ltejedorcruz/TierraViva/memoria/anexos/esquemas_electricos.tex

\chapter{Esquemas eléctricos del prototipo}
\label{anexo:esquemas_electricos}

Este anexo recoge los esquemas eléctricos de referencia utilizados durante el diseño y montaje del prototipo TierraViva.

Los esquemas incluidos tienen carácter técnico y documental. Sirven como apoyo visual para comprender la arquitectura física del montaje y se complementan con las tablas de conexión detalladas recogidas en el manual de instalación.

\section{Esquema general de una estación}

La Figura~\ref{fig:esquema_estacion_tierraviva} muestra el esquema general de una estación TierraViva elaborado en Cirkit Designer. En él se representa la conexión entre la batería de 12 V, el regulador LM2596, el Arduino UNO, los sensores, el módulo LTE A7670E-LASA, el relé y la bomba de 12 V.

\begin{figure}[H]
    \centering
    
    \caption{Esquema eléctrico general de una estación TierraViva elaborado en Cirkit Designer. Elaboración propia.}
    \label{fig:esquema_estacion_tierraviva}
\end{figure}

\section{Bloques representados en el esquema}

El esquema de la estación puede dividirse en varios bloques funcionales:

\begin{itemize}
    \item \textbf{Alimentación}: formada por una batería de 12 V y un regulador LM2596 ajustado a 5 V para alimentar la electrónica de control.
    \item \textbf{Control}: formado por el Arduino UNO, encargado de leer sensores, gestionar comunicaciones y controlar el relé.
    \item \textbf{Sensorización}: formada por el sensor capacitivo de humedad del suelo, el BME280 y el BH1750.
    \item \textbf{Comunicación}: formada por el módulo LTE A7670E-LASA y su antena.
    \item \textbf{Actuación}: formada por el módulo relé y la bomba de agua de 12 V.
    \item \textbf{Protección y estabilización}: formada por resistencias, condensadores, diodo y elementos auxiliares de acondicionamiento eléctrico. Incluye el divisor resistivo de adaptación hacia el módulo LTE, los condensadores de desacoplo de alimentación, el condensador electrolítico de \(2200~\mu\mathrm{F}\) y el diodo asociado a la rama de bomba para mejorar la estabilidad y protección eléctrica durante la conmutación del motor.
\end{itemize}

\section{Correspondencia con el cableado del prototipo}

La Tabla~\ref{tab:correspondencia_esquema_cableado} resume la correspondencia entre los principales bloques del esquema y las conexiones descritas en el manual de instalación.

\begingroup
\renewcommand{\arraystretch}{1.35}
\scriptsize
\rowcolors{2}{TableRowSoft}{white}

\begin{longtable}{|p{0.28\textwidth}|p{0.28\textwidth}|p{0.34\textwidth}|}

\hline
\rowcolor{URJCRed}
\TVHead{Bloque} & \TVHead{Elemento principal} & \TVHead{Función dentro de la estación} \\
\hline
\endfirsthead

\hline
\rowcolor{URJCRed}
\TVHead{Bloque} & \TVHead{Elemento principal} & \TVHead{Función dentro de la estación} \\
\hline
\endhead

\hline
\multicolumn{3}{r}{\small Continúa en la página siguiente} \\
\endfoot

\hline
\endlastfoot

Alimentación & Batería 12 V y LM2596 & Proporcionar alimentación de potencia y tensión regulada de 5 V para la electrónica. \\
\hline
Control & Arduino UNO & Coordinar lectura de sensores, publicación de datos y actuación sobre el relé. \\
\hline
Comunicación & A7670E-LASA & Enviar telemetría a ThingSpeak mediante red móvil LTE. \\
\hline
Sensorización ambiental & BME280 y BH1750 & Medir temperatura, humedad relativa, presión y luminosidad. \\
\hline
Sensorización de suelo & Sensor capacitivo de humedad & Medir el estado hídrico del sustrato mediante entrada analógica. \\
\hline
Actuación & Relé y bomba 12 V & Activar físicamente el riego cuando se cumplen las condiciones definidas. \\
\hline
Protección y estabilización & Divisor resistivo, condensadores y diodo & Acondicionar señales, estabilizar la alimentación y reforzar la protección eléctrica de la rama de actuación. \\
\hline
\caption{Correspondencia entre el esquema eléctrico y los bloques funcionales de la estación.}
\label{tab:correspondencia_esquema_cableado}\\
\end{longtable}

\normalsize
\endgroup

\section{Notas de interpretación}

El esquema debe interpretarse como una representación del prototipo de estación desarrollado en TierraViva. Durante el montaje real deben comprobarse siempre los siguientes puntos:

\begin{itemize}
    \item la salida del LM2596 debe estar ajustada a 5.0 V antes de alimentar el Arduino;
    \item todas las masas deben estar conectadas en común;
    \item el módulo A7670E-LASA debe alimentarse con una tensión compatible con su placa;
    \item la señal desde Arduino hacia el RX del módulo LTE debe adaptarse mediante divisor de tensión;
    \item la bomba de 12 V debe alimentarse desde la línea de potencia correspondiente y conmutarse mediante el relé;
    \item el relé debe utilizar el contacto normalmente abierto para que el sistema arranque con el riego desactivado;
    \item la electrónica debe protegerse frente a humedad, polvo y salpicaduras en pruebas exteriores.
\end{itemize}

\section{Referencias de diseño}

El esquema se ha elaborado como apoyo al montaje físico y a la documentación del prototipo. Durante el desarrollo se ha utilizado una versión de trabajo en Cirkit Designer y documentación auxiliar de conexionado:

\begin{itemize}
    \item Proyecto en Cirkit Designer: \url{https://app.cirkitdesigner.com/project/56e39eeb-b4bb-4151-9afe-028a0ed83c81}
    \item Documento auxiliar de trabajo: \url{https://github.com/ltejedorcruz/TierraViva/raw/main/docs/Circuit_Documentation_TierraViva.pdf}
\end{itemize}
