ltejedorcruz/TierraViva/memoria/capitulos/capitulo5.tex

\chapter{Implementación \textit{hardware} y \textit{firmware} de estaciones}
\label{cap:implementacion_hardware_firmware}

\begin{wrapfigure}{r}{0.22\textwidth}
    \vspace{-12pt}
    \centering
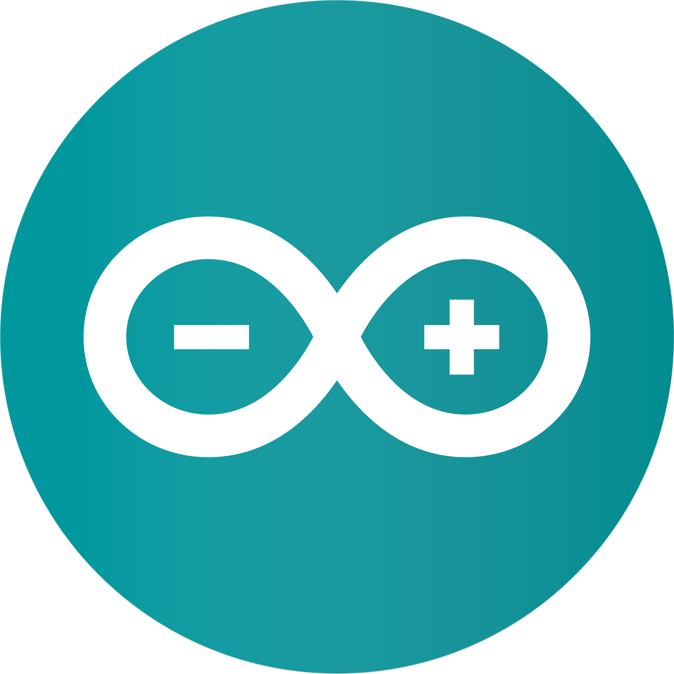
[picture p2: memoria/figs/arduino_logo.png]
    
    \caption{Logotipo de Arduino. Fuente: documentación oficial de marca de Arduino \cite{arduino_logo_guidelines}.}
    \label{fig:logo_arduino}
    \vspace{-8pt}
\end{wrapfigure}

Una vez definida la arquitectura final del sistema, este capítulo documenta la implementación \textit{hardware} y \textit{firmware} de las estaciones de campo de TierraViva. Se describe cómo se preparó, conectó y validó cada bloque de la estación: controlador, sensores, comunicación LTE, publicación de telemetría, actuación sobre el riego y alimentación.

En la arquitectura final, cada estación funciona como un nodo sensor-actuador autónomo: mide variables del entorno, evalúa reglas locales, acciona el riego cuando corresponde y publica su estado operativo. Por ello, la implementación \textit{hardware} y el \textit{firmware} tienen un papel central dentro del prototipo.

La Figura~\ref{fig:flujo_implementacion_estacion} resume la secuencia seguida durante la implementación de cada estación. El desarrollo se abordó por bloques para reducir riesgos: primero se verificó la placa de control, después la sensórica, posteriormente la comunicación LTE/HTTP y, finalmente, la actuación y alimentación del sistema de riego.

\begin{figure}[H]
    \centering
    \makebox[\textwidth][c]{%
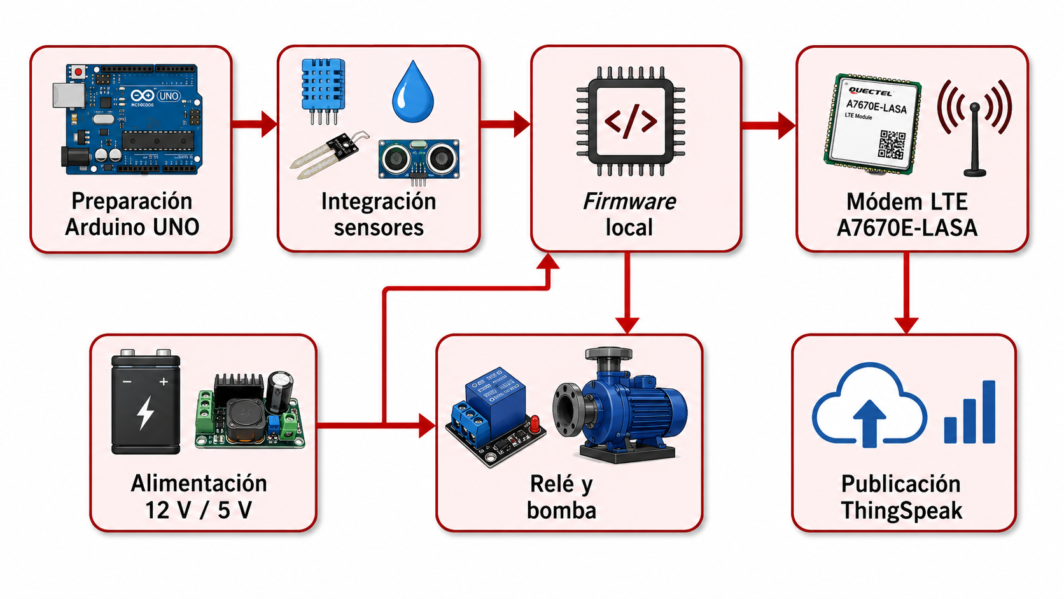
[picture p3: memoria/figs_png/flujo_implementacion_estacion.png]
        %
    }
    \caption{Secuencia de implementación de una estación TierraViva. Elaboración propia, véase Anexo~\ref{sec:uso_ia_generativa_tfg}.}
    \label{fig:flujo_implementacion_estacion}
\end{figure}

\section{Preparación de Arduino UNO}
\label{sec:preparacion_arduino_uno}

La primera fase consistió en verificar que la placa Arduino UNO compatible podía programarse correctamente desde Arduino IDE 2.3.8 en Windows 11. Aunque la placa recibía alimentación por USB, inicialmente no aparecía ningún puerto disponible en el entorno de desarrollo. La inspección del Administrador de dispositivos mostró el dispositivo como \texttt{USB2.0-Serial}, lo que permitió identificar la ausencia del controlador del conversor USB-serie \texttt{CH340G}. Tras instalar el controlador CH340/CH341, la placa quedó asociada al puerto \texttt{COM3} y fue posible cargar correctamente el ejemplo \textit{Blink} \cite{wch_ch340_driver}.

\begin{table}[H]
\begin{center}
\small
\renewcommand{\arraystretch}{1.15}
\rowcolors{2}{TableRowSoft}{white}

\begin{tabular}{|p{0.30\textwidth}|p{0.30\textwidth}|p{0.30\textwidth}|}
\hline
\rowcolor{URJCRed}
\TVHead{Elemento comprobado} & \TVHead{Resultado observado} & \TVHead{Acción realizada} \\
\hline
Sistema operativo & Windows 11 & Preparación del entorno en ordenador. \\
\hline
Entorno de desarrollo & Arduino IDE 2.3.8 & Instalación y configuración inicial. \\
\hline
Placa conectada & Arduino UNO compatible & Selección de placa Arduino Uno. \\
\hline
Detección inicial & \texttt{USB2.0-Serial} sin puerto COM disponible & Diagnóstico de ausencia de controlador. \\
\hline
Conversor USB-serie & \texttt{CH340G} & Instalación del controlador CH340/CH341. \\
\hline
Microcontrolador principal & \texttt{ATmega328P} & Validación de compatibilidad con Arduino UNO. \\
\hline
Puerto tras instalar controlador & \texttt{COM3} & Selección del puerto en Arduino IDE. \\
\hline
Prueba básica & \textit{Blink} cargado correctamente & Verificación de programación de la placa. \\
\hline
\end{tabular}
\caption{Preparación inicial del Arduino UNO compatible}
\label{cuadro:preparacion_arduino_uno}
\end{center}
\end{table}

Una vez identificado el conversor \texttt{CH340G}, se instaló el controlador correspondiente y Windows pasó a reconocer la placa como un dispositivo serie asociado al puerto \texttt{COM3}. A partir de ese momento, el Arduino IDE permitió seleccionar la placa como \textit{Arduino Uno} y cargar programas correctamente.

La primera validación fue el ejemplo \textit{Blink}, utilizado para comprobar la cadena completa de programación: detección USB, selección de placa, selección de puerto, compilación, carga y ejecución en el microcontrolador. La prueba fue correcta, por lo que la placa quedó preparada para integrar sensores, módem LTE y relé.

La identificación del ATmega328P y la correspondencia de pines del Arduino UNO se comprobaron tomando como referencia la documentación técnica y el esquema de pines de la placa \cite{arduino_uno_r3_datasheet,arduino_uno_r3_pinout}.

Esta incidencia se conserva en la memoria porque afecta a la reproducibilidad del prototipo. El uso de placas compatibles reduce el coste, pero puede exigir instalar controladores adicionales. Las evidencias de configuración y carga se recogen dentro del plan de pruebas del Anexo~\ref{anexo:plan_pruebas}.

\section{Integración de sensores}
\label{sec:integracion_sensores}

La integración de sensores se realizó antes de incorporar la comunicación LTE o la actuación, ya que la decisión local de riego depende de que las medidas de entrada sean coherentes. La estación combina sensores digitales conectados al bus I2C con un sensor capacitivo de humedad de suelo leído mediante entrada analógica.

La Figura~\ref{fig:topologia_sensores_estacion} resume esta organización. Los sensores BME280 y BH1750/GY-302 comparten las líneas \texttt{A4/SDA} y \texttt{A5/SCL} del Arduino UNO, mientras que el sensor capacitivo de humedad del suelo se conecta a la entrada \texttt{A0}. Esta separación permitió validar de forma independiente el bus digital y la lectura analógica antes de construir una muestra completa de telemetría.

\begin{figure}[H]
    \centering
    \makebox[\textwidth][c]{%
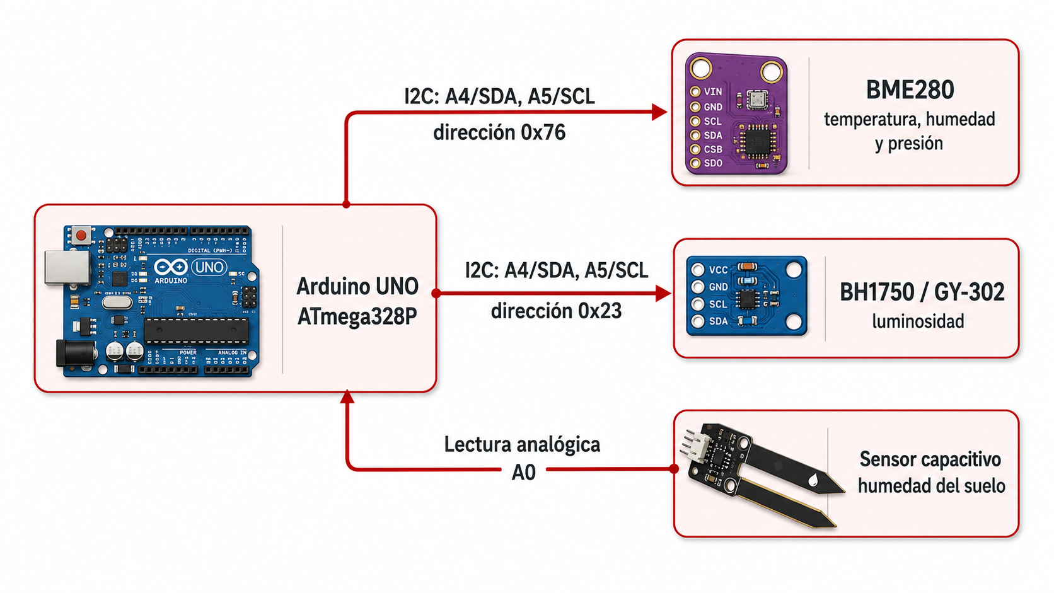
[picture p4: memoria/figs_png/topologia_sensores_estacion.png]
        %
    }
    \caption{Topología de sensórica de una estación TierraViva. Elaboración propia, véase Anexo~\ref{sec:uso_ia_generativa_tfg}.}
    \label{fig:topologia_sensores_estacion}
\end{figure}

\begin{table}[H]
\begin{center}
\small
\renewcommand{\arraystretch}{1.15}
\rowcolors{2}{TableRowSoft}{white}

\begin{tabular}{|p{0.28\textwidth}|p{0.28\textwidth}|p{0.34\textwidth}|}
\hline
\rowcolor{URJCRed}
\TVHead{Prueba} & \TVHead{Resultado} & \TVHead{Interpretación} \\
\hline
Escaneo I2C con BME280 & Dispositivo detectado en \texttt{0x76} & El sensor ambiental responde correctamente en el bus I2C. \\
\hline
Escaneo I2C con BH1750 y BME280 & Dispositivos detectados en \texttt{0x23} y \texttt{0x76} & Ambos sensores pueden compartir el bus I2C sin conflicto de direcciones. \\
\hline
Lectura analógica del sensor de suelo & Valores variables en \texttt{A0} & El sensor capacitivo responde ante cambios de capacitancia/humedad. \\
\hline
Prueba conjunta & Lectura de suelo, luz, temperatura, humedad y presión & Los tres sensores pueden integrarse en un único \textit{firmware} de adquisición. \\
\hline
\end{tabular}
\caption{Pruebas iniciales de validación de sensores}
\label{cuadro:pruebas_iniciales_sensores}
\end{center}
\end{table}

El sensor capacitivo de humedad del suelo se validó mediante lecturas brutas en \texttt{A0}. En reposo mostró valores estables alrededor de \texttt{569--570}, mientras que al modificar las condiciones de contacto descendió aproximadamente al rango \texttt{248--356}. Esta prueba no constituye una calibración agronómica definitiva, pero sí confirmó que el sensor respondía ante cambios físicos y que el sentido de variación era utilizable para la lógica de riego.

La integración conjunta confirmó que el sensor analógico no interfería con el bus I2C y que los sensores digitales podían trabajar simultáneamente. La humedad del suelo se mantuvo inicialmente como lectura dependiente de calibración, mientras que temperatura, humedad relativa, presión y luminosidad se conservaron como variables de contexto para interpretar el estado de la estación. Con ello quedó validado el bloque de sensórica antes de estructurar el \textit{firmware} de adquisición.

\section{\textit{Firmware} de adquisición}
\label{sec:firmware_adquisicion}

Una vez comprobado el funcionamiento de los sensores, el siguiente paso consistió en organizar el \textit{firmware} de adquisición de la estación. Este \textit{firmware} combina la lectura de variables, la preparación de telemetría y la lógica local necesaria para decidir si debe activarse el riego.

El \textit{firmware} se organiza en varios bloques funcionales. En primer lugar, se inicializan los sensores y el módem LTE. Después, en cada ciclo de ejecución, se leen las variables ambientales y de suelo. A partir de esas lecturas, se actualiza el estado interno de seguridad de la estación y se decide si procede activar el riego. Por último, la estación publica una actualización en ThingSpeak con las medidas y el estado operativo.

La Figura~\ref{fig:ciclo_firmware_estacion} sintetiza el ciclo lógico ejecutado por el \textit{firmware} de estación. La estación no depende de una orden externa para cerrar el ciclo de control: mide, valida, decide, actúa si procede y publica el estado resultante.

\begin{figure}[H]
    \centering
    \makebox[\textwidth][c]{%
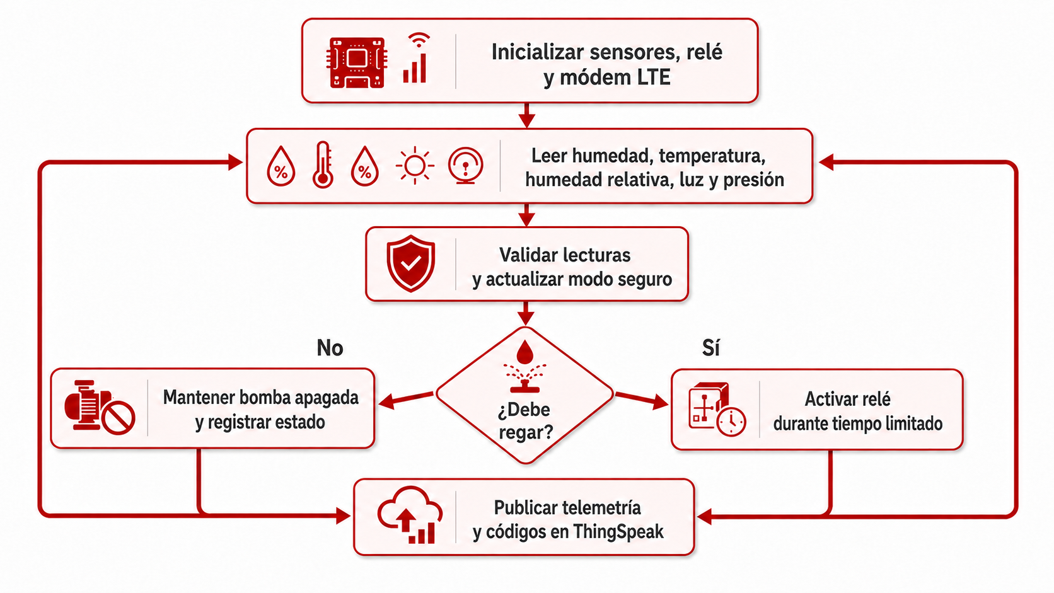
[picture p5: memoria/figs_png/ciclo_firmware_estacion.png]
        %
    }
    \caption{Ciclo lógico del \textit{firmware} de estación. Elaboración propia, véase Anexo~\ref{sec:uso_ia_generativa_tfg}.}
    \label{fig:ciclo_firmware_estacion}
\end{figure}

En la función \texttt{setup()} se configuran el puerto serie de depuración, el bus I2C, los sensores, el pin de relé y el módem LTE. El relé se inicializa en estado desactivado para que un reinicio del Arduino no pueda provocar una activación accidental de la bomba. Durante el ciclo principal, el \textit{firmware} lee las variables de suelo y ambiente, convierte la humedad del suelo a escala porcentual, valida las medidas y actualiza el estado interno de seguridad.

La lógica de decisión se apoya en variables como \texttt{safeMode}, \texttt{sensorOk}, \texttt{validCycleCount} y \texttt{dryCycleCount}. Además, diferencia entre el evento principal del sistema, almacenado en \texttt{systemEventCode}, y el código auxiliar de diagnóstico, almacenado en \texttt{debugCode}. Esta separación permite publicar en ThingSpeak no solo el estado de riego, sino también el motivo de la decisión.

Para evitar que el cuerpo principal de la memoria se convierta en un listado completo de \textit{firmware}, la Tabla~\ref{tab:responsabilidades_firmware_estacion} resume las responsabilidades principales implementadas en el código de estación. El código completo se mantiene en el repositorio del proyecto.

\begin{table}[H]
\centering
\small
\renewcommand{\arraystretch}{1.15}
\rowcolors{2}{TableRowSoft}{white}

\begin{tabular}{|p{0.28\textwidth}|p{0.58\textwidth}|}
\hline
\rowcolor{URJCRed}
\TVHead{Función del \textit{firmware}} & \TVHead{Responsabilidad dentro de la estación} \\
\hline
Lectura de sensores & Obtiene humedad de suelo, temperatura, humedad relativa, luminosidad y presión. \\
\hline
Conversión de humedad & Transforma la lectura analógica del sensor de suelo a una escala porcentual a partir de los valores de referencia configurados. \\
\hline
Validación de medidas & Detecta lecturas ausentes, incoherentes o no utilizables para tomar decisiones de riego. \\
\hline
Modo seguro & Mantiene un comportamiento conservador tras el arranque o ante error de sensores. \\
\hline
Confirmación de sequedad & Evita activar el riego por una lectura aislada o ruidosa. \\
\hline
\textit{cooldown} & Bloquea riegos consecutivos durante un periodo mínimo tras una actuación. \\
\hline
Publicación de estado & Actualiza el estado del relé, el evento de sistema y el código auxiliar de diagnóstico. \\
\hline
\end{tabular}
\caption{Responsabilidades principales del \textit{firmware} de estación.}
\label{tab:responsabilidades_firmware_estacion}
\end{table}

La decisión local se apoya en tres mecanismos: umbral de humedad, confirmación por ciclos consecutivos y tiempo mínimo entre riegos. No se activa el riego por una única lectura aislada, ya que una medida puntual puede verse afectada por ruido, contacto irregular del sensor o pequeñas variaciones del montaje. Además, el periodo de \textit{cooldown} evita activaciones repetidas en poco tiempo.

La función de decisión local se muestra en el Código~\ref{cod:decision_local_riego}. Si existe un error de sensores o un periodo de \textit{cooldown} activo, la estación no permite el riego y actualiza los códigos de estado correspondientes. Si no existe bloqueo, compara la humedad del suelo con el umbral normal o seguro según el estado interno de la estación.

\begin{code}[H]
\begin{lstlisting}[language=C++]
bool shouldIrrigate() {
  if (!sensorOk) {
    systemEventCode = 400;
    debugCode = 400;
    return false;
  }

  if (cooldownActive()) {
    systemEventCode = 429;
    debugCode = 429;
    return false;
  }

  if (safeMode) {
    return (soilPercent <= SAFE_SOIL_THRESHOLD) &&
           (dryCycleCount >= SAFE_CONFIRM_DRY_CYCLES);
  }

  return (soilPercent <= NORMAL_SOIL_THRESHOLD) &&
         (dryCycleCount >= NORMAL_CONFIRM_DRY_CYCLES);
}
\end{lstlisting}
\caption[Decisión local de riego en la estación]{Decisión local de riego en la estación}
\label{cod:decision_local_riego}
\end{code}

Cuando la estación decide regar, la actuación se realiza mediante una función temporizada de \textit{firmware}. Durante el riego, el evento principal se marca como \texttt{210}; al finalizar el intervalo configurado, el relé se apaga explícitamente y el evento pasa a \texttt{211}. De este modo, la parada de la bomba no depende de una orden externa ni de la Raspberry Pi.

Tras la lectura de sensores, la actualización del modo seguro y la posible actuación sobre el relé, el \textit{firmware} prepara el estado de la estación para su publicación. Esta publicación no se desarrolla en detalle en esta sección para evitar duplicidades, ya que la correspondencia completa entre variables y campos de ThingSpeak se documenta en la Sección~\ref{sec:envio_datos_thingspeak}.

De este modo, la estación conserva un ciclo completo de funcionamiento autónomo: mide, interpreta, decide, actúa cuando procede y deja preparado el estado operativo para su envío. La Raspberry Pi puede consultar posteriormente esos datos y representarlos en el \textit{dashboard}, pero no interviene en el cierre del bucle de control.

Las dependencias principales del \textit{firmware}, incluyendo las librerías utilizadas para comunicación serie, bus I2C, lectura de sensores y manejo de cadenas, se resumen en el Anexo~\ref{anexo:manual_instalacion_sistema}.

\section{Integración del A7670E-LASA}
\label{sec:integracion_a7670e}

La integración del A7670E-LASA fue una de las fases más sensibles de la estación, porque concentra comunicación serie, alimentación estable, registro en red móvil y publicación HTTP. Antes de conectarlo al Arduino, el módulo se validó de forma independiente mediante USB y comandos AT, comprobando respuesta básica, tarjeta SIM, cobertura, registro LTE, conectividad IP y capacidad de realizar peticiones HTTP.

\begin{table}[H]
\begin{center}
\small
\renewcommand{\arraystretch}{1.15}
\rowcolors{2}{TableRowSoft}{white}

\begin{tabular}{|p{0.30\textwidth}|p{0.26\textwidth}|p{0.34\textwidth}|}
\hline
\rowcolor{URJCRed}
\TVHead{Elemento comprobado} & \TVHead{Resultado} & \TVHead{Interpretación} \\
\hline
Puerto AT por USB & Correcto & El ordenador podía comunicarse con el módem mediante comandos AT. \\
\hline
Respuesta básica del módulo & Correcta & El comando \texttt{AT} devolvía respuesta válida. \\
\hline
Tarjeta SIM & Correcta & La SIM estaba preparada para operar en red. \\
\hline
Cobertura & Buena & La calidad de señal era suficiente para continuar las pruebas. \\
\hline
Registro LTE & Correcto & El módulo conseguía registrarse en la red móvil. \\
\hline
Datos móviles & Correctos & El módem obtenía conectividad IP. \\
\hline
Ping & Correcto & Se comprobó conectividad hacia Internet. \\
\hline
HTTP GET & Correcto & Se validó la capacidad de realizar peticiones HTTP y leer la respuesta. \\
\hline
\end{tabular}
\caption{Validación previa del módulo A7670E-LASA}
\label{cuadro:validacion_previa_a7670e}
\end{center}
\end{table}

Una vez validado el módulo por separado, se abordó la conexión con Arduino UNO. La comunicación se realiza mediante interfaz UART y comandos AT. Como el puerto serie \textit{hardware} del Arduino se utiliza también para programación y depuración por USB, se empleó \texttt{SoftwareSerial} para crear un puerto serie adicional destinado al módem. En el montaje de la estación se mantuvieron los pines \texttt{D10} y \texttt{D11}, ya cableados y probados durante las fases anteriores.

El pin \texttt{D10} del Arduino se utiliza como recepción del puerto serie software y se conecta al pin \texttt{TXD} del A7670E-LASA. El pin \texttt{D11} se utiliza como transmisión hacia el módem y se conecta al pin \texttt{RXD} del A7670E-LASA mediante un divisor resistivo. Esta adaptación es necesaria porque Arduino UNO trabaja con niveles lógicos de 5 V, mientras que la entrada serie del módulo no debe recibir directamente ese nivel si no existe adaptación integrada.

El divisor resistivo se dimensiona mediante la Ecuación~\ref{ec:divisor_resistivo_rxd}.

\begin{myequation}[h]
\begin{equation}
V_{\mathrm{RXD}} =
V_{\mathrm{TX,Arduino}}
\cdot
\frac{R_2}{R_1 + R_2}
\label{ec:divisor_resistivo_rxd}
\end{equation}
\caption[Cálculo de la tensión de salida del divisor resistivo]{Cálculo de la tensión aplicada a la entrada RXD del A7670E-LASA mediante un divisor resistivo}
\end{myequation}

En esta expresión, \(V_{\mathrm{TX,Arduino}}\) representa la tensión de salida del pin de transmisión del Arduino, \(R_1\) la resistencia situada entre el pin \texttt{D11} y el nodo conectado a \texttt{RXD}, y \(R_2\) la resistencia situada entre dicho nodo y masa. El objetivo de este divisor no es modificar la información transmitida por la UART, sino adaptar el nivel eléctrico de la señal para que la entrada \texttt{RXD} del módem no reciba directamente el nivel lógico de 5 V procedente del Arduino UNO.

La señal en sentido contrario, desde \texttt{TXD} del A7670E-LASA hacia \texttt{D10} del Arduino, no requiere el mismo divisor porque no procede de una salida lógica de 5 V del Arduino. Por tanto, la adaptación se aplica únicamente en el sentido Arduino~\(\rightarrow\)~módem.

La alimentación del módulo se trató como un aspecto crítico. Los módulos de comunicación celular pueden presentar consumos variables, especialmente durante el registro en red y la transmisión de datos, por lo que la alimentación y el cableado deben respetar las recomendaciones de diseño del fabricante y de la placa de evaluación utilizada \cite{simcom_a7670_hardware_design,waveshare_a7670e_hat}. En la estación, la alimentación parte de una fuente principal de 12 V y se regula mediante el LM2596 ajustado a 5 V para los elementos compatibles.

La integración funcional del módem se organizó en las fases resumidas en la Tabla~\ref{tab:fases_integracion_a7670e}. El detalle completo de comandos AT no se incluye en el cuerpo principal para evitar convertir el capítulo en una referencia de \textit{firmware}; se conserva en el código fuente del repositorio.

\begin{table}[H]
\centering
\small
\renewcommand{\arraystretch}{1.15}
\rowcolors{2}{TableRowSoft}{white}

\begin{tabular}{|p{0.26\textwidth}|p{0.58\textwidth}|}
\hline
\rowcolor{URJCRed}
\TVHead{Fase} & \TVHead{Comprobación realizada} \\
\hline
Comunicación básica & El módem responde a comandos AT desde Arduino. \\
\hline
SIM y red & La tarjeta SIM está operativa y el módulo consigue registrarse en red LTE. \\
\hline
Datos móviles & Se configura el APN y se activa el contexto de datos. \\
\hline
Conectividad IP & El módulo obtiene conectividad y puede ejecutar peticiones HTTP. \\
\hline
Publicación & La estación envía una actualización HTTP al canal ThingSpeak correspondiente. \\
\hline
Robustez & Si falla la red, el \textit{firmware} no bloquea indefinidamente el ciclo principal. \\
\hline
\end{tabular}
\caption{Fases funcionales de integración del A7670E-LASA.}
\label{tab:fases_integracion_a7670e}
\end{table}

En el \textit{firmware}, la comunicación con el módem se estabilizó a \texttt{9600} baudios, ya que \texttt{SoftwareSerial} en Arduino UNO puede volverse inestable a velocidades superiores. La configuración final combinó pines \texttt{D10}/\texttt{D11}, divisor resistivo hacia \texttt{RXD}, secuencia AT, activación de datos móviles y envío HTTP.

La gestión de errores se resolvió de forma conservadora: si el módem no responde, si el registro LTE no se completa, si falla el contexto de datos o si la respuesta HTTP no es válida, la estación marca la conectividad como no preparada y reintenta posteriormente sin bloquear el ciclo principal. Además, se tuvo en cuenta la memoria SRAM limitada del Arduino UNO, evitando URLs impresas completas, cadenas excesivas y búferes sobredimensionados.

El resultado de esta fase fue la integración estable del A7670E-LASA dentro de la estación de campo. El módulo quedó conectado al Arduino mediante UART software, con adaptación de nivel en la línea hacia \texttt{RXD}, alimentación estabilizada y una secuencia de comandos capaz de registrar el módem en red, activar datos móviles y realizar peticiones HTTP. El conexionado eléctrico, la adaptación de nivel y la alimentación estabilizada del módem se documentan en el Anexo~\ref{anexo:esquemas_electricos}.

\section{Envío de datos a ThingSpeak}
\label{sec:envio_datos_thingspeak}

Una vez integrados los sensores y validado el módulo LTE, la estación publica su telemetría en ThingSpeak mediante una petición HTTP GET de actualización de canal \cite{thingspeak_write_data}. El \textit{firmware} construye la URL de escritura con la clave de actualización del canal y los campos correspondientes a las variables medidas y al estado operativo de la estación. En la secuencia AT utilizada, esta operación se ejecuta mediante \texttt{AT+HTTPACTION=0}, donde el valor \texttt{0} corresponde a una operación HTTP GET.

La correspondencia completa entre \texttt{field1}--\texttt{field8}, variables internas y códigos de estado se documenta en el Anexo~\ref{anexo:estructura_thingspeak_estados}. En este capítulo interesa destacar el criterio de implementación: la publicación se considera correcta únicamente cuando el módem informa de una respuesta HTTP con código 200.

La Figura~\ref{fig:confirmacion_http_thingspeak} resume el criterio seguido por el \textit{firmware} para interpretar una publicación como correcta.

\begin{figure}[H]
\centering
\resizebox{\textwidth}{!}{%
\begin{tikzpicture}[
    node distance=1.8cm,
    actor/.style={
        draw=URJCRed,
        very thick,
        rounded corners,
        align=center,
        minimum width=3.0cm,
        minimum height=0.9cm,
        fill=URJCRed!8
    },
    msg/.style={-Latex, thick, draw=URJCRed!85!black},
    note/.style={align=center, font=\scriptsize}
]

\node[actor] (fw) {\textit{Firmware}\\Arduino UNO};
\node[actor, right=of fw] (modem) {A7670E-LASA\\módem LTE};
\node[actor, right=of modem] (net) {Red LTE\\Internet};
\node[actor, right=of net] (ts) {ThingSpeak\\canal};

\foreach \x in {fw,modem,net,ts}
    \draw[dashed, URJCRed!45] (\x.south) -- ++(0,-5.8);

\draw[msg] ([yshift=-1.0cm]fw.south) -- node[above, note] {Comando AT\\\texttt{AT+HTTPACTION=0}} ([yshift=-1.0cm]modem.south);

\draw[msg] ([yshift=-2.0cm]modem.south) -- node[above, note] {Petición HTTP\\actualización de canal} ([yshift=-2.0cm]net.south);

\draw[msg] ([yshift=-2.8cm]net.south) -- node[above, note] {Solicitud de escritura\\con campos \texttt{field1--field8}} ([yshift=-2.8cm]ts.south);

\draw[msg] ([yshift=-3.6cm]ts.south) -- node[above, note] {Respuesta HTTP\\\texttt{200 OK}} ([yshift=-3.6cm]net.south);

\draw[msg] ([yshift=-4.4cm]net.south) -- node[above, note] {Resultado de la operación} ([yshift=-4.4cm]modem.south);

\draw[msg] ([yshift=-5.2cm]modem.south) -- node[above, note] {\texttt{+HTTPACTION: 0,200,len}} ([yshift=-5.2cm]fw.south);

\node[note, below=5.9cm of modem] {
El \textit{firmware} interpreta el código HTTP 200 como confirmación funcional de publicación correcta.
};

\end{tikzpicture}
}
\caption{Confirmación funcional de publicación HTTP GET desde la estación hacia ThingSpeak. Elaboración propia, véase Anexo~\ref{sec:uso_ia_generativa_tfg}.}
\label{fig:confirmacion_http_thingspeak}
\end{figure}

La publicación de datos desde la estación se confirma a nivel de aplicación mediante el código de respuesta HTTP devuelto por ThingSpeak. Una vez habilitada la conectividad IP sobre LTE y ejecutada la petición HTTP GET, el \textit{firmware} interpreta la respuesta \texttt{+HTTPACTION: 0,200,len} como una publicación correcta, al indicar que la operación GET ha recibido un código HTTP 200.

Los reintentos se plantean de forma controlada: si una publicación falla, la estación vuelve a intentarlo en el siguiente ciclo de telemetría, evitando bucles indefinidos que puedan bloquear el \textit{firmware} o aumentar el consumo. Además, un fallo de publicación no afecta directamente a la seguridad del riego, ya que la decisión de actuación permanece en la estación. La consecuencia principal de una pérdida temporal de conectividad es la ausencia de una muestra en la nube, no la pérdida del control local de la bomba.

\section{Actuación y alimentación de la estación}
\label{sec:control_rele_led_bomba}
\label{sec:alimentacion_estacion}

La actuación física sobre el riego se realiza mediante un módulo relé controlado desde el Arduino UNO. El Arduino no alimenta la bomba directamente: únicamente gobierna la señal de control del relé, mientras que la bomba de agua recibe alimentación desde la línea de 12 V. Esta separación evita que la corriente de potencia circule por el microcontrolador y permite mantener un estado seguro por defecto.

La Figura~\ref{fig:alimentacion_actuacion_estacion} resume la distribución eléctrica utilizada en la estación. La línea principal de 12 V alimenta la carga de actuación y sirve como entrada al regulador LM2596, ajustado a 5 V para alimentar la electrónica de control. Todos los bloques comparten masa común para que las señales digitales, la comunicación serie y las lecturas de sensores tengan una referencia eléctrica válida.

\begin{figure}[H]
    \centering
    \makebox[\textwidth][c]{%
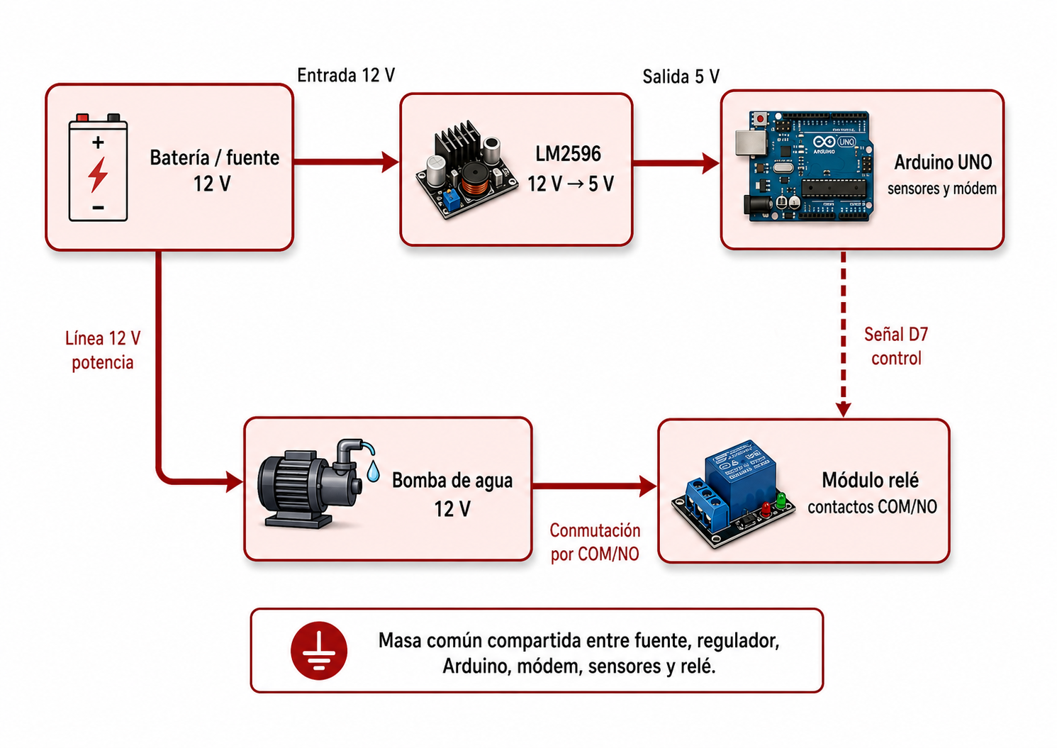
[picture p6: memoria/figs_png/alimentacion_actuacion_estacion.png]
        %
    }
\caption{Distribución de alimentación y actuación en una estación TierraViva. Elaboración propia, véase Anexo~\ref{sec:uso_ia_generativa_tfg}.}
\label{fig:alimentacion_actuacion_estacion}
\end{figure}

El pin digital \texttt{D7} se utiliza para controlar el relé. Este se inicializa apagado desde el arranque, de forma que un reinicio de la placa no pueda activar accidentalmente la bomba. La conexión de potencia utiliza los contactos \texttt{COM} y \texttt{NO}; al emplear el contacto normalmente abierto, la bomba permanece apagada mientras no exista una activación expresa desde el \textit{firmware}.

\begin{table}[H]
\centering
\small
\renewcommand{\arraystretch}{1.15}
\rowcolors{2}{TableRowSoft}{white}

\begin{tabular}{|p{0.30\textwidth}|p{0.54\textwidth}|}
\hline
\rowcolor{URJCRed}
\TVHead{Criterio aplicado} & \TVHead{Justificación técnica} \\
\hline
Relé apagado al arrancar & Evita activaciones accidentales durante reinicios. \\
\hline
Contacto normalmente abierto & La bomba permanece apagada si no existe activación expresa. \\
\hline
Actuación temporizada & La parada de la bomba no depende de una orden externa. \\
\hline
\textit{cooldown} entre riegos & Evita activaciones repetidas por ruido o lecturas inestables. \\
\hline
Separación 12 V / 5 V & La corriente de potencia no circula por el Arduino. \\
\hline
Condensador y diodo en la rama de bomba & Refuerzan la estabilidad y protección eléctrica del bloque de actuación durante la conmutación del motor. \\
\hline
Masa común & Garantiza una referencia eléctrica válida para señales y comunicación. \\
\hline
\end{tabular}
\caption{Criterios de seguridad aplicados a actuación y alimentación.}
\label{tab:criterios_seguridad_actuacion}
\end{table}

Antes de conectar los módulos electrónicos, el LM2596 debe ajustarse y verificarse con multímetro, siguiendo las recomendaciones básicas de uso del módulo reductor \cite{azdelivery_lm2596s_manual}. Esta comprobación evita aplicar una tensión incorrecta al Arduino, sensores o módem. El módulo A7670E-LASA requiere especial atención porque los módulos de comunicación celular pueden presentar picos de consumo durante el registro en red y la transmisión de datos; por ello se incorporan condensadores de estabilización próximos a su entrada de alimentación.

Desde el punto de vista funcional, la bomba se activa únicamente durante el intervalo configurado por \textit{firmware}. Ante una lectura inválida, una condición interna incoherente o un periodo de \textit{cooldown} activo, la estación mantiene la bomba apagada y publica los códigos de estado correspondientes cuando la comunicación está disponible.

La bomba de agua se comporta como una carga de motor y puede introducir perturbaciones eléctricas durante el arranque, la parada o la conmutación mediante el relé. Para mejorar la estabilidad del bloque de actuación se incorporó un condensador electrolítico de \(2200~\mu\mathrm{F}\) en la rama de alimentación de la bomba, conectado entre el nodo positivo conmutado por el relé y la masa común. Además, incorpora un diodo asociado a esta rama de actuación, situado junto al condensador y al bloque de bomba. Su función es actuar como elemento local de apoyo energético y filtrado, reduciendo variaciones bruscas de tensión asociadas al funcionamiento del motor.

Aunque el sistema se valida inicialmente con una batería de 12 V, la arquitectura deja preparada una evolución hacia alimentación autónoma mediante panel solar. Esta ampliación no se considera validada en el prototipo actual, ya que requeriría dimensionar batería, panel y regulador de carga a partir del consumo real de Arduino, sensores, módem LTE, relé, bomba, frecuencia de telemetría y tiempos de actuación.

El detalle de conexiones, alimentación y protección eléctrica se recoge en el Anexo~\ref{anexo:esquemas_electricos}. El flujo de actuación y respuesta ante fallos se resume en el Anexo~\ref{anexo:diagramas_flujo_funcionamiento}.
