ltejedorcruz/TierraViva/memoria/portada/portada.tex

\thispagestyle{empty}
\vspace{2cm}

\begin{figure}[htb]
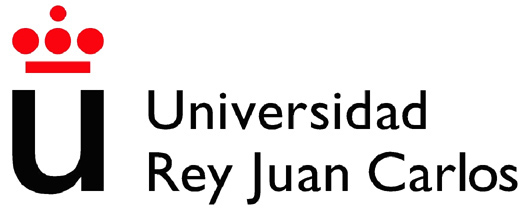
[picture p12: memoria/figs/logo_urjc.jpg]
  \hspace{-0.5cm}\centerline{\resizebox{.55\textwidth}{!}{}}
\end{figure}

\begin{center}
  \vspace{0.7cm}

  \hspace{-1.5cm}{\Large{ESCUELA DE INGENIERÍA DE FUENLABRADA}}

  \vspace{1.5cm}

  \hspace{-1.5cm}{\Large {GRADO EN INGENIERÍA EN\\ 
  \hspace{-1.5cm}\vspace{3mm} TECNOLOGÍAS DE LA TELECOMUNICACIÓN}}

  \vspace{1.5cm}

  \hspace{-1.5cm}{\Large \bf {TRABAJO FIN DE GRADO}}

  \vspace{1.5cm}

  \hspace{-1.5cm} {\large {TierraViva\\
  \hspace{-1.5cm}        Monitorización sostenible y riego inteligente en cultivos desatendidos}}

  \vspace{3.5cm}

  \hspace{-1.5cm}{\bf Autora}: Lucía Tejedor de la Cruz\\ \vspace{3mm}
  \hspace{-1.5cm}{\bf Tutor}: Francisco Javier Simó Reigadas \\ \vspace{3mm}
  \hspace{-1.5cm}{\bf (Co-Tutora)}: Ana Zazo Moratalla

  \vspace{3.5cm}

  \hspace{-1.5cm}{\large {Curso académico 2025-2026}}
\end{center}

\clearpage
\thispagestyle{empty}
