ltejedorcruz/TierraViva/memoria/portada/licencia.tex

\cleardoublepage

\begin{flushright}
\begin{figure}
 \ \ \ \ 
 \label{fig:cc} 
 \end{figure}
\end{flushright}

\noindent
Este trabajo se distribuye bajo los términos de la licencia internacional \href{http://creativecommons.org/licenses/by-sa/4.0/}{CC BY-SA International License} (Creative Commons Attribution-ShareAlike 4.0). Usted es libre de \textit{(a) compartir}: copiar y redistribuir el material en cualquier medio o formato para cualquier propósito, incluso comercialmente; y \textit{(b) adaptar}: remezclar, transformar y construir a partir del material para cualquier propósito, incluso comercialmente. La licenciante no puede revocar estas libertades en tanto usted siga los términos de la licencia:

\begin{itemize}
\item \textit{Atribución}. Usted debe dar \href{https://creativecommons.org/licenses/by-sa/4.0/deed.es#ref-appropriate-credit}{crédito de manera adecuada}, brindar un enlace a la licencia, e indicar \href{https://creativecommons.org/licenses/by-sa/4.0/deed.es#ref-indicate-changes}{si se han realizado cambios}. Puede hacerlo en cualquier forma razonable, pero no de forma tal que sugiera que usted o su uso tienen el apoyo de la licenciante.
\item \textit{Compartir igual}. Si remezcla, transforma o crea a partir del material, debe distribuir su contribución bajo la \href{https://creativecommons.org/licenses/by-sa/4.0/deed.es#ref-same-license}{misma licencia} del original.\\
No hay restricciones adicionales — No puede aplicar términos legales ni \href{https://creativecommons.org/licenses/by-sa/4.0/deed.es#ref-technological-measures}{medidas tecnológicas} que restrinjan legalmente a otras a hacer cualquier uso permitido por la licencia.
\end{itemize}

Salvo indicación expresa en contrario, el texto, las figuras de elaboración propia, las fotografías propias, las capturas propias y la documentación generada por la autora se distribuyen bajo licencia Creative Commons Atribución-CompartirIgual 4.0 Internacional. Los logotipos, marcas, capturas de plataformas externas y demás elementos de terceros incluidos en la memoria se citan con su fuente correspondiente y permanecen sujetos a sus respectivas condiciones de uso.

El software desarrollado en el marco del proyecto TierraViva se distribuye bajo licencia MIT, identificada mediante el marcador SPDX \texttt{MIT} en los ficheros fuente correspondientes.

\begin{flushright}
		\emph{Documento de} \textbf{Lucía Tejedor de la Cruz}.
\end{flushright}
