ltejedorcruz/TierraViva/memoria/portada/acronimos.tex

\cleardoublepage

\chapter*{Acrónimos\markboth{Acrónimos}{Acrónimos}}

\begin{acronym}
	\acro{IoT}{\emph{Internet of Things}}
	\acro{IA/AI}{\emph{Inteligencia Artificial/Artificial Intelligence}}
	\acro{API}{\emph{Application Programming Interface}}
	\acro{LPWAN}{\emph{Low Power Wide Area Networks}}
	\acro{LTE}{\emph{Long Term Evolution}}
	\acro{HTTP}{\emph{Hypertext Transfer Protocol}}
	\acro{IP}{\emph{Internet Protocol}}
	\acro{MQTT}{\emph{Message Queuing Telemetry Transport}}
	\acro{CoAP}{\emph{Constrained Application Protocol}}
	\acro{GPIO}{\emph{General Purpose Input/Output}}
	\acro{SIM}{\emph{Subscriber Identity Module}}
\end{acronym}
