ltejedorcruz/TierraViva/memoria/memoria.pdf

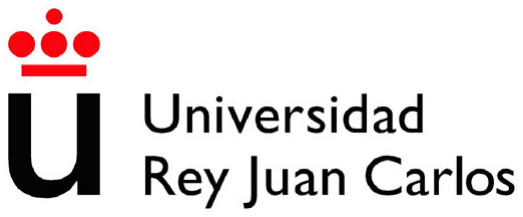
[picture p33: figure]

## ESCUELA DE INGENIERÍA DE FUENLABRADA

## GRADO EN INGENIERÍA EN TECNOLOGÍAS DE LA TELECOMUNICACION´

## TRABAJO FIN DE GRADO

### TierraViva Monitorización sostenible y riego inteligente en cultivos desatendidos

Autora: Lucía Tejedor de la Cruz

Tutor: Francisco Javier Simó Reigadas

(Co-Tutora): Ana Zazo Moratalla

### Curso académico 2025-2026

Este trabajo se distribuye bajo los términos de la licencia internacional CC BY-SA

International License (http://creativecommons.org/licenses/by-sa/4.0/) (Creative Commons Attribution-ShareAlike 4.0). Usted es libre

de (a) compartir : copiar y redistribuir el material en cualquier medio o formato para

cualquier propósito, incluso comercialmente; y (b) adaptar : remezclar, transformar y

construir a partir del material para cualquier propósito, incluso comercialmente. La

licenciante no puede revocar estas libertades en tanto usted siga los términos de la

licencia:

Atribución. Usted debe dar crédito de manera adecuada, (https://creativecommons.org/licenses/by-sa/4.0/deed.es#ref-appropriate-credit) brindar un enlace a la

licencia, e indicar si se han realizado cambios. (https://creativecommons.org/licenses/by-sa/4.0/deed.es#ref-indicate-changes) Puede hacerlo en cualquier forma

razonable, pero no de forma tal que sugiera que usted o su uso tienen el apoyo

de la licenciante.

Compartir igual. Si remezcla, transforma o crea a partir del material, debe

distribuir su contribución bajo la misma licencia (https://creativecommons.org/licenses/by-sa/4.0/deed.es#ref-same-license) del original.

No hay restricciones adicionales — No puede aplicar términos legales ni medidas

tecnológicas (https://creativecommons.org/licenses/by-sa/4.0/deed.es#ref-technological-measures) que restrinjan legalmente a otras a hacer cualquier uso permitido

por la licencia.

Documento de Lucía Tejedor de la Cruz.

# Agradecimientos

Unas bonitas palabras...

Quizás un segundo párrafo esté bien. No te olvides de nadie.

Un tercero tampoco viene mal para contar alguna anécdota...

¿Alguien más? Aunque sean actores secundarios.

Un quinto párrafo como colofón.

A mi abuela, mi mejor amiga;

nuestra Toyi

Madrid, 26 de mayo de 2026

Lucía Tejedor

# Resumen

Escribe aquí el resumen del trabajo. Un primer párrafo para dar contexto sobre la

temática que rodea al trabajo.

Un segundo párrafo concretando el contexto del problema abordado.

En el tercer párrafo, comenta cómo has resuelto la problemática descrita en el

anterior párrafo.

Por último, en este cuarto párrafo, describe cómo han ido los experimentos.

iv

´

# Indice general

Prólogo | XIII
1. Introducción | 1
2. Estado del arte y fundamentos tecnológicos | 10
3. Métodos, materiales y decisiones de diseño | 31
3.8. Selección de solución de comunicaciones para estaciones remotas . . . . | 53

v

ÍNDICE GENERAL | vi
3.10. Elección de arquitectura software de supervisión en Raspberry Pi . . . | 61
4. Arquitectura final de TierraViva | 72
5. Implementación hardware y firmware de estaciones | 88
A. Materiales y componentes empleados | 121
B. Esquemas eléctricos y conexiones | 124
C. Pruebas iniciales de sensores | 125
D. Validación del módulo LTE A7670E-LASA | 126
E. Fragmentos de código relevantes | 127
F. Estructura de canales ThingSpeak y codificación de comandos | 128
Bibliografía | 129

´

# Indice de figuras

1.1. Evolución conceptual desde un riego basado en rutinas fijas hacia un
riego apoyado en medidas reales del entorno. Elaboración propia | 2
1.2. Delimitación del alcance del prototipo TierraViva y de los aspectos que
quedan fuera de esta fase del trabajo. Elaboración propia | 7
2.1. Cadena funcional básica de un sistema IoT. El sistema capta información

del entorno mediante sensorización, la transmite a través de una red, la

almacena, la procesa y, cuando procede, actúa sobre el mundo físico

cerrando el bucle de control | 11
2.2. Arquitectura IoT organizada por capas funcionales. La capa física

agrupa sensores y actuadores; el nodo o borde proporciona

procesamiento local; la conectividad permite el intercambio de

información; la plataforma gestiona datos y servicios; y la aplicación

facilita la visualización e interacción con el usuario | 14
2.3. Componentes básicos de un nodo IoT. Un nodo integra sensores para

observar el entorno, actuadores para ejecutar acciones, una unidad de

procesamiento, un subsistema de comunicaciones y una fuente de energía

que condiciona su autonomía | 19
2.4. Criterios principales para seleccionar una tecnología de comunicación

en un sistema IoT. La elección depende del equilibrio entre alcance,

consumo energético, volumen de datos, frecuencia de envío, número de

nodos y movilidad del escenario de aplicación | 22
2.5. Distribución del procesamiento en arquitecturas IoT. El procesamiento

puede situarse cerca del dispositivo, en el borde de la red, en capas

intermedias tipo fog o en plataformas cloud, según los requisitos de

latencia, ancho de banda, autonomía, disponibilidad de conectividad y

capacidad de análisis | | 25
3.1. Arquitectura general planteada para TierraViva | | 46

vii

ÍNDICE DE FIGURAS | viii
4.1. Arquitectura final de TierraViva con decisión local en las estaciones. . . | 73
4.2. Canales ThingSpeak creados para las estaciones de TierraViva | | 79

B.1. Esquema de conexión de una estación de campo de TierraViva. En la

fase de prueba se representa un LED como carga de verificación; en el

montaje final se sustituye por la bomba de agua de 12 V controlada

mediante relé | 124

# Listado de códigos

5.1. Lectura agrupada de sensores en la estación | | 96
5.2. Comprobación del periodo de espera entre riegos | | 96
5.3. Decisión local de riego en la estación | | 97
5.4. Activación temporizada del relé de riego | | 97
5.5. Estructura de la petición HTTP de telemetría | | 98
5.6. Configuración serie del A7670E en Arduino UNO | 102
5.7. Detección de velocidad serie del módulo LTE | 102
5.8. Comprobación de registro LTE del A7670E | 104
5.9. Petición HTTP GET mediante el A7670E | 106
5.10. Construcción de la URL de actualización de ThingSpeak | 109
5.11. Envío de telemetría a ThingSpeak | 110
5.12. Definición del pin y estados del relé | 113
5.13. Inicialización segura del relé | 113
5.14. Activación temporizada del relé | 114
5.15. Desactivación segura del relé | 114
5.16. Supervisión del estado del relé | 115

ix

# Listado de ecuaciones

x

´

# Indice de tablas

2.1. Comparación general entre sensores analógicos y digitales | 18
2.2. Comparación general entre microcontroladores y computadores de placa
reducida | | 21
2.3. Comparación general de tecnologías de conectividad para IoT en campo | 24
2.4. Comparación general entre HTTP, MQTT y CoAP en sistemas IoT . . | 28
3.1. Requisitos funcionales del sistema TierraViva | | 33
3.2. Requisitos no funcionales del sistema TierraViva | | 36
3.3. Especificaciones temporales y operativas iniciales del sistema | | 39
3.4. Fases principales de la metodología de trabajo | | 42
3.5. Variables seleccionadas para la monitorización de TierraViva | | 47
3.6. Sensores seleccionados para las estaciones de campo | | 49
3.7. Comparación funcional entre Arduino UNO y Raspberry Pi 5 en
TierraViva | | 52
3.8. Comparación entre LoRa/LoRaWAN y LTE para TierraViva | | 56
3.9. Uso previsto de ThingSpeak dentro de TierraViva | | 59
3.10. Bloques principales de la arquitectura software de supervisión en
Raspberry Pi | | 64
3.11. Resumen de materiales principales empleados en TierraViva | | 66
3.12. Riesgos técnicos principales y medidas de mitigación | | 69
4.1. Configuración lógica de las estaciones de campo | | 74
4.2. Bloques internos de una estación de campo | | 75
4.3. Fases de comunicación LTE/HTTP en una estación de campo | | 77
4.4. Asignación de campos en los canales ThingSpeak de estación | | 80
4.5. Funciones principales de la Raspberry Pi dentro de TierraViva | | 82
4.6. Códigos de estado o evento publicados por las estaciones | | 85
4.7. Situaciones contempladas por el modo seguro de la estación | | 86
5.1. Preparación inicial del Arduino UNO compatible | | 89

xi

ÍNDICE DE TABLAS | xii
5.2. Conexiones de los sensores integrados en la estación de campo | | 91
5.3. Pruebas iniciales de validación de sensores | | 92
5.4. Variables obtenidas en la prueba conjunta de sensores | | 93
5.5. Bloques principales del firmware de adquisición y decisión local | | 95
5.6. Campos de telemetría enviados por el firmware de estación | | 98
5.7. Validación previa del módulo A7670E-LASA | 100
5.8. Conexiones principales entre Arduino UNO y el A7670E-LASA | 101
5.9. Comandos AT utilizados en la inicialización de red del A7670E | 103
5.10. Secuencia HTTP utilizada con el módulo A7670E | 105
5.11. Mapeo de variables del firmware a campos de ThingSpeak | 108
5.12. Errores considerados durante el envío de telemetría a ThingSpeak . . . 111
5.13. Conexiones principales del bloque de actuación mediante relé | 112
5.14. Comportamiento del bloque de actuación ante distintas condiciones . . 115
5.15. Distribución de alimentación en la estación de campo | 117
5.16. Condensadores de estabilización en la alimentación del A7670E | 118
A.1. Resumen de componentes empleados en TierraViva | 122
A.2. Referencias comerciales de sensores empleados | 123

# Prólogo

La idea de TierraViva nace de una situación cercana. En mi familia hay un pequeño

huerto en el pueblo y, especialmente en épocas de calor, aparece siempre el mismo

problema: no es posible revisarlo todas las semanas. A veces las plantas reciben menos

agua de la necesaria y otras veces ocurre lo contrario, porque el riego depende de visitas

puntuales, de la intuición y de la disponibilidad de cada momento.

La frase que terminó de dar forma a la idea surgió casi en broma. Un día, hablando

sobre estos problemas, mi tío me dijo: “¿No vas a ser ingeniera? Pues arréglame el

huerto”. Aunque fue un comentario informal, planteaba un problema muy real: cómo

conocer el estado de un cultivo cuando no se está físicamente allí y cómo actuar sobre

el riego sin depender siempre de una revisión manual.

A partir de esa necesidad surgió la posibilidad de desarrollar un sistema capaz

de medir el entorno, enviar información, visualizar el estado del cultivo y actuar

sobre el riego de forma controlada. Lo que inicialmente parecía una solución sencilla

fue tomando forma como un problema de ingeniería más completo, en el que

intervienen sensorización, comunicaciones, sistemas embebidos, almacenamiento de

datos, visualización y control.

xiii

## Capítulo 1

# Introducción

Este capítulo sitúa TierraViva dentro del contexto de la digitalización agrícola y del

riego inteligente. A partir de una necesidad práctica (supervisar y actuar sobre el riego

sin depender siempre de una revisión presencial) se introduce el problema técnico, la

motivación del trabajo, su alcance y la organización de la memoria.

1.1. | Contexto | general: | agricultura, | agua | y

## digitalización

La agricultura es una de las actividades en las que el uso eficiente de los

recursos tiene un impacto más directo, tanto desde el punto de vista económico

como medioambiental. Entre todos los recursos implicados, el agua ocupa un papel

especialmente importante, ya que condiciona de forma directa el desarrollo de los

cultivos y, al mismo tiempo, es un recurso limitado que debe gestionarse con cuidado.

Según AQUASTAT, el uso agrícola supone alrededor del 69 % de las extracciones

mundiales de agua [Food and Agriculture Organization of the United Nations, 2021].

En este contexto, el riego no puede entenderse únicamente como una tarea rutinaria,

sino como una decisión técnica que depende de múltiples factores: el estado del suelo,

las condiciones ambientales, el tipo de cultivo, la época del año y la disponibilidad de

agua.

Tradicionalmente, muchos sistemas de riego se han basado en criterios fijos, como

horarios predefinidos o estimaciones manuales del estado del terreno. Aunque este

enfoque puede ser suficiente en determinadas situaciones, existen limitaciones claras.

Un riego programado de forma rígida puede aportar agua cuando no es necesario o,

por el contrario, no hacerlo en momentos en los que el cultivo sí lo necesita. Esta falta

de adaptación al estado real del entorno puede traducirse en un consumo innecesario

de agua, un peor aprovechamiento de los recursos y una menor capacidad de respuesta

ante cambios de temperatura, humedad o exposición solar.

1

CAPÍTULO 1. INTRODUCCION´ | 2

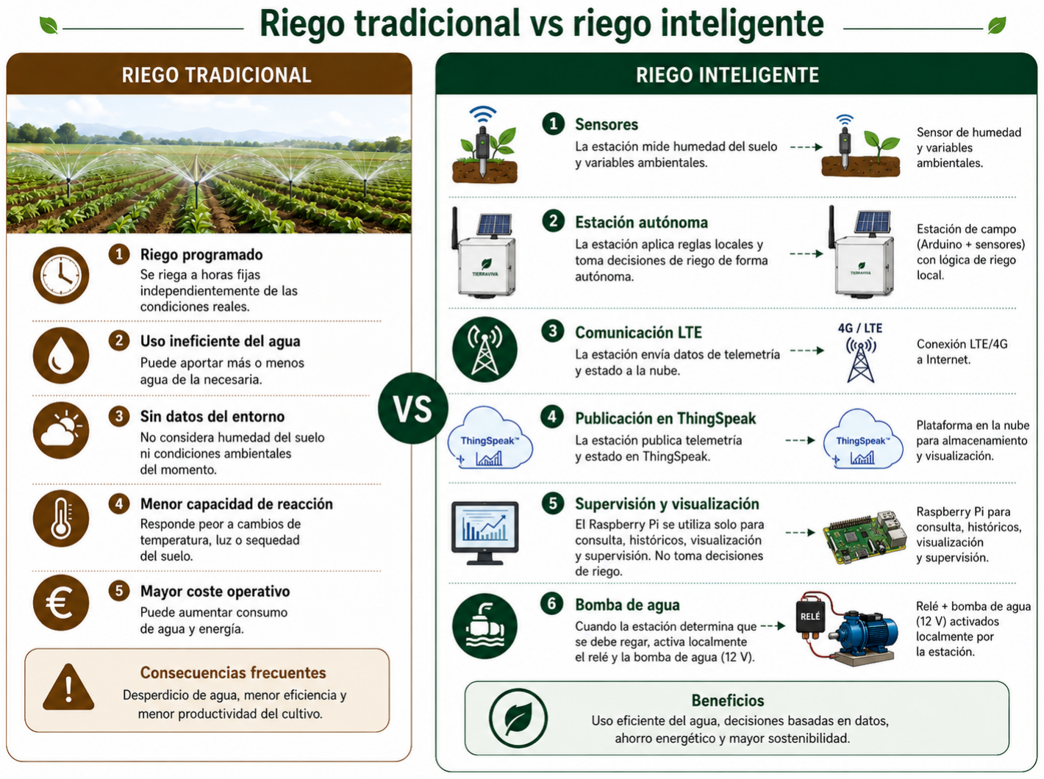
[picture p34: figure]

Figura 1.1: Evolución conceptual desde un riego basado en rutinas fijas hacia un riego apoyado en medidas reales del entorno. Elaboración propia.

Para dar solución a estas limitaciones, la digitalización del entorno agrícola

proporciona las herramientas necesarias para desarrollar sistemas informados y

adaptativos. Mediante el despliegue de redes de sensores y equipos de comunicación,

es posible adquirir datos en tiempo real y observar el estado del entorno de forma

continua. Este planteamiento se relaciona directamente con la agricultura de precisión,

cuyo objetivo no es únicamente automatizar tareas, sino utilizar información del propio

entorno para mejorar la eficiencia, reducir desperdicios y facilitar la gestión de los

recursos.

En este tipo de sistemas, la monitorización ambiental desempeña un papel

fundamental. Medir variables como la humedad del suelo, la temperatura, la humedad

relativa, la presión atmosférica o la luminosidad permite disponer de una visión más

completa del estado de una zona de cultivo, y no todas estas variables tienen el mismo

peso en la decisión de riego. Por ejemplo, la humedad del suelo puede indicar de forma

CAPÍTULO 1. INTRODUCCION´ | 3

directa la necesidad de aportar agua, mientras que la temperatura o la luz ambiental

ayudan a interpretar las condiciones en las que se está produciendo la evaporación o el

déficit de agua.

La automatización del riego aparece, por tanto, como una evolución natural de

la monitorización. Un sistema que únicamente muestra datos puede ser útil para el

agricultor, pero sigue dependiendo de una intervención manual para actuar. En cambio,

un sistema capaz de medir, analizar y accionar un elemento de riego permite cerrar el

ciclo completo: observar el entorno, interpretar su estado y ejecutar una acción cuando

se cumplen determinadas condiciones. Esta capacidad resulta especialmente interesante

en zonas donde la supervisión constante no siempre es posible o donde se quiere reducir

la dependencia de decisiones manuales repetitivas.

Además, en muchos escenarios agrícolas o rurales existen limitaciones de

infraestructura que condicionan el diseño de cualquier solución tecnológica. No siempre

se dispone de conexión WiFi estable, alimentación eléctrica cercana o cobertura de red

garantizada. Por ello, un sistema de riego inteligente no debe plantearse únicamente

desde el punto de vista del software o de la sensorización, sino como una integración

completa de hardware, comunicaciones, energía, almacenamiento de datos y actuación

física sobre el riego. La dificultad real no está solo en medir una variable, sino en

conseguir que todos estos elementos funcionen de forma coordinada y fiable.

Dentro de este contexto surge TierraViva, un proyecto orientado al diseño de

un prototipo IoT para monitorización y control de riego. El objetivo principal no

es construir un producto agrícola industrial cerrado, sino desarrollar una solución

funcional que permita comprobar cómo diferentes tecnologías pueden integrarse para

resolver un problema real. El proyecto parte de una idea sencilla, medir el estado

del entorno y actuar sobre el riego cuando sea necesario, pero implica varias capas

técnicas: adquisición de datos mediante sensores, comunicación remota, publicación de

telemetría, almacenamiento, visualización, lógica local de decisión en las estaciones y

actuación física sobre el sistema de riego.

Por tanto, este trabajo se sitúa en la intersección de varias disciplinas: agricultura

de precisión, Internet de las Cosas, comunicaciones y sistemas embebidos. Esta

combinación permite abordar un problema práctico desde una perspectiva propia de la

ingeniería: analizar necesidades, estudiar alternativas, justificar decisiones, implementar

un prototipo y validar su funcionamiento mediante pruebas. La finalidad última es

demostrar que una arquitectura bien diseñada puede ayudar a mejorar la gestión

del riego, aportando información objetiva y capacidad de actuación automática o

supervisada.

CAPÍTULO 1. INTRODUCCION´ | 4

## 1.2. Motivación del proyecto

La motivación de este proyecto surge de la dificultad de gestionar correctamente el

riego en pequeños cultivos o huertos que no pueden supervisarse de forma continua.

En estos escenarios, especialmente en épocas de más calor, pueden aparecer problemas

tanto por falta de agua como por exceso de riego. Aunque pueda parecer una situación

sencilla, refleja una necesidad habitual: cuidar correctamente un terreno cuando no se

está físicamente allí de forma continua.

Detrás de esa necesidad existe un problema técnico real. No se trata solo de regar

más o menos, sino de saber cuándo hace falta regar, en qué condiciones se encuentra

el terreno y si sería posible actuar sin depender siempre de una revisión manual. Por

tanto, el interés del proyecto no está únicamente en automatizar una tarea, sino en

diseñar un sistema capaz de observar el entorno, interpretar su estado y actuar de

forma controlada.

La idea inicial puede entenderse como una solución de aviso remoto, pero al

analizar el caso con más detalle aparecen cuestiones que hacen el problema más

interesante: la cobertura en entornos rurales, la alimentación del sistema, la necesidad

de funcionamiento desatendido, la fiabilidad de las comunicaciones y la posibilidad de

controlar físicamente el riego.

La evolución natural de esta idea conduce hacia un sistema más completo de

monitorización y control. El proyecto no consiste únicamente en conectar sensores, sino

en diseñar una arquitectura capaz de integrar distintas áreas de la ingeniería de forma

coherente. Esta integración es una de las partes más relevantes del trabajo, porque

permite transformar una necesidad cotidiana en un problema técnico con suficiente

profundidad para un Trabajo Fin de Grado.

Otro aspecto importante en la motivación es que TierraViva permite aplicar

conocimientos que normalmente se estudian por separado. En el proyecto intervienen

electrónica, programación embebida, comunicaciones, bases de datos, desarrollo web,

visualización de información y control de actuadores. Esta combinación hace que el

trabajo sea más exigente, pero también más representativo de un sistema real, donde

el valor no está solo en que cada parte funcione de manera aislada, sino en conseguir

que todas trabajen coordinadamente.

Además, el proyecto tiene una componente práctica y sostenible que lo hace

especialmente atractivo. El objetivo no es desarrollar tecnología por sí misma, sino

utilizarla para responder a una necesidad concreta: gestionar mejor el riego y reducir

decisiones basadas únicamente en intuición, costumbre u horarios fijos. En este sentido,

CAPÍTULO 1. INTRODUCCION´ | 5

TierraViva conecta la ingeniería con una aplicación tangible, cercana y fácil de entender,

pero con suficiente profundidad técnica como para justificar un desarrollo completo.

Por todo ello, este TFG no se plantea simplemente como un ejercicio académico

más, sino como una oportunidad para construir una solución con valor real. La idea

nace de una necesidad cercana, pero se plantea con una visión modular y escalable, de

forma que pueda servir como base para futuras ampliaciones, como nuevas estaciones de

campo, autonomía energética mediante panel solar o mecanismos predictivos basados

en datos históricos.

## 1.3. Planteamiento del problema

El reto principal de este TFG es transformar una situación tradicionalmente manual

en un sistema monitorizado, trazable y parcialmente automatizado.

El primer aspecto del problema es la adquisición de datos. Para que el sistema

pueda tomar decisiones con cierto criterio, necesita disponer de medidas representativas

del entorno. La humedad del suelo es la variable más directamente relacionada con la

necesidad de riego, pero no es la única información útil, ya que otras variables como

la temperatura, la humedad relativa o la luminosidad permiten contextualizar mejor

el estado de la zona monitorizada. El sistema debe ser capaz de leer estas magnitudes

de forma periódica y convertirlas en datos utilizables, evitando que las lecturas queden

como valores aislados sin relación con el funcionamiento global del sistema.

El segundo aspecto es la transmisión de la información. En un sistema de riego

desatendido, las estaciones de campo no pueden depender de una supervisión constante

ni de una conexión física permanente a un ordenador. Los datos deben poder enviarse

desde la zona donde se encuentran los sensores hasta un punto donde puedan ser

procesados, almacenados y visualizados. Esta comunicación debe ser suficientemente

fiable para que el agricultor o el usuario pueda conocer el estado del sistema, pero

también debe tener en cuenta las limitaciones propias de un entorno rural, donde no

siempre existe una infraestructura de red estable.

Una vez recibidos los datos, el siguiente problema es su almacenamiento y

tratamiento. Mostrar una lectura puntual puede servir para una comprobación rápida,

pero no permite analizar la evolución del sistema. Para que el prototipo tenga utilidad

real, es necesario registrar las medidas recibidas, asociarlas a una estación concreta y

conservar un histórico. De esta forma, se puede comprobar cómo varían las condiciones

del entorno a lo largo del tiempo, detectar comportamientos anómalos y justificar las

decisiones de riego tomadas por el sistema.

CAPÍTULO 1. INTRODUCCION´ | 6

La visualización también forma parte del problema. Un sistema técnico puede

estar funcionando correctamente de manera interna, pero si el agricultor o el usuario

no puede interpretar su estado de forma clara, su utilidad queda limitada. Por ello, es

necesario disponer de una interfaz que permita consultar las últimas lecturas, observar

la evolución de las variables principales y conocer el estado del riego. Esta interfaz

debe presentar la información de forma comprensible, sin exigir que el usuario tenga

que interpretar directamente datos brutos, mensajes de consola o registros internos

difíciles de entender para alguien no experto.

Otro punto fundamental es la toma de decisiones. El sistema debe ser capaz de

determinar cuándo conviene actuar sobre el riego a partir de las medidas disponibles.

En el alcance de este TFG, esta decisión se plantea mediante reglas verificables, como

umbrales, condiciones de seguridad y tiempos máximos de actuación. Este enfoque

resulta adecuado para un prototipo, ya que permite justificar de forma clara por

qué se activa o se detiene el riego, sin depender de modelos predictivos complejos

que requerirían una cantidad elevada de datos históricos para entrenarse y validarse

correctamente.

El último elemento del problema es la actuación física. Un sistema que solo mide

y muestra información se queda en una solución de monitorización. Para avanzar hacia

un sistema de riego inteligente, es necesario cerrar el ciclo mediante el control de

un actuador. Esto introduce requisitos adicionales de seguridad, ya que una lectura

incorrecta, una regla mal configurada, una pérdida de comunicación o un fallo eléctrico

no deben provocar que la bomba permanezca activa indefinidamente. Por tanto, el

diseño debe contemplar un comportamiento seguro por defecto dentro de la propia

estación de campo, priorizando la desactivación de la bomba ante situaciones de error.

En conjunto, el problema planteado puede entenderse como un problema de

integración de subsistemas. TierraViva debe coordinar sensores, estación de campo,

comunicación remota, plataforma de publicación de datos, sistema de supervisión,

interfaz de usuario y actuador. Cada una de estas partes tiene una función concreta,

pero el valor del proyecto aparece cuando todas trabajan de forma conjunta. Por esta

razón, el desarrollo no se limita a seleccionar componentes, sino que exige definir una

arquitectura modular, validar cada bloque por separado y comprobar posteriormente

el funcionamiento del sistema completo.

Además, el sistema se diseña pensando en su posible ampliación. Aunque el

prototipo pueda validarse inicialmente con una estación, la arquitectura permite

incorporar nuevas estaciones de campo, nuevas variables medidas o nuevos mecanismos

de decisión. Esta modularidad es importante para que el trabajo no quede como una

CAPÍTULO 1. INTRODUCCION´ | 7

solución cerrada y difícil de extender, sino como una base sobre la que puedan plantearse

mejoras futuras, como autonomía energética, despliegue multizona o mecanismos

predictivos basados en datos históricos.

## 1.4. Alcance y limitaciones

El objetivo no es desarrollar un producto comercial cerrado ni una solución

industrial certificada, sino construir una arquitectura completa que permita comprobar,

de forma experimental, cómo diferentes tecnologías pueden integrarse para resolver un

problema real. Por tanto, el trabajo se evalúa principalmente desde el punto de vista

de la integración tecnológica, el funcionamiento del sistema y la validación mediante

pruebas.

El prototipo debe ser capaz de medir variables relevantes del entorno, transmitir la

información obtenida, registrar o consultar los datos recibidos, permitir su visualización

y actuar sobre el riego bajo determinadas condiciones evaluadas localmente en cada

estación. De esta forma, el proyecto no se limita a una prueba aislada de sensores

ni a una aplicación de visualización, sino que busca cerrar el ciclo completo de

monitorización, decisión y actuación. Esta integración constituye el núcleo del trabajo

y permite valorar el sistema como una solución IoT aplicada a un caso práctico.


Figura 1.2: Delimitación del alcance del prototipo TierraViva y de los aspectos que quedan fuera de esta fase del trabajo. Elaboración propia.

No obstante, es importante delimitar claramente el alcance para evitar interpretar

el proyecto como un sistema agrícola final preparado para su instalación directa en

cualquier explotación. El prototipo desarrollado no pretende sustituir a soluciones

profesionales de riego industrial, ni contempla certificaciones eléctricas, hidráulicas o de

CAPÍTULO 1. INTRODUCCION´ | 8

comunicaciones. Tampoco se aborda el diseño mecánico definitivo de una caja estanca,

la fabricación de una placa electrónica propia ni la optimización completa del consumo

energético para funcionamiento durante largos periodos sin mantenimiento.

Otra limitación relevante es la validación agronómica. Aunque el sistema está

orientado al riego y se basa en variables relacionadas con el estado del entorno, no

se realizará un ensayo prolongado durante varios meses sobre un cultivo real. Una

validación de ese tipo requeriría controlar factores externos como el tipo de suelo, la

especie cultivada, la climatología, la frecuencia de riego, la evolución del crecimiento

de las plantas y la comparación con métodos tradicionales. En este TFG, la validación

se centrará en comprobar que el prototipo mide, comunica, registra, visualiza y actúa

correctamente, dejando los ensayos agronómicos de larga duración como una posible

línea futura.

También se establece como limitación el uso de inteligencia artificial. Aunque

el proyecto se plantea dentro de un contexto en el que la analítica de datos y

los mecanismos predictivos pueden aportar mucho valor, no tendría rigor presentar

como inteligencia artificial una lógica basada únicamente en reglas o umbrales. Para

implementar modelos predictivos fiables sería necesario disponer de un histórico amplio

de datos, recogido durante suficiente tiempo y bajo condiciones representativas. Por

ello, en este trabajo la toma de decisiones se planteará de forma verificable mediante

reglas, dejando la inteligencia artificial como una ampliación futura si se dispone de

datos suficientes para entrenar, validar y justificar un modelo.

El sistema se diseñará con una visión modular, de modo que pueda ampliarse

posteriormente con nuevas estaciones, nuevas variables medidas, mejoras en la

autonomía energética o mecanismos más avanzados de análisis. Sin embargo, dentro

del alcance de esta memoria, la prioridad será demostrar que la arquitectura propuesta

funciona de extremo a extremo: desde la adquisición de datos en campo hasta la

visualización y actuación sobre el riego. Esta delimitación permite mantener un

equilibrio entre ambición y viabilidad, evitando prometer funcionalidades que no

puedan ser implementadas y validadas con suficiente solidez durante el desarrollo del

TFG.

En resumen, el alcance del proyecto es el de un prototipo funcional, documentado

y validado, orientado a demostrar la viabilidad técnica de un sistema IoT para riego

inteligente. Sus limitaciones no se consideran una debilidad del trabajo, sino una forma

de definir con precisión qué se ha implementado, qué se ha probado y qué queda abierto

para futuras fases de desarrollo.

CAPÍTULO 1. INTRODUCCION´ | 9

## 1.5. Organización de la memoria

La memoria se organiza de forma progresiva, comenzando por la introducción del

problema y avanzando después hacia los fundamentos técnicos, las decisiones de diseño,

la implementación y la validación del sistema.

En el Capítulo 1 se presenta el contexto del proyecto, la motivación, el planteamiento

del problema y el alcance del trabajo. El Capítulo 2 recoge el estado del arte

y los fundamentos tecnológicos necesarios para comprender la solución propuesta,

incluyendo arquitecturas IoT, agricultura de precisión, comunicaciones, plataformas

cloud y automatización del riego.

El Capítulo 3 describe los métodos, materiales y decisiones de diseño, definiendo

los requisitos del sistema, la metodología seguida, la arquitectura general planteada y

la justificación de las principales elecciones tecnológicas. A continuación, el Capítulo 4

presenta la arquitectura final de TierraViva y explica cómo se integran las estaciones

de campo, la plataforma cloud, la Raspberry Pi como sistema de supervisión y los

mecanismos de control.

Los Capítulos 5 y 6 se centran en la implementación del prototipo. El primero

aborda la parte hardware y firmware de las estaciones, incluyendo la lectura de sensores,

la publicación de telemetría y la decisión local de riego, mientras que el segundo describe

la implementación software de supervisión en Raspberry Pi y nube. Posteriormente,

el Capítulo 7 recoge la validación y las pruebas realizadas, y el Capítulo 8 analiza los

resultados obtenidos y las limitaciones detectadas.

Finalmente, el Capítulo 9 presenta las conclusiones del trabajo, el grado de

cumplimiento del alcance planteado, las competencias aplicadas y adquiridas, y las

posibles líneas de trabajo futuro.

## Capítulo 2

# Estado del arte y fundamentos tecnológicos

Este capítulo recoge los fundamentos tecnológicos que sirven de base para el diseño

de TierraViva. La revisión se centra en las áreas que han condicionado decisiones reales

del proyecto: arquitecturas IoT, agricultura de precisión, redes de sensores, plataformas

embebidas, conectividad en campo, plataformas cloud y automatización aplicada al

riego.

El capítulo no busca valorar cada tecnología de forma aislada, sino explicar qué

aporta cada una dentro de una arquitectura de riego inteligente. Por eso se presta

atención tanto a sus ventajas como a sus restricciones prácticas: consumo, cobertura,

facilidad de integración, dependencia de infraestructura y capacidad de validación

dentro del alcance del TFG.

La revisión se orienta, por tanto, a justificar una arquitectura distribuida.

TierraViva no se plantea como un sistema en el que un equipo central decide cada

actuación, sino como un conjunto de estaciones de campo autónomas que miden, aplican

reglas locales y publican su estado. El equipo de supervisión queda reservado para tareas

de consulta, histórico y visualización.

## 2.1. Arquitecturas IoT

El concepto de Internet de las Cosas, o Internet of Things (IoT), hace referencia a

la interconexión de objetos físicos o virtuales capaces de identificarse, comunicarse

y participar en servicios digitales. La recomendación ITU-T Y.2060 define IoT

como una infraestructura global para la sociedad de la información que permite

ofrecer servicios avanzados mediante la interconexión de cosas, tanto físicas como

virtuales, a través de tecnologías de información y comunicación interoperables

[International Telecommunication Union, 2012]. Esta definición es amplia, pero resulta

adecuada para este trabajo porque sitúa IoT como una arquitectura completa:

adquisición de datos, comunicación, procesamiento, almacenamiento y actuación.

10

CAPÍTULO 2. ESTADO DEL ARTE Y FUNDAMENTOS TECNOLOGICOS ´ | 11

Desde un punto de vista práctico, un sistema IoT conecta el mundo físico con

el mundo digital. En el extremo de campo se encuentran dispositivos capaces de

medir variables, detectar eventos o modificar el estado de un sistema. Esa información

se transmite después hacia otros elementos, donde puede almacenarse, procesarse,

visualizarse o utilizarse para apoyar decisiones. Cuando el sistema incorpora control, la

actuación física puede resolverse de distintas formas: mediante decisiones centralizadas,

mediante control remoto o mediante lógica local en el propio nodo de campo.

Esta última alternativa resulta especialmente relevante cuando se busca que el

sistema mantenga un comportamiento seguro aunque la conectividad externa no esté

disponible.

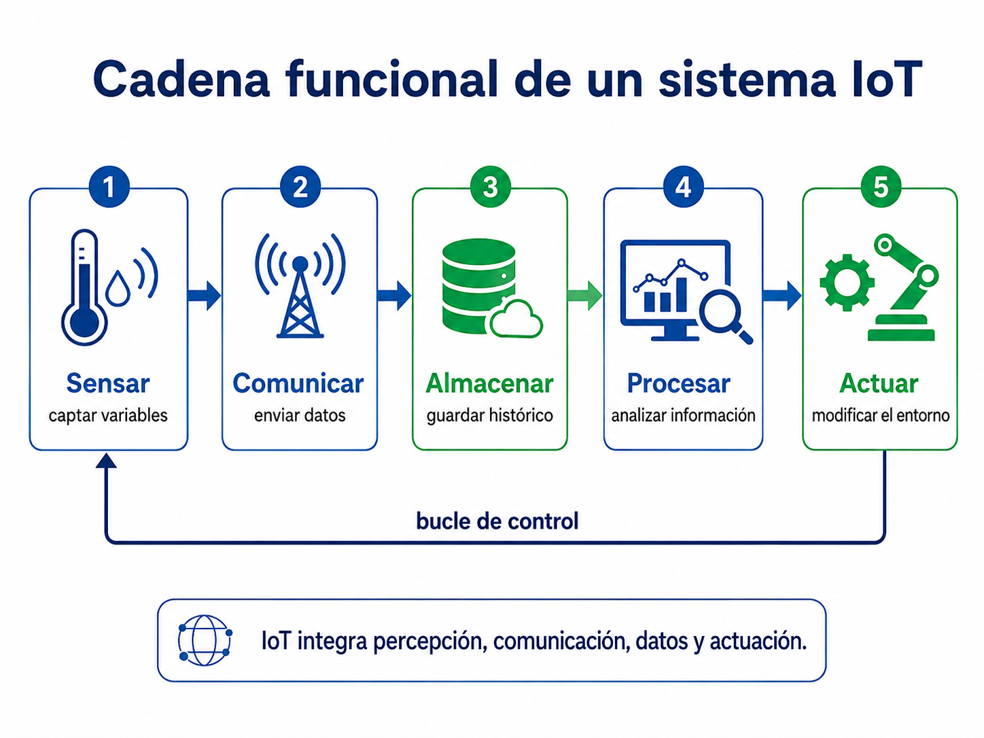
[picture p35: figure]

Figura 2.1: Cadena funcional básica de un sistema IoT. El sistema capta información del entorno mediante sensorización, la transmite a través de una red, la almacena, la procesa y, cuando procede, actúa sobre el mundo físico cerrando el bucle de control.

En la práctica, IoT debe entenderse como una integración de componentes,

no como una tecnología aislada. Sensores, actuadores, microcontroladores, redes de

comunicación, plataformas cloud, bases de datos, servicios backend, APIs y dashboards

deben encajar entre sí. En un proyecto de ingeniería, el funcionamiento individual

de cada bloque no garantiza el funcionamiento del sistema completo. Un diseño

puede tener sensores correctos o una interfaz clara, pero fallar si la comunicación,

CAPÍTULO 2. ESTADO DEL ARTE Y FUNDAMENTOS TECNOLOGICOS ´ | 12

el almacenamiento o la lógica de actuación no se han planteado de forma coherente.

Uno de los elementos básicos de una arquitectura IoT es el nodo o end-device. Este

nodo se sitúa cerca del fenómeno que se quiere observar o controlar y normalmente

integra sensores, una unidad de procesamiento, un sistema de comunicación y una

fuente de alimentación. En algunos casos solo mide y envía información; en otros

también ejecuta decisiones sencillas o controla actuadores. Estos dispositivos suelen

estar limitados en memoria, capacidad de cálculo, consumo energético o ancho de

banda disponible, por lo que sus restricciones deben considerarse desde el diseño inicial

[Al-Fuqaha et al., 2015].

Los sensores convierten una magnitud física en una señal eléctrica o digital

interpretable por el sistema. Los actuadores realizan la operación inversa: reciben

una señal de control y modifican el estado del mundo físico. Esta relación permite

diferenciar entre monitorización y control. La monitorización observa el entorno y

presenta información; el control utiliza esa información para ejecutar acciones. La

segunda opción introduce más responsabilidad técnica, ya que una señal de control

incorrecta, un dato erróneo o una pérdida de comunicación pueden tener consecuencias

físicas.

En muchas arquitecturas IoT aparece también una pasarela o gateway. Su función

es actuar como intermediario entre los dispositivos de campo y el resto del sistema.

Puede traducir protocolos, agregar datos, filtrar información, ejecutar procesamiento

local o proporcionar salida hacia una red de mayor alcance. En arquitecturas más

completas, esta pasarela puede realizar funciones de edge computing, reduciendo

latencia y manteniendo ciertas funciones aunque la conexión externa no esté disponible

[IEEE, 2020].

Relacionado con este planteamiento aparece el concepto de control local o

computación en el borde. En lugar de desplazar todas las decisiones hacia un servidor,

una nube o un equipo supervisor, parte de la lógica puede ejecutarse cerca del fenómeno

físico que se quiere controlar. En sistemas con actuadores, esta decisión tiene una

implicación importante: el nodo de campo puede aplicar reglas de seguridad, limitar

tiempos de activación y reaccionar ante fallos sin depender de una comunicación

continua con el exterior.

En aplicaciones de riego, esta aproximación resulta especialmente adecuada. La

humedad del suelo no varía a escala de milisegundos y las reglas iniciales de actuación

pueden implementarse de forma verificable en el microcontrolador de la estación. De

este modo, la plataforma remota y el sistema de supervisión pueden centrarse en

registrar, visualizar y analizar el comportamiento del sistema, mientras que la estación

CAPÍTULO 2. ESTADO DEL ARTE Y FUNDAMENTOS TECNOLOGICOS ´ | 13

conserva la responsabilidad inmediata sobre la bomba o el actuador de riego.

La nube o plataforma cloud constituye otra capa habitual. Su función es

proporcionar almacenamiento, disponibilidad remota, APIs de acceso y, en muchos

casos, herramientas de visualización o análisis. Esta capa facilita consultar los datos

desde distintos lugares, pero introduce dependencias que deben valorarse: conectividad,

latencia, límites de uso, disponibilidad del servicio y seguridad de la información.

El backend es la parte software encargada de recibir, transformar, validar y servir

los datos. Puede ejecutarse en una plataforma cloud, en un servidor o en un equipo

local con capacidad suficiente. Normalmente se comunica con una base de datos, donde

se guardan medidas y eventos. Este almacenamiento permite analizar la evolución

temporal del sistema, generar históricos y revisar decisiones tomadas a partir de datos

previos.

La visualización suele realizarse mediante dashboards, aplicaciones web o

aplicaciones móviles. Su objetivo es convertir datos técnicos en información

comprensible. En un sistema de monitorización y control, la interfaz debe permitir

consultar el estado actual, identificar fallos, observar tendencias y detectar situaciones

que requieren atención, sin obligar al usuario a interpretar registros internos o tramas

de comunicación.

Las arquitecturas IoT suelen representarse por capas. Una división sencilla distingue

entre capa física, formada por sensores y actuadores; capa de conectividad; capa de

procesamiento y almacenamiento; y capa de aplicación. Modelos más completos, como

el propuesto por el IoT World Forum, añaden niveles como computación en el borde,

acumulación de datos, abstracción y procesos de negocio [Hanes et al., 2017].

CAPÍTULO 2. ESTADO DEL ARTE Y FUNDAMENTOS TECNOLOGICOS ´ | 14

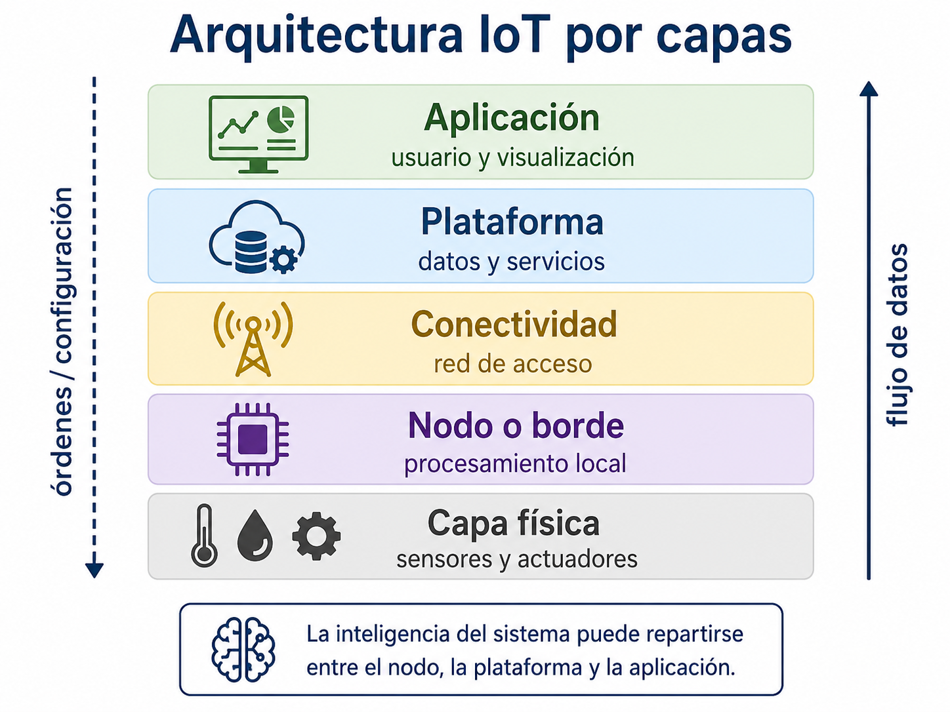
[picture p36: figure]

Figura 2.2: Arquitectura IoT organizada por capas funcionales. La capa física agrupa sensores y actuadores; el nodo o borde proporciona procesamiento local; la conectividad permite el intercambio de información; la plataforma gestiona datos y servicios; y la aplicación facilita la visualización e interacción con el usuario.

La Figura 2.2 resume esta estructura. En el caso de un sistema de riego, la

arquitectura debe cubrir el ciclo completo: medir en campo, comunicar, almacenar,

visualizar y actuar de forma segura. No obstante, la actuación no tiene por qué depender

siempre de un control remoto; en diseños distribuidos puede ejecutarse localmente en la

estación, utilizando la comunicación externa para supervisión, histórico y diagnóstico.

## 2.2. Agricultura de precisión y riego inteligente

La agricultura de precisión es una estrategia de gestión agrícola que utiliza

datos para tomar decisiones más ajustadas a las condiciones reales de cada

explotación, parcela o zona de cultivo. Según la International Society of

Precision Agriculture, este enfoque se basa en recopilar, procesar y analizar datos

temporales, espaciales e individuales, combinándolos con otra información para apoyar

decisiones de manejo orientadas a mejorar la eficiencia en el uso de recursos, la

productividad, la calidad, la rentabilidad y la sostenibilidad de la producción agrícola

[International Society of Precision Agriculture, 2024].

El interés de este enfoque está en la variabilidad del entorno agrícola. Una misma

parcela puede presentar diferencias de humedad, exposición solar, tipo de suelo,

CAPÍTULO 2. ESTADO DEL ARTE Y FUNDAMENTOS TECNOLOGICOS ´ | 15

pendiente o desarrollo de las plantas. Si todas las zonas se tratan de la misma manera,

parte de esa variabilidad queda oculta. La agricultura de precisión intenta reducir esa

simplificación utilizando datos para adaptar mejor las decisiones.

El agua es una variable crítica dentro de este contexto. La agricultura representa

una parte muy relevante de las extracciones de agua dulce a escala global; AQUASTAT

indica que aproximadamente el 69 % de las extracciones corresponden al uso agrícola

[Food and Agriculture Organization of the United Nations, 2021]. Una mejora en la

gestión del riego puede afectar tanto al rendimiento del cultivo como a la sostenibilidad

del recurso. Regar de forma inadecuada puede provocar déficit hídrico, exceso de agua,

pérdida de eficiencia y deterioro del cultivo.

El riego manual depende de la presencia y experiencia del usuario. Puede funcionar

en cultivos pequeños o con supervisión frecuente, pero presenta limitaciones cuando

el terreno no puede revisarse de forma continua. El riego temporizado reduce la

intervención manual programando horarios o duraciones concretas, aunque sigue siendo

rígido: puede mantener el mismo patrón aunque cambien la temperatura, la humedad,

la lluvia o la exposición solar.

El riego basado en datos introduce una lógica diferente. La decisión de regar se apoya

en medidas del entorno, como humedad del suelo, temperatura ambiente, humedad

relativa, radiación o luminosidad, previsión meteorológica, tipo de cultivo o histórico

de riego. No todas las variables tienen el mismo peso, pero su combinación permite

interpretar mejor el estado del sistema agrícola.

La monitorización ambiental permite pasar de una decisión basada en intuición a

una decisión basada en información observable. Además, el registro de datos a lo largo

del tiempo permite estudiar tendencias, detectar cambios bruscos y comprobar si una

acción de riego ha tenido el efecto esperado.

Cuando la monitorización se conecta con un mecanismo de actuación, el sistema

pasa a formar parte del control del proceso. En ese punto aparecen requisitos

adicionales: reglas claras, límites de seguridad y comportamiento seguro ante fallo. En

riego, una actuación incorrecta puede traducirse en pérdida de agua, daño al cultivo

o funcionamiento indebido del actuador encargado de impulsar o permitir el paso del

agua.

Los sistemas de riego inteligente basados en IoT suelen combinar nodos de medida,

comunicaciones, almacenamiento de datos, procesamiento y actuación. Boursianis et

al. presentan en IEEE Sensors Journal una plataforma de riego inteligente para

agricultura de precisión basada en IoT, planteada como un sistema formado por varios

subsistemas coordinados [Boursianis et al., 2021]. Esta línea de trabajo es relevante

CAPÍTULO 2. ESTADO DEL ARTE Y FUNDAMENTOS TECNOLOGICOS ´ | 16

porque desplaza el foco desde el sensor aislado hacia la arquitectura completa.

En TierraViva este enfoque se concreta en una decisión sencilla pero importante: no

basta con medir humedad o temperatura, la estación debe poder convertir esas lecturas

en una actuación local limitada y segura. Por eso la eficiencia del sistema no depende

solo de la calidad de las medidas, sino también de cómo se transforma una lectura en

una acción de riego.

## 2.3. IoT aplicado a la agricultura

La aplicación de IoT en agricultura responde a la necesidad de observar el entorno

agrícola de forma continua, distribuida y objetiva. La agricultura de precisión define

el enfoque de gestión basado en datos; IoT aporta la infraestructura que permite

capturarlos, transmitirlos, almacenarlos y utilizarlos.

En estos sistemas, las estaciones de monitorización se sitúan en campo y recogen

información del entorno mediante sensores. Su función no es obtener una medida

aislada, sino generar observaciones periódicas de una zona de cultivo. Según la

arquitectura, una estación puede limitarse a monitorizar o incorporar también

capacidad de actuación.

Las variables medidas dependen del objetivo agrícola. En riego suelen combinarse

variables del suelo y variables ambientales. Los sensores de suelo aportan información

más directa sobre la disponibilidad de agua en la zona de raíces; los sensores ambientales

ayudan a contextualizar esa lectura mediante temperatura, humedad relativa, presión,

radiación solar o luminosidad [García et al., 2020].

El dato agrícola necesita contexto. Una lectura de humedad del suelo no se

interpreta igual según la hora del día, la temperatura, la exposición solar o el histórico

de riego anterior. Por este motivo, estos sistemas suelen organizar las medidas como

series temporales asociadas a una estación y a un instante concreto.

El despliegue en campo introduce restricciones que no aparecen con la misma

intensidad en un laboratorio. Las estaciones pueden estar expuestas a lluvia, polvo,

humedad, cambios de temperatura, radiación solar o manipulaciones accidentales.

También deben funcionar durante periodos prolongados sin intervención directa.

Protección física, mantenimiento, alimentación, conectividad y recuperación ante fallos

pasan a ser parte del problema técnico.

La alimentación condiciona el diseño desde el principio. Las estaciones agrícolas no

siempre tienen una toma eléctrica cercana, por lo que pueden requerir baterías, paneles

solares o modos de bajo consumo. Esta decisión afecta a la frecuencia de muestreo, al

CAPÍTULO 2. ESTADO DEL ARTE Y FUNDAMENTOS TECNOLOGICOS ´ | 17

tipo de comunicación, a la potencia de transmisión y a la disponibilidad de sensores o

actuadores.

La conectividad plantea una restricción similar. En muchos entornos rurales no se

puede asumir una red WiFi estable ni una cobertura móvil uniforme. Las estaciones

pueden estar separadas por decenas, cientos o miles de metros, dependiendo de la

parcela. Esto obliga a estudiar tecnologías adecuadas para dispositivos distribuidos,

bajo consumo y cobertura amplia [Soussi et al., 2024].

La robustez es un requisito técnico de primer nivel. Un sistema agrícola puede

tomar decisiones que afectan al consumo de agua o al estado de un cultivo. Debe

contemplar pérdidas de comunicación, lecturas erróneas, reinicios inesperados, fallos

de alimentación o indisponibilidad temporal de la plataforma de datos. Si incorpora

actuación, también debe definir estados seguros ante situaciones anómalas.

La literatura sobre agricultura inteligente coincide en que el valor de IoT está

en la integración entre medida, comunicación, procesamiento y toma de decisiones

[Shafi et al., 2019, Soussi et al., 2024]. En la misma línea, los trabajos sobre riego

inteligente resaltan que la eficiencia depende tanto de la calidad de las medidas

como de la estrategia de control y de la fiabilidad de la arquitectura completa

[Abioye et al., 2020].

Desde esta perspectiva, el reto no está simplemente en añadir sensores a un cultivo.

El reto está en construir una arquitectura capaz de identificar estaciones, registrar

históricos diferenciados, crecer de forma ordenada y mantener un comportamiento

seguro cuando alguna parte del sistema falle.

## 2.4. Redes de sensores y nodos de campo

Una red de sensores es un conjunto de dispositivos distribuidos que capturan

información del entorno y la transmiten hacia un sistema capaz de procesarla,

almacenarla o utilizarla para tomar decisiones. En IoT, estas redes permiten observar

fenómenos físicos de forma continua y en distintos puntos del espacio.

El elemento básico es el nodo de campo o end-node. Se sitúa cerca del entorno que

se quiere medir o controlar y normalmente incorpora una unidad de procesamiento,

uno o varios sensores, un sistema de comunicación y una fuente de alimentación

[Hanes et al., 2017]. En agricultura, estos nodos pueden instalarse en distintas zonas

de cultivo para recoger datos periódicos y enviarlos a un sistema de supervisión.

Dentro de una red conviene distinguir entre nodos sensores y nodos actuadores.

Un nodo actuador modifica físicamente el estado de un sistema, por ejemplo activando

CAPÍTULO 2. ESTADO DEL ARTE Y FUNDAMENTOS TECNOLOGICOS ´ | 18

una bomba, cerrando un circuito mediante un relé o accionando otro elemento físico

de riego. En muchos sistemas reales ambas funciones conviven en un mismo nodo.

Los sensores transforman una magnitud física en una señal interpretable por el

sistema. En agricultura son habituales variables como humedad del suelo, temperatura

ambiente, humedad relativa, luminosidad, presión atmosférica, radiación solar, caudal

o parámetros químicos del suelo. En riego, las variables relacionadas con el agua

disponible y las condiciones ambientales tienen prioridad [García et al., 2020].

Una diferencia importante es el tipo de salida del sensor. Los sensores analógicos

generan una señal continua, normalmente una tensión o corriente proporcional a

la magnitud medida, y requieren conversión analógico-digital. Los sensores digitales

entregan directamente la medida mediante un protocolo de comunicación. Los primeros

suelen ser sencillos y económicos, pero más sensibles al ruido y a la alimentación; los

segundos facilitan la lectura, aunque dependen de protocolos, direcciones y librerías

concretas.

Aspecto | Sensores analógicos | Sensores digitales
Salida | Señal continua proporcional a la magnitud medida. | Dato digital entregado por un bus o protocolo.
Lectura | Requieren conversión analógico-digital. | Se leen mediante comunicación digital.
Ventajas | Simples, económicos y fáciles de conectar. | Lectura más directa y mayor integración interna.
Limitaciones | Sensibles a ruido, alimentación y cableado. | Dependencia de protocolos, direcciones y librerías.
Uso habitual | Medidas sencillas con salida proporcional. | Sensores con varias magnitudes o calibración interna.

Tabla 2.1: Comparación general entre sensores analógicos y digitales

La Tabla 2.1 recoge esta comparación. En ambos casos, una lectura de sensor no

debe asumirse como una medida absoluta. Muchos sensores necesitan calibración para

que sus valores sean útiles en un contexto concreto. En agricultura esto es evidente en

variables como la humedad del suelo, cuya respuesta puede depender del sustrato, la

compactación, la salinidad, la temperatura o la forma de instalación.

También deben contemplarse errores de medida. Un sensor puede devolver

valores erróneos por ruido eléctrico, mala conexión, humedad, degradación, fallos de

alimentación o condiciones fuera de rango. Si esas medidas se utilizan para tomar

decisiones automáticas, el sistema debe diferenciar entre datos válidos, datos dudosos

y ausencia de datos. Esta distinción evita que una actuación dependa de una única

CAPÍTULO 2. ESTADO DEL ARTE Y FUNDAMENTOS TECNOLOGICOS ´ | 19

lectura incoherente.

Los nodos de campo suelen tener recursos limitados. Pueden funcionar con batería,

comunicarse mediante enlaces de bajo ancho de banda y operar en zonas de cobertura

irregular. El diseño debe decidir qué datos se envían, con qué frecuencia, a qué distancia

y cuántos nodos formarán parte de la red [Al-Fuqaha et al., 2015].

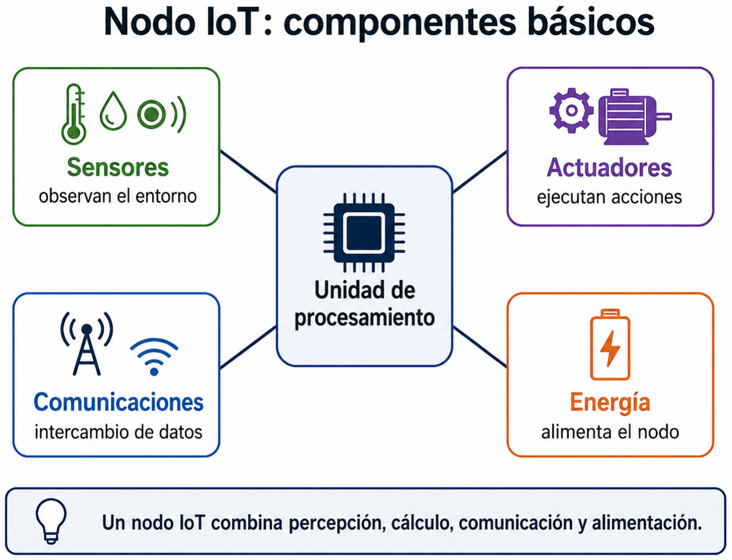
[picture p37: figure]

Figura 2.3: Componentes básicos de un nodo IoT. Un nodo integra sensores para observar el entorno, actuadores para ejecutar acciones, una unidad de procesamiento, un subsistema de comunicaciones y una fuente de energía que condiciona su autonomía.

La Figura 2.3 muestra los bloques habituales de un nodo de campo. En

una aplicación agrícola real, la fiabilidad depende del conjunto formado por

sensor, nodo, alimentación, comunicación, protección física y tratamiento de datos

[Soussi et al., 2024]. Cuando el nodo incorpora un actuador, también debe asumir

reglas mínimas de actuación segura, ya que es el elemento que se encuentra físicamente

conectado al sistema de riego.

## 2.5. Controladores y plataformas embebidas para IoT

En una arquitectura IoT, los sensores y actuadores necesitan una plataforma capaz

de leer señales, ejecutar lógica de control y comunicarse con el resto del sistema.

CAPÍTULO 2. ESTADO DEL ARTE Y FUNDAMENTOS TECNOLOGICOS ´ | 20

Esta función puede recaer en microcontroladores, computadores de placa reducida o

dispositivos embebidos específicos. La elección afecta al consumo energético, potencia

de cálculo, interfaces disponibles, coste, facilidad de programación y capacidad de

integración.

Los microcontroladores son una opción habitual para nodos de campo. Son

dispositivos de bajo coste y consumo reducido, pensados para ejecutar tareas concretas

de forma repetitiva: leer sensores, activar salidas digitales, comunicarse mediante buses

sencillos o enviar datos a través de un módulo externo. Plataformas como Arduino,

ESP32, STM32 u otras equivalentes son frecuentes en prototipos IoT porque permiten

trabajar directamente con entradas y salidas físicas, temporización, comunicaciones

serie y buses como I2C o SPI [Al-Fuqaha et al., 2015].

Arduino es una familia muy extendida en educación y prototipado. Su principal

ventaja es el entorno accesible, la abundante documentación y la compatibilidad con

muchos sensores y módulos. ESP32 incorpora WiFi y Bluetooth, además de mayor

potencia de cálculo. Las familias STM32 ofrecen más control técnico y una gama amplia

de prestaciones, aunque suelen exigir mayor conocimiento del entorno de desarrollo y

de la configuración de periféricos.

Los computadores de placa reducida, como Raspberry Pi u otras plataformas

similares, cubren otro tipo de necesidades. Permiten ejecutar un sistema operativo

completo, levantar servicios, gestionar bases de datos, servir aplicaciones web o

coordinar varios procesos software. Su mayor potencia y flexibilidad los hace adecuados

para almacenamiento, visualización, supervisión, análisis histórico o funciones de

gateway. A cambio, consumen más, arrancan más lentamente y no son la opción natural

para depender de ellos como único punto de decisión en una actuación física crítica.

Esta separación ayuda a distinguir dos roles dentro de una arquitectura IoT. Un

nodo de campo suele priorizar bajo consumo, robustez, lectura directa de sensores,

control de salidas y funcionamiento desatendido. Un sistema de supervisión puede

necesitar procesamiento, almacenamiento local, conectividad con servicios externos,

backend e interfaz de usuario.

CAPÍTULO 2. ESTADO DEL ARTE Y FUNDAMENTOS TECNOLOGICOS ´ | 21
Aspecto | Microcontroladores | Computadores de placa reducida
Función | Sensado, decisión local sencilla, control de salidas y tareas embebidas. | Supervisión, almacenamiento, servicios y visualización.
Consumo | Bajo o moderado, según diseño. | Superior, por sistema operativo y servicios.
Cálculo | Suficiente para adquisición y lógica sencilla. | Adecuado para procesos software más complejos.
Interfaces | GPIO, ADC, PWM, UART, I2C o SPI. | GPIO, USB, red, almacenamiento y sistema operativo.
Uso típico | Nodo de campo autónomo o dispositivo final. | Gateway, servidor local o sistema de supervisión.

Tabla 2.2: Comparación general entre microcontroladores y computadores de placa reducida

La Tabla 2.2 resume esta diferencia. En un sistema IoT agrícola, una arquitectura

híbrida puede aprovechar la eficiencia del microcontrolador en campo para la

medida y actuación local, y la capacidad de procesamiento de un computador de

placa reducida para supervisión, almacenamiento y visualización [Hanes et al., 2017,

Soussi et al., 2024].

## 2.6. Comunicaciones LPWAN y conectividad en entornos rurales

La conectividad condiciona la viabilidad de cualquier sistema IoT desplegado en

campo. En aplicaciones agrícolas, los nodos pueden estar separados de la vivienda, del

laboratorio o del sistema de supervisión, y no siempre existe una infraestructura de red

disponible. No se puede asumir WiFi estable, alimentación cercana ni cobertura móvil

suficiente en todos los puntos.

El tráfico típico de estos sistemas suele ser reducido. Normalmente se envían

medidas pequeñas cada cierto intervalo: humedad, temperatura, estado de un actuador,

tensión de batería o avisos de error. La prioridad no es el caudal, sino la cobertura, el

consumo, la disponibilidad y la fiabilidad del enlace.

CAPÍTULO 2. ESTADO DEL ARTE Y FUNDAMENTOS TECNOLOGICOS ´ | 22

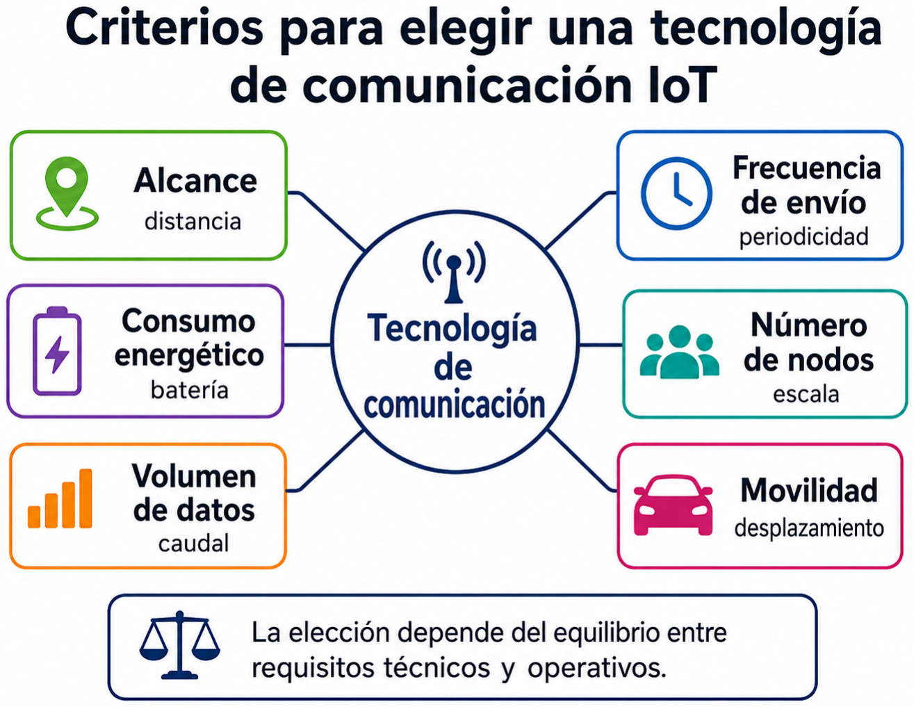
[picture p38: figure]

Figura 2.4: Criterios principales para seleccionar una tecnología de comunicación en un sistema IoT. La elección depende del equilibrio entre alcance, consumo energético, volumen de datos, frecuencia de envío, número de nodos y movilidad del escenario de aplicación.

Las redes LPWAN, del inglés Low Power Wide Area Networks, se diseñan para

ese tipo de escenario. Proporcionan comunicaciones de largo alcance y bajo consumo

para dispositivos distribuidos que envían pequeñas cantidades de datos. A cambio,

aceptan bajo caudal, mayor latencia o mensajes poco frecuentes [Raza et al., 2017].

Este compromiso encaja con muchas aplicaciones agrícolas, donde las variables del

entorno no requieren actualización continua a escala de milisegundos.

WiFi y Bluetooth son tecnologías conocidas, pero su utilidad en campo abierto es

limitada. WiFi ofrece alta capacidad, aunque depende de una red local y su alcance es

reducido. Bluetooth y BLE tienen bajo consumo y pueden ser útiles para configuración

cercana, pero no conectan por sí solos estaciones separadas por cientos de metros o

varios kilómetros.

Entre las tecnologías de largo alcance destaca LoRa, una modulación de capa física

desarrollada por Semtech y basada en espectro ensanchado mediante chirps. Permite

alcanzar largas distancias con potencias reducidas, a costa de tasas de transmisión

bajas. Al aumentar el factor de ensanchamiento mejora la sensibilidad, pero crece el

CAPÍTULO 2. ESTADO DEL ARTE Y FUNDAMENTOS TECNOLOGICOS ´ | 23

tiempo de transmisión y disminuye el caudal disponible [Semtech Corporation, 2015,

Augustin et al., 2016].

LoRa y LoRaWAN no son equivalentes. LoRa hace referencia a la modulación

radio. LoRaWAN define una arquitectura de red sobre LoRa, con dispositivos

finales, pasarelas, servidor de red y servidor de aplicación [LoRa Alliance, 2020]. Usar

LoRaWAN implica trabajar con una infraestructura completa, no solo con módulos de

radio.

LoRaWAN resulta atractivo en entornos rurales por su alcance, bajo consumo y

uso de bandas no licenciadas. Sus restricciones también son claras: bajo caudal, límites

regulatorios de uso del canal, dependencia de gateways, configuración más compleja

y limitaciones en tráfico descendente. Adelantado et al. analizan precisamente estos

límites de capacidad, latencia y escalabilidad [Adelantado et al., 2017].

Las redes móviles LTE/4G ofrecen otro enfoque. Frente a LoRaWAN, LTE utiliza

infraestructura ya desplegada por operadores, proporciona mayor caudal y permite una

integración directa con servicios de Internet. Si hay cobertura, evita instalar un gateway

propio. Como contrapartida, exige tarjeta SIM, depende del operador, consume más

energía y puede implicar coste asociado al plan de datos.

Desde un punto de vista práctico, la conectividad celular en sistemas embebidos

suele apoyarse en módulos de comunicación externos controlados mediante comandos

AT. Estos módulos permiten al microcontrolador gestionar operaciones como el registro

en red, la comprobación de señal, la configuración del APN, la apertura de una sesión

de datos o el envío de peticiones HTTP. Esta aproximación separa la lógica de sensado

y control, ejecutada por el microcontrolador, de la complejidad de acceso a la red móvil,

delegada en el módem celular.

Los módulos LTE Cat 1 controlados mediante comandos AT resultan especialmente

relevantes en prototipos IoT que necesitan conexión directa a Internet sin desplegar

infraestructura radio propia. Su uso permite aprovechar redes móviles existentes

y enviar datos a plataformas cloud mediante protocolos ampliamente soportados,

aunque introduce dependencias asociadas a la cobertura, la tarjeta SIM, el consumo

energético y la correcta inicialización del módem [SIMCom Wireless Solutions, 2026,

SIMCom Wireless Solutions, 2024].

Dentro del ecosistema celular existen tecnologías más orientadas a IoT, como NB-

IoT y LTE-M. NB-IoT se orienta a mensajes pequeños, buena penetración y bajo

consumo. LTE-M ofrece mayor velocidad, menor latencia y mejor soporte de movilidad,

con más consumo y complejidad que NB-IoT [Raza et al., 2017]. Ambas dependen de

la disponibilidad del operador, de módulos compatibles y de condiciones comerciales

CAPÍTULO 2. ESTADO DEL ARTE Y FUNDAMENTOS TECNOLOGICOS ´ | 24

concretas.

Tecnología | Alcance | Consumo | Infraestructura | Limitación principal
WiFi | Corto/medio | Medio/alto | Red local y punto de acceso | Dependencia de red cercana
Bluetooth/BLE | Corto | Bajo | Dispositivo o pasarela cercana | Alcance insuficiente en campo
LoRa | Largo | Bajo | Enlace radio propio | Bajo caudal y diseño propio
LoRaWAN | Largo | Bajo | Gateways y servidores LoRaWAN | Más complejidad de despliegue
LTE/4G / LTE Cat 1 | Según cobertura | Medio/alto | Red de operador, SIM y módem celular | Consumo, SIM y dependencia de cobertura
NB-IoT | Amplio | Bajo | Red celular compatible | Disponibilidad variable
LTE-M | Amplio | Medio/bajo | Red celular compatible | Disponibilidad y coste

Tabla 2.3: Comparación general de tecnologías de conectividad para IoT en campo

La Tabla 2.3 debe interpretarse de forma cualitativa. El rendimiento real depende

de antena, orografía, distancia, carga de red, frecuencia utilizada, tamaño de mensajes

y frecuencia de transmisión. En campo abierto también importan la instalación, la

cobertura real, el mantenimiento y la recuperación ante fallos.

La decisión de conectividad exige elegir compromisos. LoRaWAN puede encajar

cuando se priorizan bajo consumo, mensajes esporádicos y despliegue propio. LTE/4G

y LTE Cat 1 pueden ser más adecuados cuando se busca aprovechar infraestructura

existente y disponer de comunicación directa con servicios de Internet. NB-IoT y

LTE-M son opciones relevantes para IoT celular, aunque dependen de disponibilidad

comercial y compatibilidad hardware.

En el contexto de TierraViva, esta revisión permite distinguir entre tecnologías

atractivas desde el punto de vista teórico y tecnologías asumibles dentro de un prototipo

validable. La conectividad no se valora únicamente por su alcance, sino también por la

disponibilidad de hardware, la facilidad de depuración, la integración con plataformas

cloud y la posibilidad de demostrar el funcionamiento extremo a extremo dentro del

alcance temporal del TFG.

Esta distinción fue relevante durante el desarrollo, porque una tecnología

técnicamente interesante puede no ser la más adecuada si obliga a dedicar la mayor

CAPÍTULO 2. ESTADO DEL ARTE Y FUNDAMENTOS TECNOLOGICOS ´ | 25

parte del TFG a desplegar infraestructura de comunicaciones en lugar de validar el

sistema completo.

## 2.7. Plataformas cloud para IoT

En una arquitectura IoT, la plataforma cloud actúa como punto intermedio entre

los dispositivos de campo y las aplicaciones que consumen la información. Recibe datos

de los nodos, los almacena, los organiza y permite consultarlos desde otros sistemas

o interfaces de usuario. Esta capa aporta acceso remoto y reduce la infraestructura

inicial necesaria. En arquitecturas con control local, su papel principal no es decidir la

actuación, sino facilitar la publicación de telemetría, la consulta remota y la supervisión

del sistema.

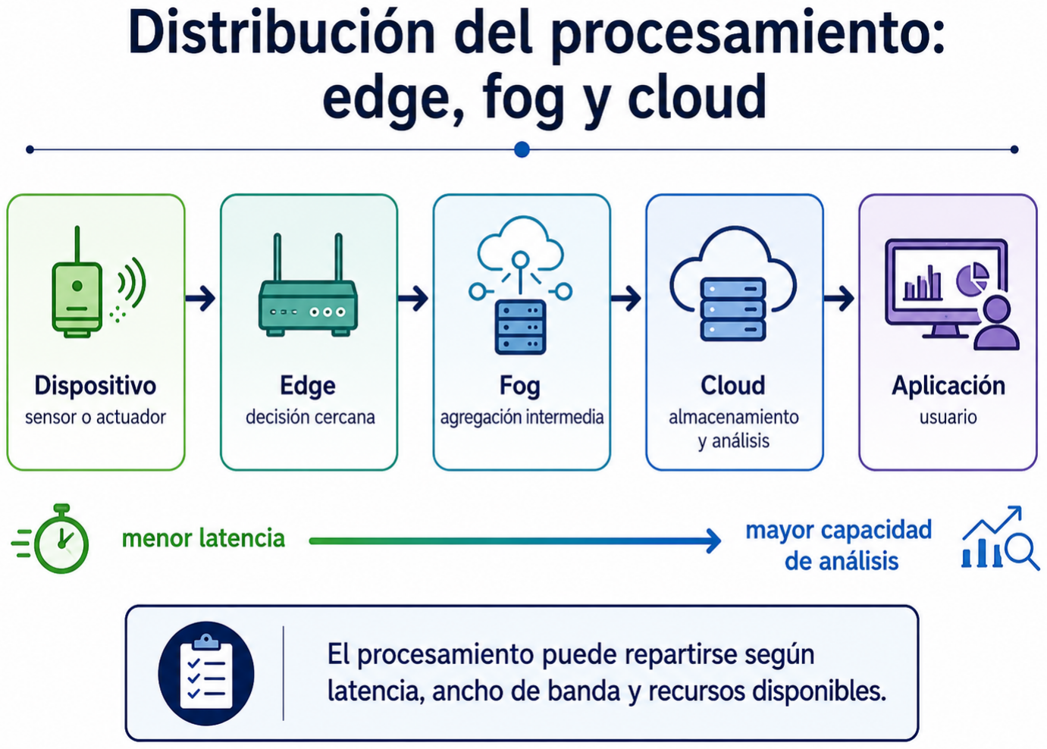
[picture p39: figure]

Figura 2.5: Distribución del procesamiento en arquitecturas IoT. El procesamiento puede situarse cerca del dispositivo, en el borde de la red, en capas intermedias tipo fog o en plataformas cloud, según los requisitos de latencia, ancho de banda, autonomía, disponibilidad de conectividad y capacidad de análisis.

Una función habitual es el almacenamiento de telemetría. La telemetría incluye

medidas de sensores, estados de funcionamiento, eventos o errores. Las plataformas IoT

suelen organizar esta información como series temporales asociadas a un dispositivo,

CAPÍTULO 2. ESTADO DEL ARTE Y FUNDAMENTOS TECNOLOGICOS ´ | 26

canal, variable o identificador. Así puede consultarse tanto el último valor recibido

como la evolución de una magnitud.

Muchas plataformas cloud incorporan herramientas de visualización. Gráficas,

paneles de control e indicadores de estado permiten comprobar rápidamente si los datos

llegan correctamente y si las variables evolucionan de forma coherente. En prototipos,

esta capacidad acelera la validación inicial.

Las APIs permiten que otros programas lean o escriban datos en la plataforma de

forma controlada. En IoT son necesarias para enviar telemetría desde los dispositivos

y para que otros sistemas puedan recuperar esa información, almacenarla, analizarla o

mostrarla. Dependiendo de la plataforma, estas APIs pueden utilizar HTTP, MQTT u

otros mecanismos de integración.

La organización de datos cambia según la herramienta: canales, dispositivos,

variables, feeds o datastreams. La idea común es agrupar datos relacionados y asociarlos

a una fuente concreta. Esta estructura evita mezclar flujos de distintas estaciones y

facilita la visualización posterior.

ThingSpeak es una plataforma de análisis IoT que permite agregar, visualizar

y analizar flujos de datos en la nube [MathWorks, 2026b]. Su estructura se basa

en canales y campos, de forma que un dispositivo puede escribir datos mediante

HTTP o MQTT y otros sistemas pueden leerlos mediante su API [MathWorks, 2026c,

MathWorks, 2026a]. Por su sencillez, se utiliza con frecuencia en prototipos académicos

y sistemas de monitorización sencilla.

En TierraViva, esta sencillez resulta especialmente útil: permite comprobar pronto

si las estaciones publican datos correctamente, antes de invertir esfuerzo en un

backend público propio o en una infraestructura cloud más compleja. Esto no elimina

la necesidad de diseñar correctamente el sistema de supervisión, pero sí reduce la

complejidad inicial y permite validar antes el flujo estación–plataforma–visualización.

Existen otras alternativas relevantes. Ubidots organiza la información mediante

dispositivos, variables, dashboards y eventos [Ubidots, 2025]. Adafruit IO proporciona

una API HTTP orientada a proyectos de electrónica conectada [Adafruit, 2026].

Blynk utiliza datastreams para estructurar los datos entre dispositivo y plataforma

[Blynk, 2025]. ThingsBoard permite recoger telemetría mediante distintos protocolos,

almacenarla como series temporales y utilizarla en dashboards, reglas y APIs

[ThingsBoard, 2026]. También puede construirse una plataforma propia con broker

MQTT, base de datos y herramienta de visualización, asumiendo a cambio su

instalación, mantenimiento y seguridad.

El uso de una plataforma cloud introduce dependencias. Si el dispositivo no puede

CAPÍTULO 2. ESTADO DEL ARTE Y FUNDAMENTOS TECNOLOGICOS ´ | 27

conectarse a Internet o si la plataforma no está disponible, el envío o la lectura de

datos puede fallar. La latencia también debe valorarse, sobre todo si la plataforma

participa en decisiones de control. Por este motivo, una arquitectura que mantiene la

decisión crítica en el nodo de campo reduce la dependencia operativa de la nube: la

pérdida temporal de conectividad puede afectar a la supervisión, pero no debe impedir

que la estación mantenga un estado seguro. Además, cada servicio puede imponer

límites de uso, frecuencia de actualización, volumen de datos, histórico disponible o

funcionalidades incluidas en planes gratuitos.

En este proyecto, esta idea se traduce en utilizar la plataforma cloud como apoyo

para la telemetría y la supervisión, no como sustituto de la lógica local de seguridad.

2.8. Protocolos de aplicación en IoT: HTTP,

## MQTT y CoAP

En un sistema IoT, la tecnología de comunicación transporta los datos, pero el

protocolo de aplicación define cómo se intercambia la información entre dispositivos,

plataformas, servidores y aplicaciones. HTTP, MQTT y CoAP representan tres

enfoques habituales con modelos distintos.

HTTP, del inglés Hypertext Transfer Protocol, es uno de los protocolos de aplicación

más extendidos en Internet. Funciona mediante un modelo de petición-respuesta:

un cliente realiza una solicitud a un servidor y este devuelve una respuesta. La

especificación RFC 9110 lo define como un protocolo de aplicación sin estado para

sistemas de información distribuidos [Fielding et al., 2022]. En IoT se utiliza con

frecuencia para enviar datos a APIs mediante peticiones GET o POST, especialmente

cuando la plataforma cloud ya ofrece este tipo de interfaz.

Su principal ventaja es la compatibilidad. Existen muchas herramientas, librerías,

servidores y plataformas capaces de trabajar con HTTP, lo que facilita la depuración

y la integración. Su limitación es conocida: no fue diseñado específicamente para

dispositivos IoT restringidos, puede introducir más sobrecarga que otras opciones y su

modelo petición-respuesta no siempre es el más eficiente para comunicación asíncrona

o mensajes muy frecuentes.

En prototipos que utilizan módulos celulares controlados mediante comandos AT,

HTTP puede resultar especialmente conveniente. Muchos módems LTE permiten

construir peticiones HTTP directamente desde el propio módulo, lo que simplifica

la publicación de datos hacia plataformas cloud compatibles. Esta opción no siempre

es la más eficiente desde el punto de vista energético, pero facilita la depuración y

CAPÍTULO 2. ESTADO DEL ARTE Y FUNDAMENTOS TECNOLOGICOS ´ | 28

reduce el número de servicios intermedios necesarios para validar el sistema. Además,

durante la depuración de un prototipo, una petición HTTP resulta relativamente

fácil de inspeccionar y reproducir, lo que simplifica la localización de errores frente

a arquitecturas que requieren broker, suscripciones persistentes o una infraestructura

adicional.

MQTT, del inglés Message Queuing Telemetry Transport, utiliza un modelo

de publicación/suscripción. Los dispositivos publican mensajes en un intermediario

llamado broker, y los clientes interesados se suscriben a determinados topics.

MQTT está estandarizado por OASIS como un protocolo ligero de mensajería

publicación/suscripción para contextos IoT y M2M [OASIS, 2019].

Este modelo desacopla productores y consumidores. Un nodo no necesita conocer

qué aplicación utilizará sus mensajes, solo el broker al que debe publicarlos. Esto encaja

bien con arquitecturas donde hay varios dispositivos, un backend, una base de datos,

dashboards o servicios de automatización. A cambio, el broker debe estar configurado,

disponible y protegido.

CoAP, del inglés Constrained Application Protocol, fue diseñado para dispositivos y

redes con recursos limitados. La especificación RFC 7252 lo define como un protocolo

web especializado para nodos restringidos y redes restringidas [Shelby et al., 2014].

Mantiene una filosofía similar a HTTP, basada en recursos y operaciones tipo petición-

respuesta, pero con una representación más ligera y habitualmente sobre UDP.

CoAP es interesante para redes de sensores y dispositivos embebidos de bajo

consumo. Su adopción práctica depende de que la plataforma, las librerías y la

infraestructura lo soporten de forma sencilla. En muchos prototipos, HTTP y MQTT

están más directamente disponibles en plataformas cloud y herramientas de desarrollo.

Protocolo | Modelo | Ventaja principal | Limitación principal
HTTP | Petición-respuesta | Muy compatible con APIs web | Más sobrecarga; no específico de IoT
MQTT | Publicación/suscrip-ción | Ligero y desacoplado mediante broker | Requiere broker disponible
CoAP | Petición-respuesta ligera | Diseñado para nodos restringidos | Menor disponibilidad práctica

Tabla 2.4: Comparación general entre HTTP, MQTT y CoAP en sistemas IoT

La Tabla 2.4 resume las diferencias principales. MQTT encaja bien con mensajería

ligera y comunicación asíncrona. CoAP es adecuado para nodos restringidos y redes de

CAPÍTULO 2. ESTADO DEL ARTE Y FUNDAMENTOS TECNOLOGICOS ´ | 29

bajo consumo. HTTP puede ser razonable cuando la prioridad es integrarse con APIs

existentes, plataformas cloud sencillas o servicios que ya exponen endpoints HTTP.

La elección del protocolo debe considerar la arquitectura completa: plataforma

cloud, librerías disponibles, frecuencia de envío, sentido de la comunicación, facilidad

de depuración y tiempo disponible para validar el prototipo. En TierraViva, esta

comparación permite justificar el uso de mecanismos compatibles con plataformas cloud

sencillas y con módulos celulares controlados mediante comandos AT para publicar

telemetría y estado, sin perder de vista que MQTT o CoAP podrían resultar adecuados

en evoluciones futuras con una infraestructura diferente.

## 2.9. Automatización, reglas e inteligencia artificial en riego

En riego inteligente conviene diferenciar entre automatización basada en reglas e

inteligencia artificial. Ambos enfoques pueden utilizar datos procedentes de sensores,

pero no toman decisiones del mismo modo. Un sistema automatizado trabaja con

condiciones explícitas definidas por el diseñador. Un sistema basado en inteligencia

artificial requiere modelos entrenados o ajustados a partir de datos históricos

suficientes.

La automatización basada en reglas es habitual en prototipos y sistemas de control

sencillos. Consiste en definir condiciones del tipo: si una variable supera o cae por debajo

de un valor, se ejecuta una acción. En riego, un ejemplo típico sería activar el sistema

cuando la humedad del suelo desciende por debajo de un umbral y detenerlo cuando se

alcanza una condición de cierre. Este control es fácil de interpretar, validar y explicar.

Además, cuando las reglas se ejecutan en el propio nodo de campo, la actuación no

depende de que exista comunicación permanente con un servidor o equipo externo.

El uso de umbrales permite establecer límites claros, pero un único umbral puede

provocar conmutaciones repetidas si la medida oscila alrededor del valor definido. Para

evitarlo se introduce histéresis: dos valores distintos, uno para activar el riego y otro

para desactivarlo. Es una técnica sencilla, pero mejora la estabilidad ante ruido o

pequeñas variaciones.

Además de las reglas de decisión, en riego son necesarias reglas de seguridad. Estas

no buscan optimizar el riego, sino evitar situaciones no deseadas: limitar el tiempo

máximo de activación del actuador, detener el riego ante lecturas inválidas, ignorar

valores imposibles, aplicar un tiempo mínimo entre actuaciones y actuar de forma

conservadora ante errores de sensor, alimentación o comunicación.

CAPÍTULO 2. ESTADO DEL ARTE Y FUNDAMENTOS TECNOLOGICOS ´ | 30

La inteligencia artificial introduce un enfoque distinto. Los modelos pueden

aprender patrones a partir de datos históricos y utilizarlos para predecir

comportamientos futuros o detectar situaciones anómalas. En riego, esto podría

aplicarse a predicción de humedad del suelo, estimación de necesidades hídricas,

detección de fallos en sensores o identificación de patrones de consumo. Las revisiones

sobre riego inteligente y agricultura de precisión destacan el interés de estas técnicas

cuando existe información suficiente [Abioye et al., 2020, Bwambale et al., 2022].

No basta con utilizar la palabra “inteligente” ni con aplicar condiciones

programadas manualmente para hablar de IA. Un conjunto de reglas del tipo si-

entonces puede ser útil y técnicamente adecuado, pero no constituye por sí mismo un

modelo de inteligencia artificial. Para hablar con rigor de IA sería necesario disponer

de datos históricos representativos, seleccionar un modelo, entrenarlo, validarlo y

comprobar que aporta valor frente a una estrategia basada en reglas simples.

En agricultura, esta exigencia es especialmente importante. Los datos dependen del

tipo de suelo, clima, estación del año, cultivo, ubicación de los sensores, frecuencia de

riego y condiciones de mantenimiento. Un modelo entrenado con pocos datos o con

datos poco representativos podría tomar decisiones poco fiables. Aunque las técnicas

de IA aplicadas a sensores agrícolas y monitorización de cultivos tienen un potencial

claro [Taha et al., 2025, Naqvi et al., 2025], su uso debe plantearse con cuidado.

La detección de anomalías puede ser una línea especialmente interesante. Un sistema

podría identificar valores fuera de rango, sensores que dejan de variar, caídas bruscas

de una variable o diferencias anormales entre estaciones. Estas funciones pueden

implementarse inicialmente mediante reglas simples y evolucionar hacia modelos más

avanzados si se dispone de suficiente histórico.

Para TierraViva, el enfoque basado en reglas verificables es una primera fase

razonable. Permite justificar cada actuación, facilita las pruebas y evita atribuir al

prototipo capacidades que todavía no han sido validadas. En esta versión, cada estación

evalúa condiciones simples y seguras, mientras que la Raspberry Pi conserva un papel

de supervisión e histórico. La inteligencia artificial queda como una línea futura cuando

exista un histórico amplio, fiable y suficientemente representativo.

## Capítulo 3

# Métodos, materiales y decisiones de diseño

Este capítulo concreta el diseño de TierraViva a partir del marco técnico descrito

en el capítulo anterior. Aquí se fijan los requisitos del sistema, se explican los criterios

de elección y se documentan las decisiones que han guiado el prototipo: qué debe medir

cada estación, cómo se comunica, qué papel conserva la Raspberry Pi y qué condiciones

deben cumplirse antes de actuar sobre el riego.

A diferencia del estado del arte, el análisis se centra ya en el proyecto desarrollado.

Algunas decisiones se tomaron de forma incremental, a medida que se validaban

sensores, comunicaciones y software de supervisión. Por ello, el capítulo no se limita

a enumerar materiales, sino que justifica por qué TierraViva adopta una arquitectura

distribuida con decisión local en las estaciones.

## 3.1. Requisitos funcionales del sistema

Los requisitos funcionales definen las capacidades que debe proporcionar el sistema

para cumplir con el alcance planteado para el proyecto. En el caso de TierraViva, estos

requisitos no se limitan a la lectura de sensores, sino que cubren el ciclo completo de

funcionamiento: adquisición de datos en campo, transmisión remota, almacenamiento,

visualización, toma de decisiones y actuación sobre el riego.

La definición de estos requisitos permite separar con claridad qué debe hacer el

sistema de cómo se implementa cada parte. Esta distinción es importante porque las

decisiones tecnológicas concretas se justifican en apartados posteriores. En este punto

se describe el comportamiento esperado del prototipo y la forma prevista de comprobar

que cada función queda cubierta durante la validación.

El sistema se plantea a partir de estaciones de campo capaces de obtener medidas

del entorno, evaluar localmente reglas sencillas de riego y enviar la información a

una plataforma intermedia. A partir de esos datos, el sistema de supervisión debe

poder registrar el histórico, visualizar el estado del prototipo y mostrar las actuaciones

31

CAPÍTULO 3. METODOS, MATERIALES Y DECISIONES DE DISE ´ | NÕ | 32

realizadas por cada estación. La estación de campo debe ejecutar la actuación de

forma autónoma y segura, evitando activaciones indefinidas, riegos repetidos o estados

peligrosos ante lecturas inválidas, errores de comunicación o fallos eléctricos.

En la Tabla 3.1 se recogen los principales requisitos funcionales considerados para

el diseño del prototipo.

CAPÍTULO 3. METODOS, MATERIALES Y DECISIONES DE DISE ´ | NÕ | 33
Códi-go | Requisito | Descripción | Validación prevista
RF-01 | Medición de humedad del suelo | El sistema debe obtener lecturas periódicas de la humedad del sustrato en la zona monitorizada. | Prueba con sensor capacitivo de humedad del suelo.
RF-02 | Medición ambiental | El sistema debe medir variables ambientales relevantes, incluyendo temperatura, humedad relativa y presión atmosférica. | Prueba con sensor ambiental.
RF-03 | Medición de luminosidad | El sistema debe registrar la luminosidad o nivel de luz ambiente para contextualizar las condiciones del entorno. | Prueba con variación de luz.
RF-04 | Envío remoto de telemetría | Las estaciones de campo deben enviar sus medidas a una plataforma remota para que puedan ser consultadas posteriormente. | Prueba de comunicación remota y recepción en plataforma cloud.
RF-05 | Identificación de estación | Cada lectura debe poder asociarse a la estación de origen, permitiendo distinguir los datos de distintas zonas o nodos. | Comprobación de registros diferenciados por estación.
RF-06 | Almacenamiento histórico | El sistema debe registrar las lecturas recibidas para conservar un histórico de funcionamiento. | Verificación de inserciones en SQLite.
RF-07 | Visualización del estado | El sistema debe ofrecer una interfaz de consulta que permita ver las últimas lecturas y el estado general del prototipo. | Prueba de dashboard web en navegador.
RF-08 | Decisión local de riego | Cada estación debe evaluar localmente si las condiciones medidas justifican una actuación sobre el riego. | Prueba de regla local de humedad, cooldown y estado seguro.
RF-09 | Actuación local sobre el riego | La estación debe accionar físicamente el sistema de riego mediante relé y bomba de agua durante un tiempo limitado por firmware. | Prueba controlada con relé y bomba/carga de prueba.
RF-10 | Publicación de estado de actuación | La estación debe publicar el estado del relé, el indicador de modo seguro y un código de estado que permita conocer si se ha producido una actuación, una situación de reposo o una incidencia. | Verificación de relay state, safe -mode y statusCode en ThingSpeak.
RF-11 | Seguridad de funcionamiento | El sistema debe desactivar o mantener apagada la bomba ante error de sensor, lectura inválida, fallo de comunicación, reinicio, cooldown activo o tiempo máximo excedido. | Pruebas de modo seguro, reinicio y límites de actuación.

Tabla 3.1: Requisitos funcionales del sistema TierraViva

Los tres primeros requisitos se relacionan con la adquisición de información en

campo. La humedad del suelo es la variable más directamente vinculada con la

decisión de riego, mientras que las variables ambientales permiten interpretar mejor

CAPÍTULO 3. METODOS, MATERIALES Y DECISIONES DE DISE ´ | NÕ | 34

las condiciones en las que se encuentra la zona monitorizada. En esta fase no se

busca realizar un análisis agronómico completo, sino obtener un conjunto de medidas

suficiente para validar el comportamiento del prototipo.

Los requisitos RF-04, RF-05 y RF-06 cubren el flujo de datos desde la estación hasta

la plataforma intermedia y el sistema de supervisión. La telemetría debe recibirse de

forma remota, quedar asociada a una estación concreta y almacenarse para su consulta

posterior. Esta trazabilidad es necesaria para que el sistema no dependa únicamente de

la última lectura recibida y para poder analizar la evolución de las variables durante

las pruebas.

El requisito RF-07 se centra en la interacción con el usuario. Aunque el sistema

pueda funcionar internamente, su utilidad queda limitada si no existe una forma clara

de consultar el estado de las estaciones. Por ello, el dashboard debe permitir revisar

las medidas recientes, detectar si los datos llegan correctamente y comprobar el estado

general del sistema sin recurrir a mensajes de consola o consultas manuales a la base

de datos.

Los requisitos RF-08, RF-09 y RF-10 introducen la parte de control. En la

arquitectura final, la decisión de riego se ejecuta localmente en cada estación mediante

reglas verificables, especialmente durante esta primera versión del prototipo. La

estación no depende de una decisión externa para actuar: evalúa sus sensores,

comprueba las condiciones de seguridad, activa la bomba si corresponde y publica

después su estado. Esta publicación incluye las medidas ambientales, el estado del relé,

el indicador de modo seguro y un código de estado. Con esa información, la Raspberry

Pi puede supervisar lo ocurrido y conservar un histórico sin convertirse en un punto

único de decisión para el riego.

El requisito RF-11 se ha definido de forma explícita porque la actuación sobre riego

implica un riesgo mayor que la simple monitorización. Un fallo de software, una lectura

inválida, un reinicio inesperado o una comunicación incompleta no deben provocar

una activación indefinida de la bomba. Por ese motivo, el sistema debe adoptar un

comportamiento conservador: ante una situación no válida o no verificable, el estado

seguro será mantener la bomba apagada.

Estos requisitos funcionales servirán como base para las decisiones de diseño

del resto del capítulo y para la estrategia de validación descrita más adelante.

Cada requisito debe poder relacionarse con una prueba concreta, de forma que el

cumplimiento del sistema no se justifique solo por diseño, sino también mediante

evidencias experimentales.

CAPÍTULO 3. METODOS, MATERIALES Y DECISIONES DE DISE ´ | NÕ | 35

## 3.2. Requisitos no funcionales

Los requisitos no funcionales describen las condiciones de calidad que debe cumplir

el sistema, más allá de las funciones concretas indicadas en el apartado anterior.

En TierraViva estos requisitos son especialmente importantes porque el proyecto no

consiste únicamente en que cada bloque funcione de forma aislada, sino en que el

conjunto pueda integrarse, probarse, ampliarse y defenderse como un prototipo de

ingeniería.

Al tratarse de un Trabajo Fin de Grado, el sistema debe mantener un equilibrio

entre ambición técnica y viabilidad. No se pretende desarrollar un producto industrial

cerrado, pero sí una solución suficientemente robusta, ordenada y reproducible como

para demostrar el funcionamiento completo de la arquitectura propuesta. La Tabla 3.2

resume los principales requisitos no funcionales considerados.

CAPÍTULO 3. METODOS, MATERIALES Y DECISIONES DE DISE ´ | NÕ | 36
Código | Requisito | Descripción
RNF-01 | Modularidad | El sistema debe organizarse en bloques diferenciados: estación de campo autónoma, comunicación, almacenamiento, supervisión, visualización y actuación local.
RNF-02 | Bajo coste | Los componentes seleccionados deben ser asumibles para un prototipo académico, evitando soluciones industriales de coste elevado cuando no sean necesarias.
RNF-03 | Reproducibilidad | El montaje, la configuración y las pruebas deben poder repetirse a partir de la documentación generada durante el proyecto.
RNF-04 | Facilidad de depuración | El sistema debe permitir probar los bloques por separado, identificar errores y consultar salidas intermedias durante el desarrollo.
RNF-05 | Consumo razonable | El diseño debe evitar consumos innecesarios y permitir una futura alimentación autónoma, aunque la optimización energética completa no sea el objetivo principal.
RNF-06 | Tolerancia a fallos | El sistema debe contemplar fallos de lectura, comunicación o actuación, adoptando estados seguros cuando no sea posible garantizar un funcionamiento correcto.
RNF-07 | Escalabilidad | La arquitectura debe permitir incorporar más de una estación de campo sin rediseñar completamente el sistema.
RNF-08 | Claridad de visualización | La interfaz debe presentar la información de forma comprensible, diferenciando lecturas, estados y posibles incidencias.
RNF-09 | Adecuación académica | El alcance debe ser realizable dentro del tiempo y medios disponibles para el TFG, priorizando funciones verificables frente a desarrollos excesivamente complejos.

Tabla 3.2: Requisitos no funcionales del sistema TierraViva

La modularidad es uno de los requisitos más importantes del proyecto. Separar

el sistema en bloques permite desarrollar y validar cada parte de forma progresiva,

evitando que la actuación sobre el riego dependa de un único componente externo. Por

ejemplo, la lectura de sensores puede comprobarse antes de integrar la comunicación

remota, y la visualización puede probarse inicialmente con datos simulados o recibidos

por otros medios. Esta forma de trabajo reduce el riesgo de que un fallo en una capa

impida avanzar en el resto del sistema.

El bajo coste no se interpreta como elegir siempre el componente más barato,

sino como seleccionar materiales razonables para el alcance del prototipo. En un TFG

resulta más adecuado emplear plataformas y módulos accesibles, bien documentados

CAPÍTULO 3. METODOS, MATERIALES Y DECISIONES DE DISE ´ | NÕ | 37

y fáciles de sustituir, siempre que proporcionen prestaciones suficientes para validar

la arquitectura. Esta decisión también favorece la reproducibilidad, ya que otros

estudiantes o desarrolladores podrían replicar el montaje sin depender de equipos

propietarios o excesivamente específicos.

La reproducibilidad está directamente relacionada con la documentación del

proceso. Las conexiones, configuraciones, pruebas, errores encontrados y decisiones de

diseño deben quedar registrados con suficiente detalle. Esto no solo facilita la redacción

de la memoria, sino que también permite justificar ante el tribunal que el sistema no

se ha construido como una prueba puntual difícil de repetir, sino como un prototipo

técnico verificable.

La facilidad de depuración también ha condicionado el planteamiento del trabajo.

En un sistema con sensores, comunicaciones, base de datos, dashboard y actuación

física, no es práctico probar todo únicamente al final. El sistema debe permitir observar

salidas intermedias, comprobar lecturas por separado, revisar registros, analizar

respuestas de comunicación y validar la actuación en condiciones controladas. Esta

capacidad resulta clave para detectar errores de cableado, problemas de alimentación,

fallos de formato en los datos o comportamientos inesperados en la lógica de control.

El consumo energético debe mantenerse en valores razonables. Aunque la

optimización completa de autonomía no forma parte del núcleo del TFG, el sistema

se orienta a estaciones de campo que podrían funcionar con batería o alimentación

solar en futuras versiones. Por ello, el diseño no debe ignorar el consumo de módulos

de comunicación, sensores y actuadores. En especial, la actuación sobre una bomba de

agua y el uso de comunicaciones remotas obligan a considerar la alimentación como

una restricción real del sistema.

La tolerancia a fallos es especialmente relevante porque TierraViva incorpora

actuación sobre el riego. Un error en una medida puede ser aceptable si queda registrado

y no se utiliza de forma crítica, pero un error que provoque la activación indefinida

de la bomba sí comprometería el funcionamiento del sistema. Por este motivo, el

comportamiento ante fallos debe ser conservador: si falta información, si una lectura

no es válida o si se supera un límite de seguridad, el sistema debe priorizar el apagado

de la bomba.

La escalabilidad se plantea de forma limitada pero necesaria. El prototipo debe

poder trabajar con más de una estación de campo, al menos desde el punto de vista

de identificación, almacenamiento y visualización. Esto implica que los datos no deben

tratarse como si procedieran de un único nodo, sino que deben conservar la referencia

de la estación de origen. Esta decisión facilita futuras ampliaciones a varias zonas de

CAPÍTULO 3. METODOS, MATERIALES Y DECISIONES DE DISE ´ | NÕ | 38

riego o parcelas diferenciadas.

Por último, la claridad de visualización y la adecuación al alcance académico

condicionan la forma de presentar el sistema. El dashboard debe servir para entender

el estado del prototipo sin obligar al usuario a interpretar directamente tramas, códigos

internos o registros de depuración. Al mismo tiempo, el proyecto debe evitar prometer

funcionalidades que no puedan validarse con rigor dentro del tiempo disponible. En este

sentido, se priorizan decisiones simples, trazables y defendibles frente a soluciones más

complejas que aumentarían el riesgo de integración sin aportar una mejora proporcional

al objetivo del TFG.

## 3.3. Especificaciones temporales y operativas

Además de los requisitos funcionales y no funcionales, el sistema necesita definir una

serie de parámetros temporales y criterios operativos que regulen su comportamiento

durante el funcionamiento. En un sistema IoT de riego, estos valores son importantes

porque afectan al consumo energético, a la carga de comunicaciones, a la capacidad de

respuesta y, sobre todo, a la seguridad de la actuación sobre la bomba de agua.

Las especificaciones temporales no se plantean como valores rígidos e inmodificables,

sino como parámetros iniciales de diseño. Durante el desarrollo y la validación del

prototipo pueden ajustarse en función de los resultados obtenidos, siempre manteniendo

dos criterios principales: evitar comunicaciones innecesarias y garantizar que cualquier

actuación sobre el riego quede limitada en el tiempo.

En la Tabla 3.3 se recogen las principales especificaciones temporales y operativas

consideradas para TierraViva.

CAPÍTULO 3. METODOS, MATERIALES Y DECISIONES DE DISE ´ | NÕ | 39
Código | Parámetro | Valor inicial | Criterio operativo
ET-01 | Periodo de lectura de sensores | 30 s | Las estaciones toman medidas periódicas del entorno sin necesidad de lectura continua.
ET-02 | Frecuencia de envío de telemetría | 30 s | Cada estación envía sus datos de forma periódica, evitando tráfico innecesario.
ET-03 | Frecuencia de actualización del dashboard | 3–5 s | La interfaz consulta el estado con mayor frecuencia que la llegada real de nuevos datos.
ET-04 | Intervalo de evaluación local | 30 s | Cada estación evalúa periódicamente sus lecturas y comprueba si se cumplen las condiciones locales de riego.
ET-05 | Tiempo máximo de bomba activa | 60 s | La activación de la bomba queda limitada para evitar riego indefinido ante errores de control.
ET-06 | Tiempo mínimo entre riegos | Configurable | Se aplica un periodo de espera para evitar actuaciones repetidas en poco tiempo.
ET-07 | Tiempo máximo sin publicación válida | 5 min | Si la estación no consigue publicar telemetría durante este periodo, registra la incidencia cuando sea posible y garantiza que una actuación en curso no permanezca activa sin control.
ET-08 | Estado seguro por defecto | Bomba apagada | Al arrancar, ante error de lectura, fallo de comunicación o condición no verificable, la estación mantiene desactivado el riego.
ET-09 | Comportamiento ante dato inválido | Ignorar y registrar | Las lecturas no válidas no deben provocar una actuación automática.
ET-10 | Comportamiento ante pérdida de comunicación | Bomba apagada o no actuación | La pérdida de comunicación no debe dejar la bomba activa.

Tabla 3.3: Especificaciones temporales y operativas iniciales del sistema

CAPÍTULO 3. METODOS, MATERIALES Y DECISIONES DE DISE ´ | NÕ | 40

El periodo de lectura y envío de telemetría se fija inicialmente en 30 segundos.

Este valor permite observar la evolución de las variables medidas sin generar un

volumen excesivo de comunicaciones. En un sistema de riego no resulta necesario

enviar datos cada segundo, ya que la humedad del suelo y las condiciones ambientales

no cambian con tanta rapidez como para justificar una frecuencia tan elevada. Para

demostraciones o pruebas concretas, este intervalo podría reducirse temporalmente,

pero no se considera necesario para el funcionamiento normal del prototipo.

La actualización del dashboard se plantea con una frecuencia mayor que la recepción

de nuevos datos. Esto permite que la interfaz sea más dinámica y pueda mostrar

información como la última actualización recibida, el estado de conexión o posibles

avisos de datos obsoletos. No obstante, debe quedar claro que refrescar la interfaz cada

pocos segundos no implica que la estación esté generando nuevas medidas con esa

misma frecuencia.

El intervalo de evaluación local se vincula al periodo de lectura y envío de telemetría.

Como la decisión de riego se ejecuta en la propia estación, no es necesario mantener un

mecanismo remoto de control para decidir la actuación. La estación lee sus sensores,

actualiza su estado interno y comprueba si se cumplen las condiciones de riego en cada

ciclo. Este enfoque reduce la dependencia de la conectividad externa y simplifica la

lógica de actuación.

La actuación sobre la bomba de agua se trata como el punto más crítico desde

el punto de vista operativo. Cualquier activación debe estar limitada por un tiempo

máximo, ya que un fallo software, una lectura errónea, un reinicio inesperado o un

problema de comunicación no deben traducirse en un riego indefinido. Aunque la

duración concreta pueda ajustarse durante las pruebas, el firmware debe impedir que

la bomba permanezca activa más tiempo del permitido.

Además, después de cada actuación debe aplicarse un tiempo mínimo entre riegos.

Este periodo de espera evita activaciones continuas provocadas por lecturas inestables,

reinicios, ruido en la medida o pequeñas oscilaciones alrededor del umbral de decisión.

En una primera versión del prototipo, este parámetro puede configurarse de forma

conservadora y ajustarse posteriormente a partir de las pruebas.

El estado seguro por defecto del sistema es la bomba apagada. Esta decisión afecta

tanto al arranque como a las situaciones de error. Si la estación se reinicia, si detecta

una lectura inválida, si entra en cooldown, si pierde comunicación o si se supera el

tiempo máximo de actuación, el sistema debe volver a un estado conservador. En este

proyecto se considera preferible no regar ante una situación no verificable antes que

mantener la bomba funcionando sin control.

CAPÍTULO 3. METODOS, MATERIALES Y DECISIONES DE DISE ´ | NÕ | 41

Finalmente, los datos inválidos no deben utilizarse para tomar decisiones

automáticas. Una lectura fuera de rango, ausente o incoherente debe registrarse como

incidencia o descartarse, pero no debe activar la bomba por sí sola. Esta especificación

refuerza el criterio general del sistema: TierraViva debe poder actuar sobre el riego,

pero solo cuando la información disponible y el estado operativo sean suficientemente

fiables.

## 3.4. Metodología de trabajo

La metodología seguida en TierraViva se ha basado en un desarrollo incremental por

bloques. En lugar de intentar construir el sistema completo desde el primer momento,

se ha dividido el proyecto en fases más pequeñas, cada una orientada a validar una

parte concreta de la arquitectura. Este enfoque resulta adecuado para un sistema IoT

con sensores, comunicaciones, almacenamiento, visualización y actuación física, ya que

permite aislar errores y reducir el riesgo de integración.

La idea principal ha sido avanzar desde pruebas controladas hacia una arquitectura

cada vez más cercana al funcionamiento final. Primero se analizaron las necesidades

del problema y las alternativas tecnológicas disponibles. Después se desarrollaron

prototipos parciales para comprobar sensores, comunicaciones, almacenamiento y

visualización. Finalmente, las distintas partes se fueron conectando hasta formar una

solución de monitorización y control más completa.

Esta forma de trabajo también ha permitido documentar decisiones y cambios de

enfoque. En un proyecto de este tipo, no todas las decisiones se pueden cerrar desde el

principio, ya que algunas dependen de la disponibilidad real de hardware, de la facilidad

de integración o de los resultados obtenidos en pruebas. Por ello, la metodología no se

ha limitado a implementar una arquitectura previamente fija, sino que ha incorporado

revisión, validación y corrección de decisiones durante el desarrollo.

En la Tabla 3.4 se resumen las fases principales seguidas durante el proyecto.

CAPÍTULO 3. METODOS, MATERIALES Y DECISIONES DE DISE ´ | NÕ | 42
Fase | Nombre | Objetivo principal
1 | Análisis inicial del problema | Identificar la necesidad de monitorizar y controlar el riego en un entorno no supervisado de forma continua.
2 | Revisión tecnológica | Estudiar alternativas de sensorización, plataformas embebidas, comunicaciones, almacenamiento, visualización y actuación.
3 | Diseño conceptual de la arquitectura | Definir los bloques principales del sistema y la relación entre estaciones autónomas de campo, plataforma intermedia, sistema de supervisión y actuador.
4 | Prototipo local con Raspberry | Validar una primera cadena de adquisición, mensajería, almacenamiento y visualización mediante Raspberry Pi, MQTT, SQLite, FastAPI y dashboard.
5 | Validación de sensores | Comprobar el funcionamiento de los sensores de humedad de suelo, luminosidad y variables ambientales antes de integrarlos en una estación.
6 | Validación de comunicaciones | Probar la comunicación remota necesaria para publicar telemetría y estado desde las estaciones.
7 | Elección de plataforma cloud | Seleccionar una plataforma intermedia que permitiera publicar telemetría, consultar datos remotos y supervisar el estado de las estaciones de forma sencilla y verificable.
8 | Diseño de actuación local | Definir el control autónomo de la bomba de agua mediante relé, incluyendo reglas locales, tiempos máximos, cooldown y estado seguro.
9 | Integración de subsistemas | Conectar adquisición, comunicación, supervisión, almacenamiento, visualización, decisión local y actuación en una arquitectura coherente.
10 | Validación experimental | Comprobar el funcionamiento del sistema mediante pruebas parciales, pruebas de estación autónoma y pruebas de supervisión extremo a extremo.
11 | Documentación de incidencias y decisiones | Registrar problemas encontrados, alternativas descartadas, cambios de enfoque y criterios técnicos adoptados.

Tabla 3.4: Fases principales de la metodología de trabajo

La primera fase consistió en analizar el problema desde el punto de vista funcional.

No se trataba únicamente de medir humedad o mostrar datos, sino de diseñar un

sistema capaz de observar el entorno, transmitir información, registrar un histórico,

visualizar el estado y actuar sobre el riego de forma controlada. Esta fase permitió

transformar una necesidad práctica en un conjunto de requisitos técnicos, descritos en

CAPÍTULO 3. METODOS, MATERIALES Y DECISIONES DE DISE ´ | NÕ | 43

los apartados anteriores.

A continuación, se realizó una revisión tecnológica centrada en las áreas que

condicionaban el diseño: sensores agrícolas, arquitecturas IoT, plataformas embebidas,

comunicaciones para entornos rurales, plataformas cloud, protocolos de aplicación y

mecanismos de automatización. Esta revisión no tuvo como objetivo elegir la tecnología

más avanzada en términos absolutos, sino identificar qué opciones eran viables para un

prototipo académico, reproducible y defendible.

La tercera fase fue el diseño conceptual de la arquitectura. En este punto

se definieron los bloques principales del sistema: estaciones de campo, adquisición

de datos, comunicación remota, plataforma intermedia, sistema de supervisión,

almacenamiento, dashboard y actuación. Esta separación en bloques permitió trabajar

de forma progresiva, validando cada parte antes de integrarla con el resto.

Una fase especialmente útil fue el desarrollo de un prototipo local previo con

Raspberry Pi. En esta etapa se utilizó una arquitectura basada en MQTT, SQLite,

FastAPI y un dashboard web para comprobar la cadena de tratamiento de datos.

Este prototipo no debe interpretarse como la arquitectura final de comunicaciones del

sistema, sino como una fase intermedia de validación. Permitió probar la recepción de

mensajes, el almacenamiento en base de datos, la exposición de datos mediante API y

la visualización en navegador antes de incorporar la comunicación remota definitiva de

las estaciones.

La validación de sensores se realizó de forma independiente. Primero se comprobó el

bus I2C y las direcciones de los sensores digitales, y después se integraron las lecturas de

luminosidad, temperatura, humedad relativa, presión y humedad de suelo. Esta fase fue

necesaria para evitar que un fallo de cableado, dirección I2C o librería se confundiera

posteriormente con un problema de comunicación o de backend. En el caso del sensor

de humedad de suelo, además, se trabajó inicialmente con valores brutos, dejando la

calibración completa con suelo seco y húmedo como parte de la validación experimental.

La validación de comunicaciones se planteó también de forma separada. Antes de

integrar el módulo de comunicaciones con el firmware de estación, se comprobó su

funcionamiento mediante comandos AT, verificando aspectos como identificación del

módulo, estado de la SIM, nivel de señal, registro en red, dirección IP y capacidad de

comunicación HTTP. Esta forma de trabajo permitió aislar los problemas propios del

módem antes de mezclarlos con la lectura de sensores o la lógica de control.

Tras estas pruebas, se valoró la plataforma cloud más adecuada para el prototipo.

La decisión debía tener en cuenta que las estaciones de campo no estarían conectadas

físicamente a la Raspberry Pi, por lo que la telemetría y el estado de funcionamiento

CAPÍTULO 3. METODOS, MATERIALES Y DECISIONES DE DISE ´ | NÕ | 44

debían publicarse en una plataforma accesible por red. Por este motivo, la plataforma

intermedia debía permitir la escritura de datos desde las estaciones y la consulta

posterior desde el sistema de supervisión, sin exigir una comunicación directa entre

los nodos de campo y la Raspberry Pi.

El diseño de actuación se abordó como un bloque crítico. A diferencia de la

monitorización, la actuación sobre riego tiene consecuencias físicas: una bomba

activa durante demasiado tiempo puede provocar consumo innecesario de agua o

funcionamiento incorrecto del sistema. Por ello, el control mediante relé se diseñó con

un criterio conservador: bomba apagada por defecto, tiempo máximo de activación,

validación de lecturas, cooldown, bloqueo ante estados no verificables y publicación del

estado de la actuación.

La integración de subsistemas se realizó después de validar las partes principales.

Esta integración incluyó la unión entre adquisición de datos, comunicación,

almacenamiento, visualización, lógica local de decisión y actuación. El objetivo no era

solo que cada bloque funcionara por separado, sino comprobar que la estación podía

medir, decidir, actuar y publicar su estado, y que la Raspberry Pi podía supervisar ese

comportamiento a partir de los datos disponibles en la plataforma intermedia.

La validación experimental se planteó en varios niveles. En primer lugar, se

realizaron pruebas unitarias de sensores y comunicación. Después, pruebas parciales

de almacenamiento, API y dashboard. Finalmente, se prevén pruebas de integración

para comprobar el flujo completo: adquisición de datos en estación, decisión local de

riego, actuación sobre el relé, publicación de telemetría y estado, registro histórico y

visualización desde la Raspberry Pi.

Por último, durante el desarrollo se ha mantenido una documentación de incidencias

y decisiones. Esta parte es relevante porque el proyecto ha requerido corregir supuestos

iniciales, separar prototipos previos de arquitectura final y ajustar decisiones conforme

se obtenían resultados reales. Registrar estos cambios no se considera una debilidad,

sino una parte natural del proceso de ingeniería, ya que permite justificar por qué se

adoptó una solución concreta y qué alternativas quedaron descartadas o reservadas

para trabajos futuros.

El cambio de enfoque más importante fue separar definitivamente supervisión y

control local. En una versión inicial se valoró que la Raspberry Pi centralizara parte de

la lógica de riego, pero finalmente se optó por desplazar esa responsabilidad al firmware

de cada estación. Esta modificación simplificó el flujo de comunicación, eliminó la

necesidad de transportar órdenes de riego por la nube y redujo la dependencia de la

Raspberry como punto único de decisión.

CAPÍTULO 3. METODOS, MATERIALES Y DECISIONES DE DISE ´ | NÕ | 45

## 3.5. Arquitectura general planteada

A partir de los requisitos definidos en los apartados anteriores, la arquitectura

general de TierraViva se plantea como un sistema IoT distribuido, formado por

estaciones autónomas de campo, una plataforma intermedia de comunicación y un

sistema de supervisión basado en Raspberry Pi. El objetivo de esta arquitectura es

separar claramente la adquisición de datos, la decisión local, la actuación física, la

publicación de telemetría, el almacenamiento histórico y la visualización.

La arquitectura se ha diseñado teniendo en cuenta una restricción importante: las

estaciones de campo no están conectadas físicamente a la Raspberry Pi. Por tanto, no

se puede asumir una comunicación directa mediante USB, puerto serie o red local entre

ambos extremos. Las estaciones deben poder enviar datos de forma remota mediante

el módulo LTE, y la Raspberry debe consultar esa información desde la plataforma

intermedia. Esto condiciona el diseño completo del sistema y evita que el riego dependa

de una conexión local o de una orden enviada desde la Raspberry.

En términos generales, el sistema se divide en cuatro bloques principales:

Estaciones autónomas de campo: encargadas de medir las variables del

entorno, evaluar reglas locales de riego, accionar la bomba mediante relé y

publicar telemetría y estado.

Capa de comunicaciones y plataforma intermedia: responsable de recibir

los datos publicados por las estaciones y hacerlos accesibles para consulta remota.

Sistema de supervisión: implementado sobre Raspberry Pi, encargado de

consultar datos, almacenarlos, exponer una API y servir el dashboard.

Interfaz de usuario: orientada a visualizar el estado del sistema, revisar el

histórico y supervisar las actuaciones realizadas por las estaciones.

La Figura 3.1 muestra una visión general de la arquitectura planteada.

CAPÍTULO 3. METODOS, MATERIALES Y DECISIONES DE DISE ´ | NÕ | 46

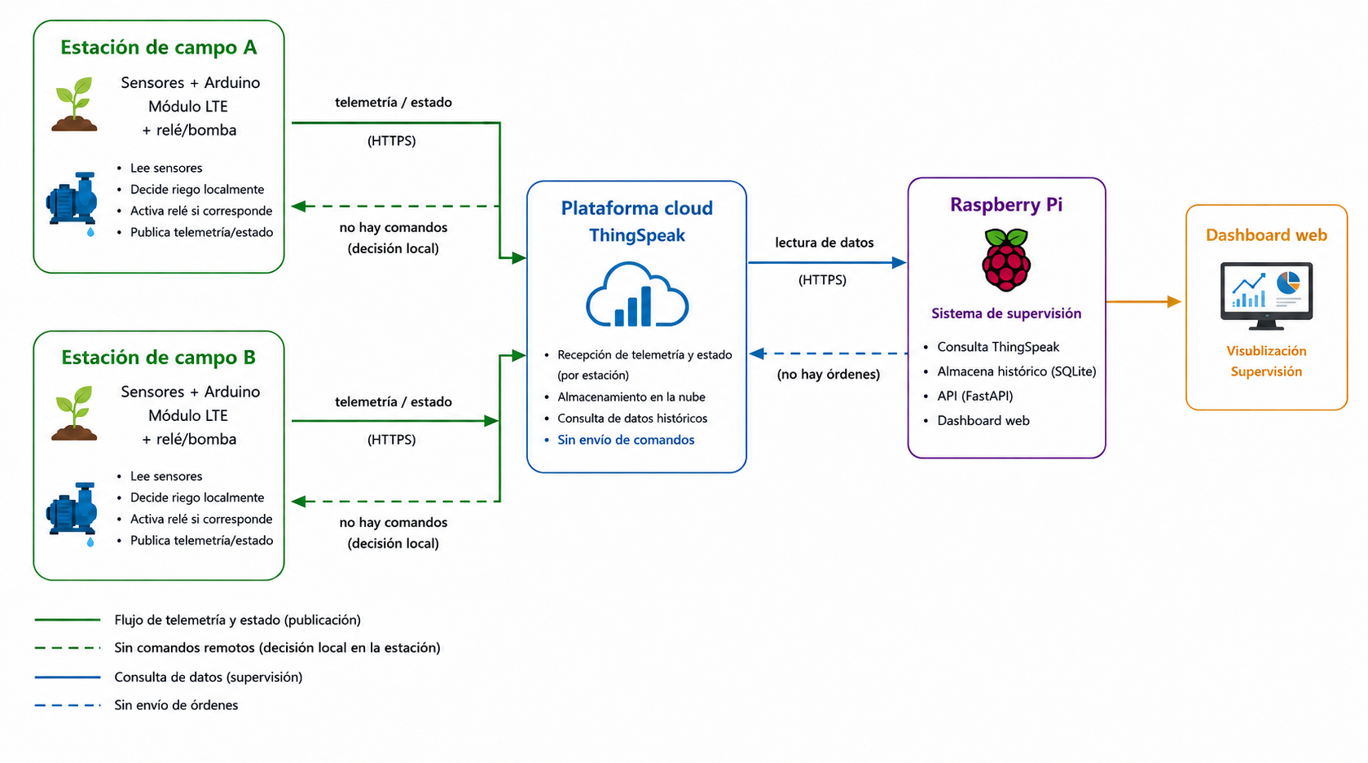
[picture p40: figure]

Figura 3.1: Arquitectura general planteada para TierraViva.

En esta sección no se entra todavía en el detalle de implementación; ese desarrollo

se reserva para el capítulo siguiente. Lo importante aquí es dejar fijado el reparto de

responsabilidades entre estaciones, plataforma intermedia, Raspberry Pi y dashboard.

Las estaciones de campo se encargan de la interacción directa con el entorno físico y

de la actuación sobre el riego. ThingSpeak permite publicar y consultar la telemetría

de forma remota. La Raspberry Pi actúa como sistema de supervisión, histórico y

visualización, sin convertirse en el elemento responsable de decidir la activación de la

bomba.

Esta división condiciona el resto de decisiones del proyecto. La actuación sobre

el riego debe ejecutarse localmente en la estación, donde se encuentra físicamente la

bomba. De este modo, una pérdida de conectividad o una indisponibilidad temporal de

la Raspberry no impide que la estación conserve un comportamiento seguro. El detalle

de la arquitectura final, incluyendo los canales concretos de ThingSpeak, el flujo de

telemetría, la publicación de estado y el papel de la Raspberry Pi como sistema de

supervisión, se desarrolla en el Capítulo 4.

## 3.6. Elección de variables y sensores

La selección de variables medidas se ha realizado teniendo en cuenta el papel que

deben cumplir dentro del prototipo: monitorizar el estado de una zona de cultivo y

aportar información suficiente para alimentar la decisión local de riego en cada estación.

No se pretende medir todos los parámetros agronómicos posibles, sino elegir un conjunto

CAPÍTULO 3. METODOS, MATERIALES Y DECISIONES DE DISE ´ | NÕ | 47

reducido de variables que permita validar el comportamiento del prototipo de forma

razonable, reproducible y coherente con el alcance del TFG.

En TierraViva se combinan variables del suelo y variables ambientales. La humedad

del suelo se considera la variable principal para la decisión local de riego, ya que

aporta información directa sobre la disponibilidad de agua en el sustrato. Las variables

ambientales, como temperatura, humedad relativa, presión atmosférica y luminosidad,

no sustituyen a la humedad del suelo, pero ayudan a interpretar el contexto en el

que evoluciona la zona monitorizada. Esta combinación es habitual en sistemas de

agricultura de precisión basados en sensores, donde el interés no está solo en una

lectura aislada, sino en la observación conjunta del entorno [Soussi et al., 2024].

Variable | Función en el sistema | Motivo de selección
Humedad del suelo | Variable principal para la decisión de riego. | Indica de forma directa si el sustrato presenta condiciones de sequedad o humedad.
Temperatura ambiente | Variable de contexto ambiental. | Ayuda a interpretar evaporación, estrés térmico y condiciones generales del entorno.
Humedad relativa | Información ambiental complementaria. | Permite contextualizar la pérdida de agua y las condiciones de evaporación.
Presión atmosférica | Dato adicional del sensor ambiental. | Aporta contexto ambiental y se obtiene sin añadir un sensor específico.
Luminosidad | Indicador de exposición solar. | Permite identificar condiciones de luz que pueden influir en evaporación y demanda hídrica.

Tabla 3.5: Variables seleccionadas para la monitorización de TierraViva

La humedad del suelo se ha seleccionado como variable principal porque es la más

relacionada con la necesidad de riego. Un sistema que decidiera únicamente a partir

de temperatura o luminosidad podría detectar condiciones de calor o exposición solar,

pero no sabría si el terreno conserva todavía suficiente agua. Por este motivo, la lógica

de riego debe apoyarse prioritariamente en el estado del sustrato.

Para esta medida se ha utilizado un sensor capacitivo de humedad de suelo. Frente

a sensores resistivos más simples, este tipo de sensor reduce el problema de corrosión

asociado al contacto con humedad, ya que la medida se basa en el cambio capacitivo

del entorno del sensor. Además, proporciona una salida analógica fácil de leer desde

Arduino mediante una entrada ADC. En el prototipo se emplea un módulo capacitivo de

humedad de suelo V1.2 compatible con Arduino, comercializado por AZ-Delivery, cuya

CAPÍTULO 3. METODOS, MATERIALES Y DECISIONES DE DISE ´ | NÕ | 48

documentación lo describe como un sensor analógico de medida capacitiva orientado a

la monitorización de humedad en sustrato [AZ-Delivery, 2026]. La lectura se obtiene

inicialmente como un valor bruto, por lo que no debe interpretarse directamente como

un porcentaje absoluto sin calibración previa.

Esto afecta directamente a la forma de validar la lectura. El sistema puede trabajar

inicialmente con valores raw, pero para una decisión de riego más ajustada será

necesario calibrar el sensor con muestras de suelo seco y suelo húmedo. Durante

las primeras pruebas se comprobó que el valor analógico variaba al modificar las

condiciones de contacto del sensor, lo que permitió validar la respuesta básica de la

lectura antes de plantear una calibración completa en sustrato real.

La temperatura ambiente se incluye como variable de contexto. No permite decidir

por sí sola si hay que regar, pero ayuda a interpretar el comportamiento del suelo.

A igualdad de humedad inicial, un entorno con temperatura elevada puede favorecer

mayor evaporación y acelerar la pérdida de agua. Registrar la temperatura permite

entender mejor la evolución de las medidas y comparar condiciones de prueba distintas.

La humedad relativa aporta información complementaria sobre el ambiente. Una

humedad relativa baja puede estar asociada a mayor demanda evaporativa, mientras

que una humedad relativa elevada puede indicar condiciones en las que la pérdida de

agua por evaporación es menor. En esta primera versión del sistema no se utiliza como

criterio principal de riego, pero sí mejora la interpretación del entorno y puede ser útil

para futuras reglas más completas.

La presión atmosférica se obtiene como dato adicional del sensor ambiental. Su

influencia directa sobre la decisión de riego es menor que la de la humedad del suelo,

la temperatura o la humedad relativa. Sin embargo, al estar disponible en el mismo

sensor, no añade complejidad hardware significativa. En este trabajo se conserva como

dato de contexto y como parte del histórico ambiental registrado.

Para medir temperatura, humedad relativa y presión se ha seleccionado el BME280.

Este componente integra en un único sensor digital la medida de temperatura, humedad

y presión, lo que reduce el número de módulos necesarios y simplifica el cableado. Bosch

Sensortec lo describe como un sensor combinado de humedad, presión y temperatura,

orientado a aplicaciones de bajo consumo y tamaño reducido [Bosch Sensortec, 2024].

En el prototipo se utiliza mediante bus I2C, lo que permite compartir las líneas de

comunicación con otros sensores digitales.

La luminosidad se incorpora como indicador de exposición solar. Aunque no

determina directamente el contenido de agua del suelo, ayuda a contextualizar las

condiciones ambientales. Una zona con mayor exposición solar puede presentar mayor

CAPÍTULO 3. METODOS, MATERIALES Y DECISIONES DE DISE ´ | NÕ | 49

evaporación y calentamiento, mientras que una zona sombreada puede conservar

humedad durante más tiempo. Esta variable resulta útil para interpretar diferencias

entre estaciones o entre distintos momentos del día.

Para esta medida se ha seleccionado el BH1750, integrado habitualmente en módulos

GY-302. Se trata de un sensor digital de luminosidad con interfaz I2C. Su elección se

debe a que entrega directamente medidas en lux, evitando estimar la luminosidad a

partir de una lectura analógica sin escala física clara. La documentación del BH1750FVI

lo describe como un sensor digital de luz ambiente con interfaz I2C y conversión directa

de iluminancia [ROHM Semiconductor, 2011].

Sensor | Variable medida | Justificación de elección
Sensor capacitivo de humedad de suelo V1.2 | Humedad del sustrato mediante lectura analógica. | Variable principal para riego; bajo coste; integración sencilla con Arduino; menor corrosión que sensores resistivos.
BME280 | Temperatura, humedad relativa y presión atmosférica. | Integra tres variables ambientales en un único módulo digital; reduce cableado; comunicación I2C.
BH1750 / GY-302 | Luminosidad ambiente en lux. | Proporciona medida digital de luz; comparte bus I2C; facilita interpretar exposición solar.

Tabla 3.6: Sensores seleccionados para las estaciones de campo

La elección de estos sensores responde también a criterios prácticos. Son módulos

habituales en prototipos con Arduino, tienen bajo coste, disponen de documentación

y librerías accesibles, y permiten validar el sistema sin recurrir a instrumentación

industrial. Además, el uso de I2C para el BME280 y el BH1750 simplifica la integración,

ya que ambos sensores pueden compartir las líneas SDA y SCL del Arduino UNO

siempre que sus direcciones no coincidan.

El detalle de los componentes empleados, las conexiones eléctricas de los sensores,

las pruebas iniciales de lectura y los fragmentos de código utilizados durante la

validación se recoge en los Anexos A, B, C y E. De esta forma, el cuerpo principal

mantiene la justificación técnica de la elección de variables y sensores, mientras

que la información reproducible del montaje queda documentada como material

complementario.

En conjunto, la combinación seleccionada cubre las variables mínimas necesarias

para una primera versión funcional de TierraViva: una variable principal de

decisión, la humedad del suelo, y varias variables ambientales de contexto. En fases

CAPÍTULO 3. METODOS, MATERIALES Y DECISIONES DE DISE ´ | NÕ | 50

posteriores podrían añadirse sensores más avanzados, como caudal, nivel de depósito,

conductividad eléctrica o pH, pero incorporarlos en esta primera versión aumentaría la

complejidad sin ser imprescindible para validar la arquitectura general del sistema.

## 3.7. Elección de plataforma de control local y supervisión

La arquitectura de TierraViva separa claramente dos niveles funcionales. Por un

lado, las estaciones de campo necesitan una plataforma sencilla y cercana al hardware,

capaz de leer sensores, comunicarse con el módulo LTE, aplicar reglas locales de riego

y controlar el relé de la bomba. Por otro lado, el sistema necesita una plataforma

con mayor capacidad software para consultar datos, almacenarlos, exponer una API y

servir el dashboard web. Esta segunda plataforma no actúa como cerebro del riego, sino

como sistema de supervisión e histórico. Esta diferencia de funciones justifica el uso

combinado de Arduino UNO y Raspberry Pi 5, en lugar de concentrar todo el sistema

en una única plataforma.

Arduino UNO se ha seleccionado como plataforma principal de las estaciones

de campo. Se trata de una placa basada en el microcontrolador ATmega328P, con

funcionamiento a 5 V, 14 pines digitales, 6 entradas analógicas, 32 KB de memoria

flash, 2 KB de SRAM y frecuencia de reloj de 16 MHz [Arduino, 2026b]. Aunque sus

prestaciones son limitadas frente a plataformas más modernas, resultan suficientes para

las tareas previstas en la estación: lectura de sensores, gestión de tiempos, comunicación

serie con el módulo A7670E-LASA y control de una salida digital asociada al relé.

Una ventaja importante de Arduino UNO en este proyecto es su sencillez de

integración. La lectura del sensor capacitivo de humedad del suelo puede realizarse

mediante una entrada analógica, mientras que los sensores BME280 y BH1750 pueden

compartir el bus I2C del Arduino. Además, el control del relé requiere únicamente una

salida digital. Esta correspondencia directa entre necesidades del sistema y recursos de

la placa facilita el desarrollo y la depuración del prototipo.

También se ha tenido en cuenta la disponibilidad de documentación, librerías y

ejemplos. En un TFG con integración de varios subsistemas, la plataforma de estación

no debe convertirse en el principal foco de incertidumbre. Arduino UNO permite validar

de forma rápida sensores, salidas digitales, comunicación serie y temporización. Esta

característica ha resultado útil durante las pruebas iniciales, donde se pudo comprobar

primero el funcionamiento básico de la placa, después el bus I2C y finalmente la lectura

integrada de sensores.

CAPÍTULO 3. METODOS, MATERIALES Y DECISIONES DE DISE ´ | NÕ | 51

No obstante, la elección de Arduino UNO implica aceptar limitaciones. La memoria

disponible es reducida, no dispone de sistema operativo, no incorpora conectividad

inalámbrica integrada y su capacidad de procesamiento es limitada. Tampoco es una

plataforma adecuada para ejecutar una base de datos, un servidor web o procesos

software complejos. Por ello, en TierraViva Arduino no se utiliza como controlador

global del sistema, sino como controlador local de estación. Su papel es ejecutar tareas

concretas, repetitivas y cercanas al hardware.

La Raspberry Pi 5 se ha seleccionado como sistema de supervisión del prototipo. A

diferencia de Arduino UNO, Raspberry Pi 5 es un computador de placa reducida capaz

de ejecutar un sistema operativo completo. La documentación oficial la describe con un

procesador Arm Cortex-A76 de cuatro núcleos a 2,4 GHz, lo que la sitúa en un nivel

de capacidad muy superior al de un microcontrolador clásico [Raspberry Pi Ltd, 2026].

En este proyecto, esa capacidad permite ejecutar varios componentes software: lectura

de datos desde la plataforma cloud, almacenamiento en SQLite, API mediante FastAPI

y dashboard web.

Esta elección permite separar las funciones críticas de adquisición y actuación local

de las funciones de supervisión y análisis. La Raspberry Pi no necesita estar conectada

físicamente a las estaciones ni leer directamente los sensores. Su función es actuar

como sistema de supervisión: consulta la información disponible, mantiene un histórico,

expone datos mediante una API y permite visualizar el estado del prototipo. Esta

separación es importante en TierraViva porque las estaciones se plantean como nodos

remotos desplegados en campo, mientras que la Raspberry puede ubicarse en otro lugar

y comunicarse con ellas a través de la plataforma intermedia.

Centralizar todo en Arduino UNO no sería adecuado para el alcance completo del

sistema. Aunque Arduino puede leer sensores y controlar un relé, no está pensado para

mantener una base de datos, servir una interfaz web, ejecutar una API o gestionar

históricos de forma cómoda. Forzar esas funciones en una plataforma tan limitada

aumentaría la complejidad del firmware y reduciría la capacidad de depuración.

Además, mezclar adquisición, comunicación, almacenamiento, visualización y lógica

global en un único microcontrolador haría que el sistema fuera menos modular y más

difícil de mantener.

Tampoco sería conveniente utilizar únicamente Raspberry Pi en las estaciones

de campo. Aunque Raspberry Pi ofrece mucha más potencia, también introduce

un consumo mayor, tiempos de arranque más largos y dependencia de un sistema

operativo. Además, no dispone de entradas analógicas nativas, por lo que la lectura

directa de sensores analógicos requeriría componentes adicionales. Para una estación

CAPÍTULO 3. METODOS, MATERIALES Y DECISIONES DE DISE ´ | NÕ | 52

remota alimentada en campo, que debe leer sensores, controlar un relé y mantener un

estado seguro, un microcontrolador sencillo resulta más apropiado que un computador

completo.

La combinación de ambas plataformas permite asignar a cada una el papel para

el que resulta más adecuada. Arduino UNO se encarga de la interacción directa con

el entorno físico: sensores, módulo de comunicaciones y relé. Raspberry Pi 5 aporta

la capacidad necesaria para almacenar datos, servir una API y ofrecer una interfaz de

supervisión. Esta separación reduce riesgos de integración y facilita validar cada bloque

por separado.

Aspecto | Arduino UNO | Raspberry Pi 5
Rol en TierraViva | Controlador local autónomo de estación de campo. | Sistema de supervisión, almacenamiento y visualización.
Relación con sensores | Lectura directa de sensores analógicos y digitales. | No lee sensores directamente en la arquitectura final.
Actuación | Decisión local y control del relé asociado a la bomba. | No participa en la actuación física ni genera órdenes de riego.
Capacidad software | Firmware sencillo y tareas embebidas. | Sistema operativo, API, base de datos y dashboard.
Consumo y arranque | Menor consumo y arranque inmediato. | Mayor consumo y arranque dependiente del sistema operativo.
Adecuación principal | Nodo de campo sencillo y robusto. | Procesamiento, histórico y supervisión.

Tabla 3.7: Comparación funcional entre Arduino UNO y Raspberry Pi 5 en TierraViva

La Tabla 3.7 resume esta división de responsabilidades. La decisión no se basa en

considerar una plataforma mejor que la otra, sino en asignar cada tarea al dispositivo

más adecuado. En una arquitectura distribuida, esta separación es más importante que

la potencia individual de cada placa.

Durante el diseño también se consideraron alternativas. ESP32, por ejemplo,

incorpora WiFi y Bluetooth, ofrece mayor capacidad de procesamiento que Arduino

UNO y trabaja de forma nativa a 3,3 V. Podría ser una opción interesante en sistemas

IoT donde se quiera integrar conectividad inalámbrica directamente en el nodo. Sin

embargo, en este proyecto la comunicación remota se realiza mediante un módulo LTE

externo, por lo que la conectividad integrada del ESP32 no era imprescindible. Además,

mantener Arduino UNO permitía aprovechar una plataforma ya disponible, conocida

y suficiente para las funciones de estación.

CAPÍTULO 3. METODOS, MATERIALES Y DECISIONES DE DISE ´ | NÕ | 53

Otras alternativas, como STM32 o placas equivalentes, ofrecen más prestaciones y

mayor control sobre periféricos. Sin embargo, también suelen aumentar la complejidad

de configuración, depuración y desarrollo. Para el alcance de este TFG, la prioridad

no era elegir la plataforma embebida más potente, sino una suficientemente fiable y

sencilla para validar la arquitectura completa.

En conjunto, la elección de Arduino UNO y Raspberry Pi 5 responde a

una decisión de diseño modular. Arduino permite construir estaciones de campo

simples, reproducibles y cercanas al hardware. Raspberry Pi 5 aporta la capacidad

necesaria para almacenar datos, servir una API y ofrecer una interfaz de supervisión.

Esta combinación mantiene el equilibrio entre sencillez, coste, capacidad técnica y

adecuación al alcance académico del proyecto.

## 3.8. Selección de solución de comunicaciones para estaciones remotas

La comunicación entre las estaciones de campo y el resto del sistema es una de las

decisiones más importantes de TierraViva. A diferencia de un montaje de laboratorio,

donde los sensores pueden conectarse directamente a un ordenador o a una Raspberry Pi

mediante USB o red local, el escenario planteado requiere estaciones remotas capaces de

enviar datos y estado desde una zona de cultivo sin depender de una red WiFi local ni de

una conexión física con la Raspberry Pi. Por tanto, la solución de comunicaciones debía

ser compatible con un despliegue en campo, funcionar sin depender de una red WiFi

local y permitir la integración con una plataforma de datos externa para supervisión

remota.

Durante la fase inicial del proyecto se valoraron principalmente dos enfoques: una

solución basada en LoRa/LoRaWAN y una solución basada en conectividad móvil

LTE. Ambas alternativas eran técnicamente razonables, pero respondían a prioridades

distintas. LoRa y LoRaWAN resultaban especialmente atractivas por su bajo consumo,

largo alcance y orientación a redes de sensores distribuidas. LTE, en cambio, ofrecía

una integración más directa con servicios en Internet, a cambio de un mayor consumo

energético y de la dependencia de cobertura móvil.

La alternativa LoRa/LoRaWAN encajaba bien con la idea inicial del proyecto. LoRa

es una modulación de largo alcance y bajo consumo diseñada para comunicaciones de

baja tasa de datos, muy adecuada para sensores que envían medidas periódicas y no

necesitan transmitir grandes volúmenes de información [Semtech Corporation, 2015,

Augustin et al., 2016]. En un sistema agrícola, esta característica resulta interesante

CAPÍTULO 3. METODOS, MATERIALES Y DECISIONES DE DISE ´ | NÕ | 54

porque las estaciones suelen transmitir pocos datos: humedad del suelo, temperatura,

humedad relativa, luminosidad, presión atmosférica y estado del actuador. Además, el

enfoque de bajo consumo es coherente con estaciones alimentadas mediante batería o

energía solar.

LoRaWAN añadía una capa de red sobre LoRa, proporcionando una arquitectura

más estructurada para gestionar dispositivos, gateways y servidores de red

[LoRa Alliance, 2020]. Desde el punto de vista académico, esta opción tenía mucho

interés: permitía estudiar una tecnología ampliamente utilizada en IoT, analizar su

arquitectura y plantear un despliegue de nodos de campo con comunicaciones de

largo alcance. También era coherente con escenarios rurales donde no siempre hay

conectividad WiFi y donde interesa cubrir distancias superiores a las habituales en

redes domésticas.

Sin embargo, al trasladar esta alternativa al prototipo real aparecieron dificultades

prácticas importantes. La primera era la necesidad de disponer de infraestructura

adicional. En LoRa punto a punto bastaría con módulos compatibles en las estaciones

y en el receptor, pero se perderían parte de las ventajas de una arquitectura LoRaWAN

completa. En LoRaWAN, por el contrario, sería necesario contar con un gateway,

configurar la red, gestionar la integración con un servidor LoRaWAN y conectar

posteriormente esa información con el sistema de supervisión. Esta infraestructura

aumentaba el alcance del proyecto y desplazaba una parte importante del esfuerzo

hacia la propia red de comunicaciones.

También se detectó un riesgo de integración asociado a la selección de módulos. Para

un despliegue en Europa es necesario trabajar en la banda adecuada, normalmente 868

MHz, y comprobar que los módulos, antenas, placas adaptadoras y niveles lógicos sean

compatibles entre sí. En el caso de Arduino UNO, además, muchos módulos LoRa

trabajan a 3,3 V, mientras que la placa funciona a 5 V, por lo que puede ser necesario

añadir conversores de nivel y una alimentación de 3,3 V suficientemente estable. Estos

detalles no invalidan la solución, pero introducen más puntos de fallo en una fase

del proyecto donde el objetivo principal era validar una arquitectura completa de

monitorización, almacenamiento, visualización y actuación.

Otro aspecto relevante fue la diferencia entre LoRa y LoRaWAN. Aunque a veces

se mencionan juntos, no son equivalentes. LoRa define la capa física, mientras que

LoRaWAN define una arquitectura de red con gateways, servidor de red y mecanismos

de gestión de dispositivos [Adelantado et al., 2017]. Para el proyecto, esta distinción

era importante porque una solución LoRa punto a punto habría sido más sencilla, pero

menos representativa de una red IoT completa; y una solución LoRaWAN habría sido

CAPÍTULO 3. METODOS, MATERIALES Y DECISIONES DE DISE ´ | NÕ | 55

más completa, pero también más costosa en tiempo e infraestructura.

La alternativa basada en LTE se planteó como una forma de reducir ese riesgo

de integración. En lugar de desplegar una infraestructura radio propia, cada estación

utiliza un módulo A7670E-LASA con tarjeta SIM para conectarse directamente a

la red móvil. La comunicación con el exterior se realiza mediante comandos AT y

peticiones HTTP, lo que permite enviar datos a una plataforma cloud sin necesidad de

gateway propio. Esta decisión simplifica la arquitectura de comunicaciones: la estación

no necesita que exista una Raspberry Pi cercana ni una pasarela local en la parcela,

sino únicamente cobertura móvil suficiente y una configuración correcta del APN.

La elección de LTE no elimina las restricciones técnicas. El módulo requiere una

alimentación más exigente que una solución LoRa, especialmente por los picos de

corriente durante el registro en red o la transmisión de datos. Además, el sistema pasa

a depender de la cobertura del operador móvil, de la disponibilidad de una tarjeta SIM

y del acceso a Internet. Estas limitaciones son relevantes y deben tenerse en cuenta en

el diseño energético y en el modo seguro de funcionamiento. Si la estación no puede

comunicar, el sistema no debe quedar en un estado peligroso ni mantener el riego activo

de forma indefinida.

Aun así, para el alcance concreto del TFG, LTE ofrecía una ventaja decisiva:

permitía validar antes el ciclo completo de publicación y supervisión. Las estaciones

podían leer sensores, enviar telemetría mediante HTTP, integrarse con ThingSpeak y

dejar sus datos disponibles para que la Raspberry Pi los consultara posteriormente.

Esto encaja con la arquitectura final de TierraViva, en la que la Raspberry Pi no está

conectada físicamente a las estaciones ni decide el riego, sino que actúa como sistema

de supervisión e histórico. La comunicación entre estaciones y sistema de supervisión,

por tanto, no se resuelve mediante USB, puerto serie o red local, sino mediante la

publicación y consulta de datos a través de Internet y de la plataforma intermedia.

La Tabla 3.8 resume los criterios principales considerados en la decisión.

CAPÍTULO 3. METODOS, MATERIALES Y DECISIONES DE DISE ´ | NÕ | 56
Criterio | LoRa/LoRaWAN | LTE con A7670E-LASA
Alcance | Muy adecuado para largas distancias con baja tasa de datos. | Depende de la cobertura de red móvil disponible.
Consumo | Bajo consumo, especialmente en envíos periódicos. | Mayor consumo y picos de corriente durante transmisión.
Infraestructura | Puede requerir gateway, servidor LoRaWAN o receptor propio. | No requiere gateway propio; usa red móvil existente.
Integración cloud | Necesita pasarela o backend intermedio. | Integración directa mediante HTTP.
Complejidad inicial | Mayor si se despliega LoRaWAN completo. | Menor para validar telemetría HTTP.
Coste operativo | Sin SIM ni tarifa de datos si la red es propia. | Requiere tarjeta SIM y servicio de datos.
Riesgo para el TFG | Riesgo de consumir mucho tiempo en la red. | Riesgo menor para obtener un prototipo funcional completo.
Adecuación al prototipo | Muy interesante como línea futura o alternativa avanzada. | Adecuada para validar el sistema completo en el alcance actual.

Tabla 3.8: Comparación entre LoRa/LoRaWAN y LTE para TierraViva

La decisión final fue utilizar LTE con el módulo A7670E-LASA. Esta elección

no implica que LoRa/LoRaWAN sea una alternativa peor desde el punto de vista

tecnológico. De hecho, para una versión futura orientada a bajo consumo y despliegue en

parcelas sin cobertura móvil, LoRa o LoRaWAN podrían ser opciones muy adecuadas.

La decisión se basa en el contexto del proyecto: se buscaba una solución funcional,

verificable y defendible dentro del tiempo disponible, priorizando la integración

completa del sistema frente al desarrollo de una infraestructura de comunicaciones

propia.

La validación preliminar del módulo LTE reforzó esta decisión. Antes de integrarlo

con Arduino, el A7670E-LASA se probó mediante comandos AT desde un ordenador.

Las pruebas permitieron comprobar que el módulo respondía correctamente, reconocía

la SIM, obtenía señal, se registraba en red LTE, disponía de dirección IP y podía

realizar peticiones HTTP. Estos resultados no sustituyen a las pruebas de integración

completas, que se desarrollan más adelante, pero sí permitieron confirmar que la vía

LTE era viable para el prototipo.

En términos de diseño, la consecuencia principal de esta elección es que ThingSpeak

se convierte en una capa intermedia de comunicación. Las estaciones publican su

telemetría y estado mediante HTTP, y la Raspberry Pi consulta esos datos desde la

CAPÍTULO 3. METODOS, MATERIALES Y DECISIONES DE DISE ´ | NÕ | 57

nube para almacenarlos, visualizarlos y supervisar el funcionamiento del prototipo. La

decisión de riego no depende de un flujo descendente de órdenes, sino de reglas locales

ejecutadas en cada estación. Este enfoque reduce la dependencia de la conectividad

externa para la actuación física y reserva la comunicación remota para telemetría,

estado, histórico y supervisión.

Por tanto, la solución LTE adoptada responde a un criterio de ingeniería

pragmático. LoRa/LoRaWAN se estudió por su adecuación a IoT agrícola, bajo

consumo y largo alcance, pero se descartó como solución principal por el riesgo

de aumentar demasiado la complejidad de comunicaciones. LTE con A7670E-LASA

permite centrar el esfuerzo en el objetivo global de TierraViva: construir un prototipo

capaz de medir, comunicar, almacenar, visualizar y actuar de forma segura mediante

decisión local en las estaciones.

## 3.9. Elección de plataforma cloud: ThingSpeak

La elección de la plataforma cloud se ha realizado teniendo en cuenta el papel que

debía desempeñar dentro de TierraViva. En este proyecto, la nube no se utiliza como un

elemento añadido únicamente para representar gráficas, sino como una capa intermedia

entre las estaciones de campo y el sistema de supervisión. Las estaciones deben poder

enviar telemetría desde una ubicación remota mediante LTE y la Raspberry Pi debe

poder consultar esos datos sin estar conectada físicamente a ellas. En la arquitectura

final, esta capa no se utiliza para enviar órdenes de riego, sino para publicar telemetría,

estado de relé y códigos de funcionamiento generados por las propias estaciones.

En el capítulo anterior se describieron varias alternativas de plataformas cloud

para IoT, como Ubidots, Adafruit IO, Blynk, ThingsBoard o soluciones basadas en

un broker MQTT propio. Todas ellas podrían ser válidas en determinados escenarios,

pero no ofrecen el mismo equilibrio entre sencillez, control, coste, curva de aprendizaje

y facilidad de integración con un prototipo académico. En este TFG no se buscaba

desplegar una infraestructura cloud compleja, sino disponer de una plataforma

suficientemente fiable y accesible para validar el ciclo completo de monitorización y

control.

Una alternativa posible habría sido utilizar un broker MQTT accesible desde

Internet. Esta opción resulta atractiva desde el punto de vista técnico, ya que MQTT

está diseñado para comunicaciones IoT y permite un modelo de publicación/suscripción

más adecuado para sistemas con múltiples nodos. Sin embargo, en el caso concreto

de TierraViva habría implicado añadir un servidor o servicio externo, configurar

CAPÍTULO 3. METODOS, MATERIALES Y DECISIONES DE DISE ´ | NÕ | 58

autenticación, gestionar reconexiones y adaptar la comunicación del módulo LTE a

ese esquema. Para un prototipo cuyo objetivo principal es validar una arquitectura

completa, esta complejidad adicional no aportaba una mejora proporcional.

También se consideraron plataformas más completas, como ThingsBoard, que

ofrecen más posibilidades de gestión de dispositivos, reglas, visualización y

escalabilidad. No obstante, precisamente por ser más completas, requieren una

configuración inicial mayor. En una solución industrial o en un despliegue con muchos

dispositivos, esta inversión puede estar justificada. En TierraViva, donde el número de

estaciones es reducido y la prioridad es demostrar el funcionamiento extremo a extremo,

una plataforma más ligera resulta más adecuada.

ThingSpeak se ha seleccionado porque proporciona una estructura sencilla basada

en canales y campos, una API HTTP fácil de utilizar desde dispositivos embebidos

y herramientas básicas de visualización. Según la documentación de MathWorks,

ThingSpeak permite escribir datos en canales mediante llamadas HTTP de la

API REST, además de otros métodos como MQTT o funciones de MATLAB

[MathWorks, 2026b, MathWorks, 2026c]. Esta característica encaja especialmente bien

con el módulo A7670E-LASA, ya que el envío de datos puede implementarse mediante

comandos AT y peticiones HTTP, sin necesidad de incorporar una pila de comunicación

más compleja en el firmware de Arduino.

El concepto de canal resulta especialmente útil para organizar la información del

sistema. Cada canal puede agrupar varias variables relacionadas mediante campos

numerados. En TierraViva, este modelo permite representar de forma clara las

medidas y estados de una estación: humedad del suelo, temperatura, humedad relativa,

luminosidad, presión atmosférica, estado del relé, código de estado o evento y un campo

auxiliar reservado para depuración o ampliaciones. De esta forma, cada publicación de

telemetría queda almacenada como una entrada temporal asociada a un conjunto de

campos.

CAPÍTULO 3. METODOS, MATERIALES Y DECISIONES DE DISE ´ | NÕ | 59
Elemento en ThingSpeak | Uso en TierraViva | Motivo de utilización
Canal TierraViva A | Registro de telemetría y estado de la estación A. | Permite separar los datos de la estación A y consultar su histórico de forma independiente.
Canal TierraViva B | Registro de telemetría y estado de la estación B. | Permite separar los datos de la estación B y facilita el crecimiento a varias zonas monitorizadas.
Field 1 | Humedad del suelo normalizada ( %). | Valor calculado por el firmware a partir de la lectura bruta del sensor capacitivo y utilizado como variable principal para la decisión local de riego.
Field 2 | Temperatura ambiente. | Variable de contexto para interpretar las condiciones del entorno.
Field 3 | Humedad relativa ambiente. | Variable ambiental útil para contextualizar evaporación y condiciones de humedad.
Field 4 | Luminosidad. | Permite interpretar exposición solar y condiciones de luz.
Field 5 | Presión atmosférica. | Dato ambiental adicional proporcionado por el sensor BME280.
Field 6 | Estado del relé, 0 apagado y 1 activo. | Permite supervisar si la estación está actuando sobre el riego.
Field 7 | Modo seguro. | Indica si la estación se encuentra en modo seguro: 0 para funcionamiento normal y 1 para modo seguro activo.
Field 8 | Código de estado. | Código numérico publicado por la estación para indicar el resultado del ciclo de funcionamiento o una incidencia detectada.
API HTTP | Escritura de telemetría desde las estaciones y lectura desde Raspberry Pi. | Reduce la complejidad de integración frente a soluciones que requieren infraestructura propia.

Tabla 3.9: Uso previsto de ThingSpeak dentro de TierraViva

La Tabla 3.9 resume el papel de ThingSpeak en la arquitectura. La separación por

canales de estación evita mezclar los datos de distintas zonas monitorizadas y permite

CAPÍTULO 3. METODOS, MATERIALES Y DECISIONES DE DISE ´ | NÕ | 60

que la Raspberry Pi consulte de forma independiente la telemetría y el estado de cada

nodo. Esta decisión mejora la trazabilidad del sistema y facilita la depuración, ya que se

puede comprobar por separado si cada estación está enviando medidas correctamente,

si publica su estado operativo y si se han registrado eventos de riego o incidencias.

En la estructura actual se utilizan canales diferenciados para cada estación:

TierraViva A y TierraViva B. Durante el diseño se valoró utilizar ThingSpeak también

como mecanismo de control descendente, pero esa opción se descartó al desplazar la

decisión de riego al firmware de cada estación. De este modo, la plataforma queda

reservada para telemetría y estado, y se evita que una entrada antigua en la nube

pueda condicionar una actuación física.

Otra razón importante para elegir ThingSpeak es la facilidad de lectura desde

la Raspberry Pi. La Raspberry Pi puede consultar los últimos datos publicados

mediante peticiones HTTP y recibir la información en formato estructurado. La

documentación de MathWorks permite leer datos de un canal mediante la API y

obtener respuestas en formatos como JSON o CSV [MathWorks, 2026a]. Esto encaja

con la arquitectura software planteada para la Raspberry, donde los datos recibidos se

almacenan posteriormente en SQLite y se presentan mediante una API y un dashboard

propios.

ThingSpeak también permite mantener una primera visualización de los datos

directamente en la plataforma. Aunque el dashboard final de TierraViva se desarrolla

en la Raspberry Pi, las gráficas de ThingSpeak resultan útiles durante la fase de

pruebas, porque permiten comprobar rápidamente si los datos están llegando a la nube

antes de integrarlos en el resto del sistema. Durante las pruebas, disponer de esa doble

visualización ayuda a acotar el fallo: si una lectura aparece en ThingSpeak pero no en el

dashboard local, el problema estará probablemente en la lectura desde la Raspberry o

en el almacenamiento; si no aparece en ThingSpeak, el fallo estará antes, en la estación,

en el módulo LTE o en la petición HTTP.

La plataforma también presenta limitaciones que deben asumirse. ThingSpeak no

se comporta como un sistema de tiempo real estricto. El envío y la consulta de datos

se basan en peticiones y en intervalos de actualización, por lo que existe una latencia

asociada. En la arquitectura final de TierraViva esta limitación no compromete la

actuación sobre el riego, ya que la decisión crítica se ejecuta localmente en la estación

y no depende de recibir una instrucción externa de riego.

En el caso de TierraViva, la latencia de ThingSpeak es aceptable porque su papel

principal es registrar telemetría, estado y eventos para supervisión posterior. El riego

no requiere que la Raspberry responda en milisegundos, sino que la estación aplique

CAPÍTULO 3. METODOS, MATERIALES Y DECISIONES DE DISE ´ | NÕ | 61

reglas verificables, limite el tiempo de bomba activa y publique información suficiente

para reconstruir lo ocurrido. Por ello, resulta más importante diseñar correctamente el

firmware local y los códigos de estado que reducir al mínimo la latencia de consulta

desde la Raspberry Pi.

La elección de ThingSpeak, por tanto, responde a un criterio de equilibrio. No

es la plataforma más completa ni la más flexible para un despliegue industrial, pero

sí es adecuada para un prototipo académico donde se necesita integrar sensores,

LTE, almacenamiento remoto, consulta desde Raspberry Pi y supervisión de estados

publicados por estaciones autónomas. Su principal ventaja es que permite validar

la arquitectura completa sin desplazar el esfuerzo hacia el mantenimiento de una

infraestructura cloud propia.

En conjunto, ThingSpeak actúa como punto de desacoplo entre las estaciones y

la Raspberry Pi. Las estaciones no necesitan conocer la ubicación de la Raspberry ni

mantener una conexión directa con ella; publican telemetría, estado del relé y códigos de

evento en la nube. La Raspberry, por su parte, consulta esa información para construir

el histórico, alimentar la API y servir el dashboard, sin intervenir en la decisión local de

riego. Esta separación es coherente con el objetivo de TierraViva: construir un sistema

modular, verificable y preparado para funcionar con estaciones remotas autónomas.

La estructura concreta de canales utilizada en TierraViva se desarrolla con mayor

detalle en el Capítulo 4, donde se documentan los canales TierraViva A y TierraViva B,

así como la codificación de los campos empleados para telemetría, estado y eventos.

3.10. | Elección | de | arquitectura | software | de

## supervisión en Raspberry Pi

La Raspberry Pi se ha seleccionado como sistema de supervisión software de

TierraViva. Su función no es sustituir a las estaciones de campo, leer directamente los

sensores ni decidir la activación de la bomba, sino consultar la información publicada

por las estaciones, registrar un histórico local y ofrecer una interfaz de consulta. Esta

separación resulta importante porque las estaciones se encuentran en campo y se

comunican de forma remota, mientras que la Raspberry actúa como nodo de supervisión

e histórico.

Durante el desarrollo se implementó primero un prototipo local basado en MQTT,

SQLite, FastAPI y un dashboard web. Esta fase previa permitió validar la cadena

software sin depender todavía de la comunicación LTE ni de la plataforma cloud final.

En ese prototipo, los datos llegaban a la Raspberry, se publicaban en un broker MQTT

CAPÍTULO 3. METODOS, MATERIALES Y DECISIONES DE DISE ´ | NÕ | 62

local, eran procesados por un backend en Python, se almacenaban en SQLite y se

exponían mediante una API para que el dashboard pudiera consultarlos.

Este prototipo local no representa la arquitectura final de comunicación con las

estaciones remotas, pero sí tuvo un papel importante dentro del proceso de desarrollo.

Permitió comprobar ante el tutor que la Raspberry Pi podía recibir telemetría,

almacenarla, servirla mediante una API y mostrarla en una interfaz web. El código de

esta fase se conserva en el repositorio del proyecto dentro del directorio de prototipos,

dejando explícito que se trata de una validación previa y no del sistema final basado

en LTE y ThingSpeak [Tejedor de la Cruz, 2026].

El uso de MQTT en esta fase se justificó por su sencillez para desacoplar

productores y consumidores de información. Un proceso podía publicar lecturas de

sensores y otro proceso podía escucharlas sin necesidad de una conexión directa entre

ambos. Sin embargo, al definir la arquitectura final con estaciones remotas conectadas

mediante LTE y ThingSpeak, el broker MQTT local dejó de ser el mecanismo

principal de comunicación con las estaciones. Mantener MQTT como solución remota

habría requerido desplegar o contratar un broker accesible desde Internet, gestionar

autenticación, reconexiones y suscripciones desde el módulo LTE, aumentando la

complejidad del prototipo. Por este motivo, MQTT se conserva como parte del

prototipo local previo y como experiencia de validación, pero no como núcleo de la

comunicación final entre Raspberry y estaciones.

El almacenamiento local se ha planteado mediante SQLite. SQLite es adecuado para

este proyecto porque permite disponer de una base de datos ligera, autocontenida y sin

necesidad de desplegar un servidor de base de datos independiente. La documentación

oficial lo describe como un motor SQL pequeño, rápido y autocontenido, integrado

directamente en la aplicación [SQLite, 2026]. Para TierraViva, esto permite guardar

lecturas, estados y eventos de riego en la propia Raspberry Pi, manteniendo un histórico

independiente de la plataforma cloud.

Esta independencia respecto a la nube tiene valor técnico. ThingSpeak almacena

la telemetría recibida y facilita su consulta, pero no debe ser el único punto donde

se conserve la información del sistema. Al replicar los datos relevantes en SQLite,

la Raspberry puede mantener un histórico propio, adaptar el modelo de datos a las

necesidades del proyecto y registrar incidencias de supervisión, como periodos sin datos,

campos ausentes o cambios inesperados en el estado de una estación. De esta forma, el

sistema de supervisión no se limita a visualizar datos externos, sino que construye su

propio registro operativo.

La API se ha desarrollado con FastAPI. Esta herramienta permite construir

CAPÍTULO 3. METODOS, MATERIALES Y DECISIONES DE DISE ´ | NÕ | 63

servicios web en Python de forma sencilla, utilizando rutas HTTP para exponer los

datos que necesita el dashboard. La documentación oficial presenta FastAPI como un

framework moderno para construir APIs con Python a partir de anotaciones de tipo

estándar [FastAPI, 2026]. En el proyecto, su papel es servir como capa intermedia

entre la base de datos y la interfaz web: consulta SQLite, transforma los registros en

una respuesta estructurada y permite que el dashboard obtenga las últimas lecturas

mediante peticiones HTTP.

En las pruebas realizadas, la API se ejecutó mediante Uvicorn, un servidor ASGI

para aplicaciones Python [Uvicorn, 2026]. Esta decisión separa la definición de la

aplicación, implementada en FastAPI, del proceso que la sirve por red. Desde el punto

de vista del prototipo, esto facilita probar la API desde un navegador o desde otro

equipo de la misma red, comprobar los endpoints disponibles y depurar de forma

independiente la parte de visualización.

El dashboard web constituye la capa de presentación. Su objetivo es mostrar al

usuario el estado del sistema sin obligarle a consultar manualmente la base de datos,

revisar mensajes de consola o interpretar directamente las respuestas de ThingSpeak.

En una primera versión, el dashboard se centró en mostrar las últimas lecturas

almacenadas. Posteriormente, se amplió para incluir variables como humedad de

suelo, luminosidad y presión, además de temperatura y humedad ambiental. Esta

evolución permitió acercar la interfaz a las necesidades reales del sistema, no solo a

una demostración mínima de comunicación.

La arquitectura software de la Raspberry se organiza, por tanto, en varias capas

diferenciadas: lectura de datos desde la plataforma cloud, almacenamiento local,

API y dashboard. Esta separación evita que toda la lógica quede mezclada en un

único programa. También facilita las pruebas: se puede comprobar por separado si

ThingSpeak entrega datos, si SQLite almacena correctamente, si la API devuelve la

información esperada y si el dashboard representa bien el estado del sistema.

CAPÍTULO 3. METODOS, MATERIALES Y DECISIONES DE DISE ´ | NÕ | 64
Bloque software | Función en TierraViva | Motivo de elección
Prototipo MQTT local | Validación inicial de recepción y tratamiento de datos en Raspberry. | Permite documentar una fase previa de desarrollo y separar prototipos de la arquitectura final.
Ingesta desde ThingSpeak | Consulta periódica de telemetría y estado publicados por las estaciones. | Permite alimentar el histórico local y el dashboard sin conexión directa con los nodos de campo.
SQLite | Almacenamiento local de lecturas, estados e incidencias. | Base de datos ligera, autocontenida y suficiente para el prototipo.
FastAPI | Exposición de datos mediante endpoints HTTP. | Facilita crear una API sencilla entre la base de datos y el dashboard.
Dashboard web | Visualización de medidas, histórico, estado del relé y estado de las estaciones. | Permite supervisar el prototipo sin acceder a consola o consultas SQL.

Tabla 3.10: Bloques principales de la arquitectura software de supervisión en Raspberry Pi

La lógica de decisión de riego no se mantiene en la Raspberry Pi en la arquitectura

final. Aunque este dispositivo tiene capacidad suficiente para comparar estaciones o

aplicar reglas más complejas, se ha decidido desplazar la decisión crítica al nodo de

campo. Esta elección reduce la dependencia de la red, elimina la necesidad de enviar

comandos remotos y permite que cada estación mantenga un comportamiento seguro

aunque la Raspberry no esté disponible.

La Raspberry conserva un papel relevante dentro del sistema, pero orientado a

supervisión. Puede detectar si una estación deja de publicar datos, mostrar el último

estado conocido del relé, conservar históricos y facilitar el análisis posterior de las

pruebas. De esta forma, el sistema mantiene trazabilidad sin convertir la supervisión

en un requisito para que el riego pueda ejecutarse.

Una ventaja adicional de mantener un histórico local es la posibilidad de analizar

el comportamiento del sistema más allá de la última lectura recibida. El histórico

permite revisar tendencias, detectar periodos sin comunicación, comparar estaciones

y documentar pruebas. También deja preparada la arquitectura para futuras mejoras,

como reglas más avanzadas, detección de anomalías o modelos predictivos basados

en datos acumulados. En esta versión del TFG, estas posibilidades no se presentan

como inteligencia artificial implementada de forma completa, sino como una evolución

razonable cuando exista un volumen suficiente de datos fiables.

CAPÍTULO 3. METODOS, MATERIALES Y DECISIONES DE DISE ´ | NÕ | 65

Con esta organización, la Raspberry Pi mantiene un papel claro dentro del sistema:

no controla físicamente el riego, pero sí convierte los datos publicados por las estaciones

en información consultable y persistente. SQLite evita desplegar una base de datos

pesada, FastAPI proporciona una API clara y el dashboard facilita la supervisión. El

prototipo local con MQTT permitió validar esta cadena software en una fase temprana,

mientras que la arquitectura final utiliza ThingSpeak como capa intermedia con las

estaciones remotas. De esta forma, la Raspberry queda definida como sistema de

supervisión: consulta, registra y expone información, mientras que la decisión y la

ejecución segura de la actuación permanecen en la estación de campo.

## 3.11. Materiales empleados

La selección de materiales se ha realizado buscando un equilibrio entre

funcionalidad, coste, disponibilidad y facilidad de integración. Al tratarse de un

prototipo de TFG, no se han empleado componentes industriales cerrados, sino

módulos habituales en sistemas IoT y prototipos electrónicos que permiten validar

la arquitectura de forma progresiva y reproducible.

Los materiales empleados no deben entenderse como una simple lista de compra,

sino como el conjunto de bloques físicos necesarios para que TierraViva pueda medir,

comunicar, almacenar, visualizar y actuar sobre el riego. Cada componente cumple una

función concreta dentro de la arquitectura y se ha seleccionado en coherencia con los

requisitos definidos anteriormente.

En la Tabla 3.11 se resumen los principales materiales utilizados o previstos en el

prototipo.

CAPÍTULO 3. METODOS, MATERIALES Y DECISIONES DE DISE ´ | NÕ | 66
Componente | Función | Justificación
Sensórica
Sensor capacitivo de humedad de suelo | Medición de humedad del sustrato mediante lectura analógica. | Variable principal para la decisión de riego; menor degradación que sensores resistivos.
BME280 | Medición de temperatura, humedad relativa y presión atmosférica. | Sensor ambiental integrado; reduce el número de módulos y simplifica el cableado.
BH1750 / GY-302 | Medición de luminosidad ambiente. | Medida digital en lux mediante I2C; útil para interpretar exposición solar.

Control y procesamiento
Arduino UNO | Adquisición de datos y control local de la estación. | Plataforma sencilla, disponible, documentada y suficiente para lectura de sensores y control de relé.
Raspberry Pi 5 | Backend de supervisión, histórico local, API y dashboard. | Mayor capacidad software para ejecutar servicios, almacenar datos y visualizar el sistema.

Comunicación
A7670E-LASA | Conectividad LTE de la estación. | Permite envío HTTP mediante red móvil sin necesidad de gateway propio.
Tarjeta SIM de datos | Acceso a red móvil para el módulo LTE. | Necesaria para publicar telemetría y estado desde las estaciones.

Actuación
Relé + bomba de agua 12
V
Activación | física
del riego durante un tiempo controlado.

Permite cerrar el ciclo de monitorización y control, manteniendo
la bomba apagada como
estado seguro.
Alimentación y montaje
Alimentación 12 V + LM2596 (regulador) | Alimentación principal y adaptación de tensión a 5 V. | Permite alimentar la bomba y regular la tensión para Arduino, sensores y módulos compatibles.
Cableado, protoboard, conectores, resistencias y condensadores | Interconexión, adaptación eléctrica y estabilización del prototipo. | Facilitan pruebas, depuración, adaptación de niveles y reducción de inestabilidades en la alimentación.

Tabla 3.11: Resumen de materiales principales empleados en TierraViva

El bloque de sensórica está formado por tres tipos de sensores. El sensor capacitivo

CAPÍTULO 3. METODOS, MATERIALES Y DECISIONES DE DISE ´ | NÕ | 67

de humedad de suelo se utiliza como entrada principal para la decisión de riego, ya

que proporciona información directa sobre el estado del sustrato. El BME280 permite

obtener temperatura, humedad relativa y presión atmosférica en un único módulo,

aportando contexto ambiental sin aumentar demasiado la complejidad del montaje.

Por último, el BH1750 mide la luminosidad ambiente en lux, lo que permite interpretar

mejor la exposición solar de la zona monitorizada.

La elección de Arduino UNO como plataforma de estación responde a una decisión

de simplicidad y control local. La estación necesita leer sensores, comunicarse con el

módulo LTE y accionar un relé, pero no ejecutar una base de datos ni servir una

interfaz web. Para esas tareas, Arduino UNO resulta suficiente y facilita la depuración

del prototipo. Además, permite trabajar de forma directa con entradas analógicas, bus

I2C y salidas digitales.

El módulo A7670E-LASA se incorpora como solución de comunicación remota

mediante red móvil. Su función es permitir que cada estación publique telemetría

y estado en la plataforma cloud. Esta elección evita desplegar un gateway propio y

permite integrar la estación con servicios externos mediante peticiones HTTP, aunque

introduce dependencia de cobertura móvil, tarjeta SIM y una alimentación adecuada

para los picos de consumo del módulo.

La Raspberry Pi 5 se utiliza como sistema de supervisión software. A diferencia

de Arduino, su papel no es interactuar directamente con los sensores ni accionar la

bomba mediante pines físicos, sino consultar datos, almacenarlos, exponer una API y

servir el dashboard. Esta separación permite mantener una arquitectura distribuida:

las estaciones trabajan en campo y la Raspberry actúa como nodo de supervisión e

histórico.

El bloque de actuación está formado por un módulo relé y una bomba de agua

de 12 V. La bomba se controla desde la estación de campo, no desde la Raspberry

Pi de forma directa. Esta decisión es importante porque el actuador debe encontrarse

físicamente en el lugar donde se realiza el riego. La decisión y ejecución segura de la

actuación corresponde al firmware de la estación, que aplica reglas locales y mantiene

la bomba apagada ante cualquier estado no verificable.

La alimentación se plantea a partir de una fuente o batería de 12 V, ya que la bomba

requiere una tensión superior a la utilizada por la lógica de control. Para alimentar

Arduino y los módulos compatibles se emplea un regulador LM2596 ajustado a 5 V.

Esta separación entre alimentación de potencia y alimentación lógica permite integrar

el actuador sin comprometer la estabilidad del resto de la electrónica, siempre que se

mantenga una masa común y se verifiquen las tensiones antes de conectar los módulos.

CAPÍTULO 3. METODOS, MATERIALES Y DECISIONES DE DISE ´ | NÕ | 68

También se consideran materiales auxiliares como cableado Dupont (sin soldadura),

protoboard, conectores, resistencias y condensadores. Aunque puedan parecer

componentes secundarios, son relevantes durante la fase de prototipado porque

permiten modificar conexiones, aislar fallos, adaptar niveles eléctricos y estabilizar

la alimentación de los módulos. En particular, la adaptación de nivel entre Arduino

y el módulo LTE debe cuidarse para evitar aplicar señales de 5 V a entradas que

trabajen a niveles inferiores. Del mismo modo, el uso de condensadores de desacoplo y

estabilización ayuda a reducir caídas puntuales de tensión y comportamientos erráticos

asociados a módulos con consumo variable, como el A7670E-LASA o el bloque de

actuación.

Con estos materiales se puede construir una arquitectura completa sin recurrir a

equipos industriales de alto coste. El detalle completo de componentes, referencias

comerciales, conexiones eléctricas y estado de validación se recoge en los Anexos A y

B.
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
