ltejedorcruz/TierraViva/memoria/figs/alimentacion_12v.jpg

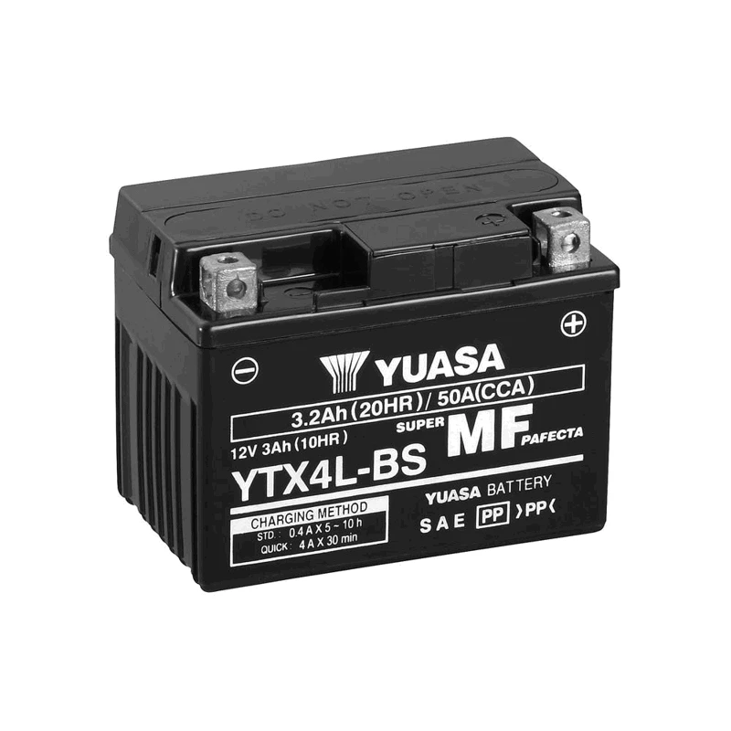
memoria/figs/alimentacion_12v.jpg
