ltejedorcruz/TierraViva/memoria/figs/arduino_uno.jpg

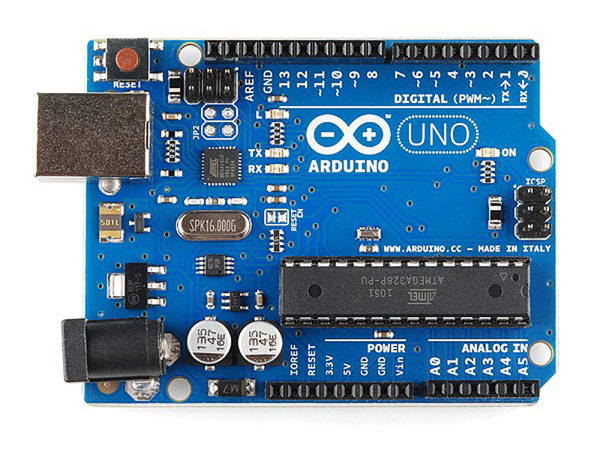
memoria/figs/arduino_uno.jpg
