ltejedorcruz/TierraViva/memoria/figs/arq_final_tv.png

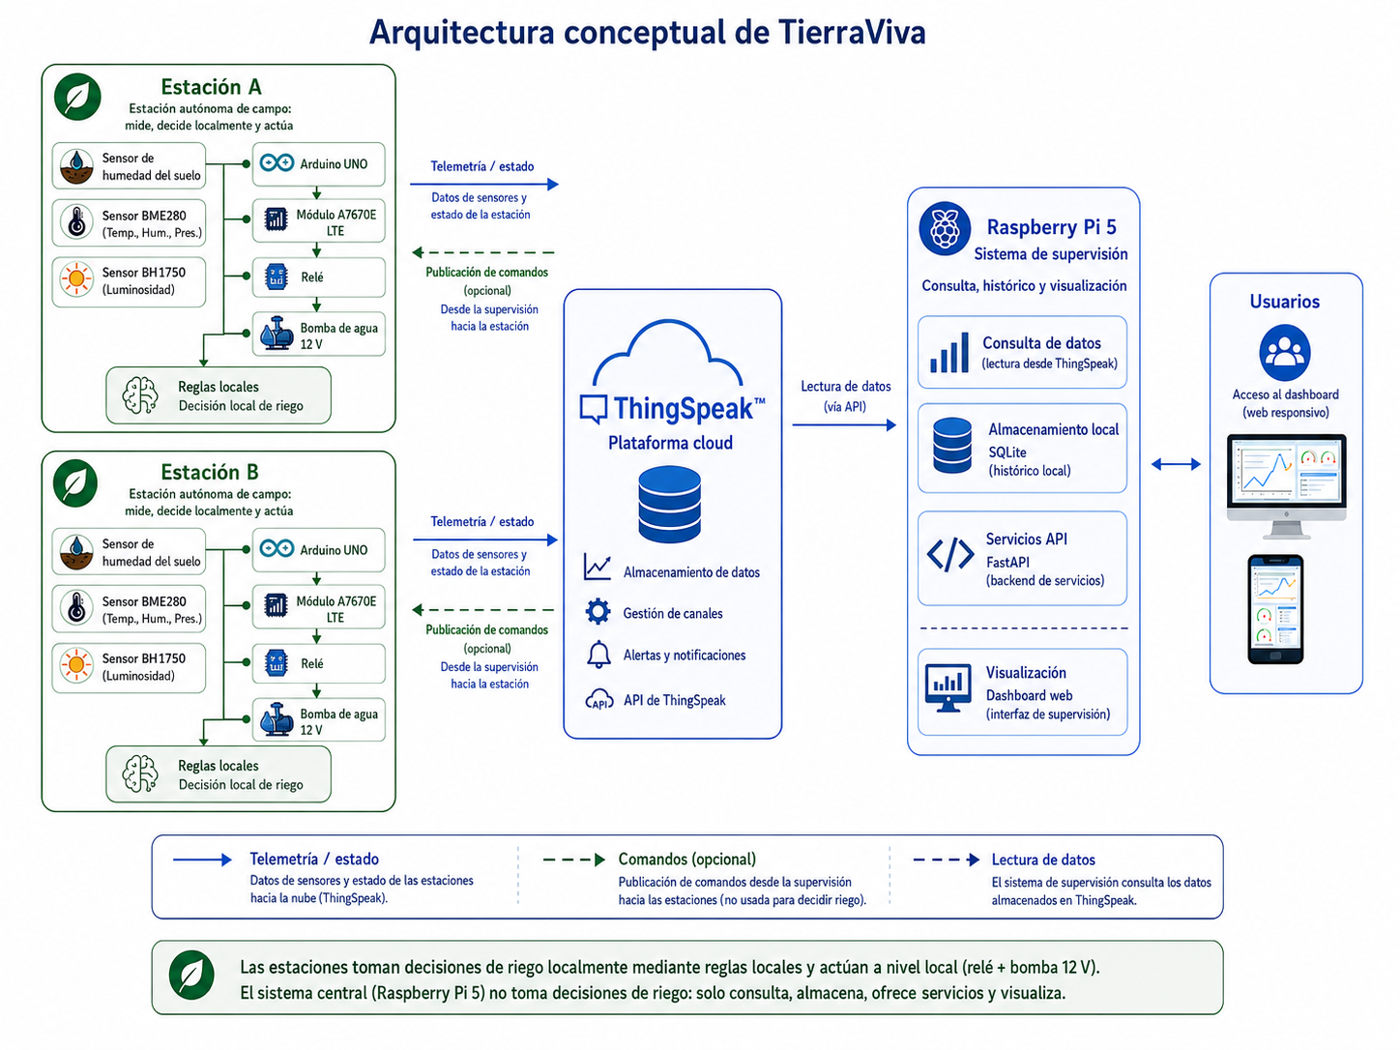
memoria/figs/arq_final_tv.png
