ltejedorcruz/TierraViva/memoria/figs/Arquitectura_TV.png

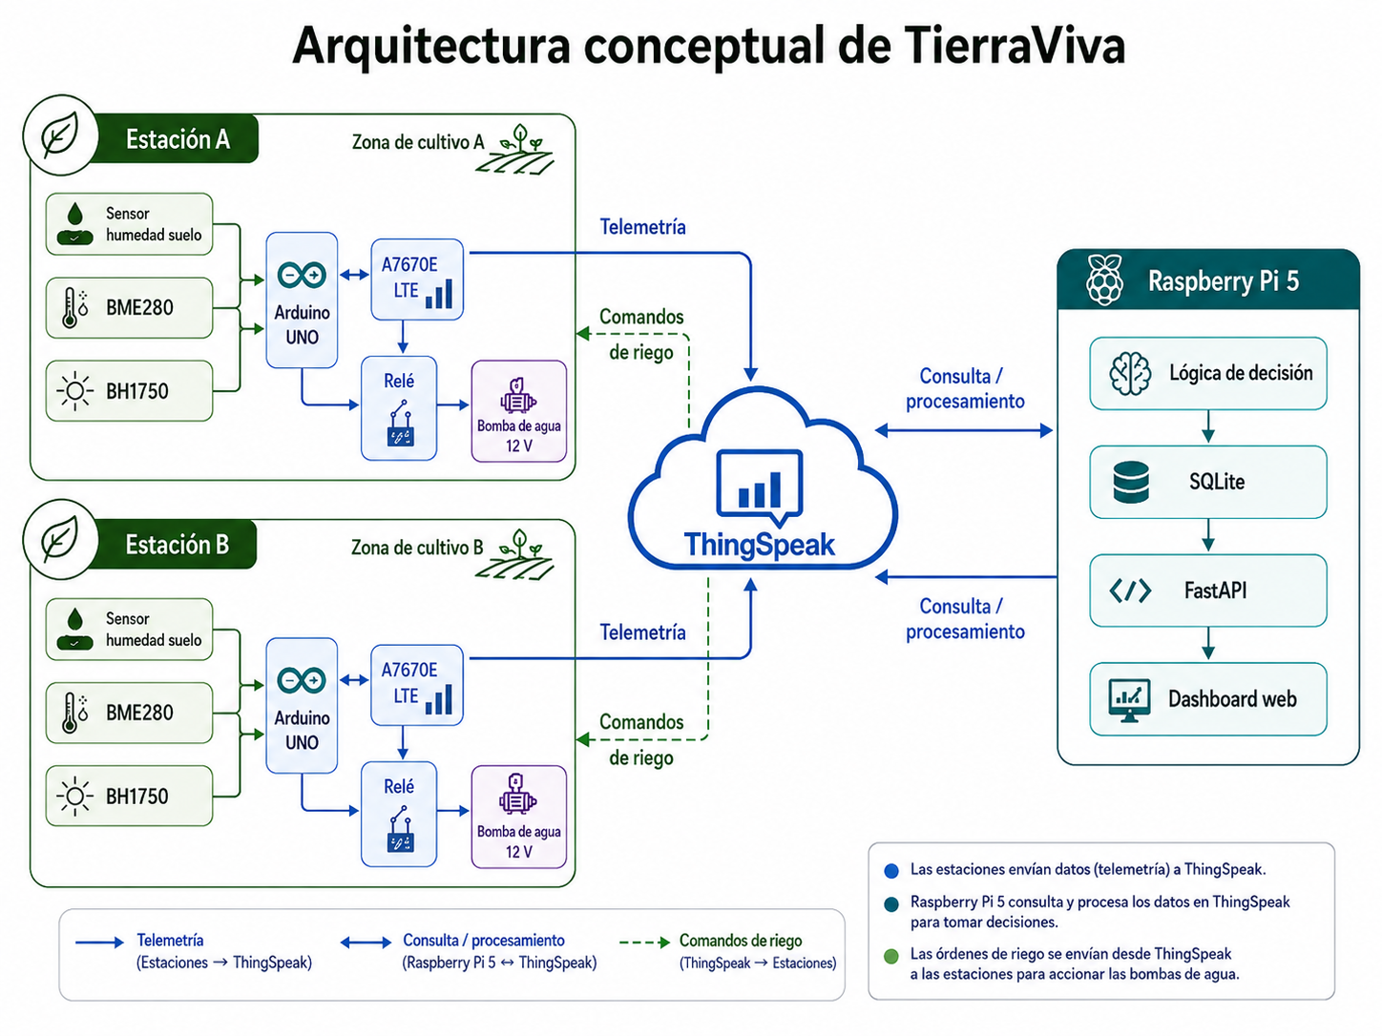
memoria/figs/Arquitectura_TV.png
