ltejedorcruz/TierraViva/memoria/figs/arquitecturaFinalTierraViva.png

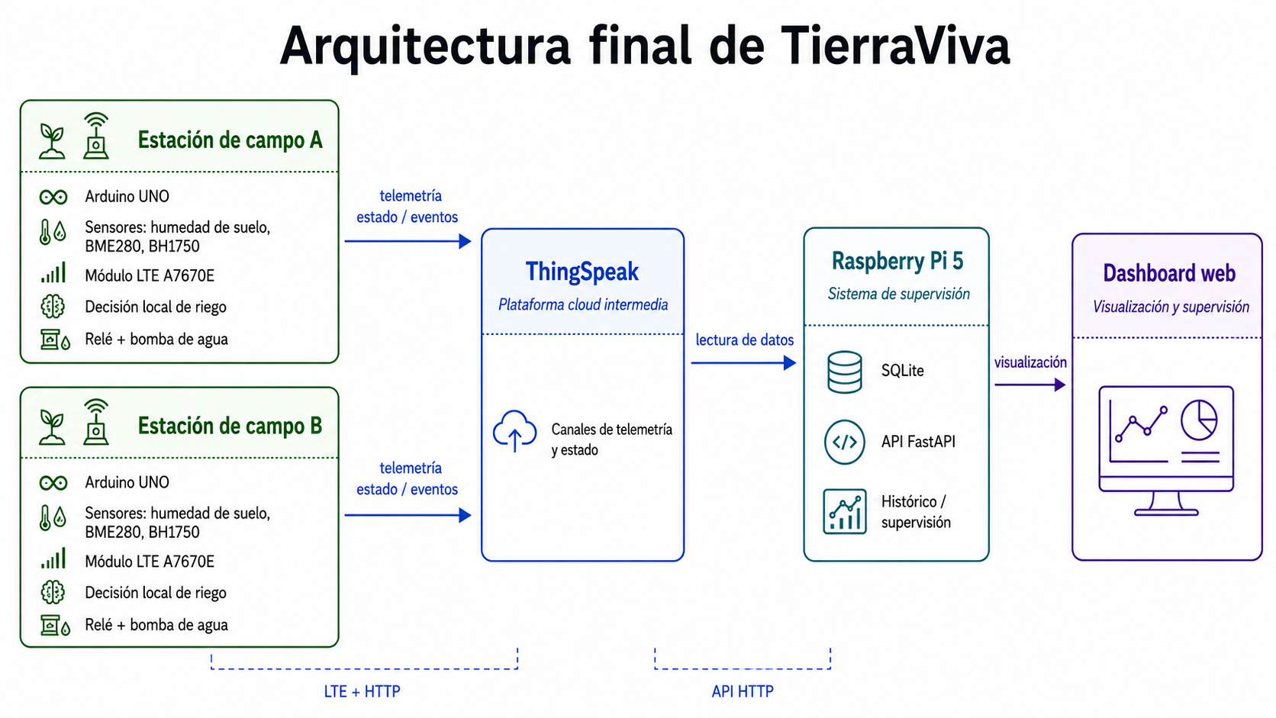
memoria/figs/arquitecturaFinalTierraViva.png
