ltejedorcruz/TierraViva/memoria/figs/arquitecturaFinalTierraViva_antigua.png

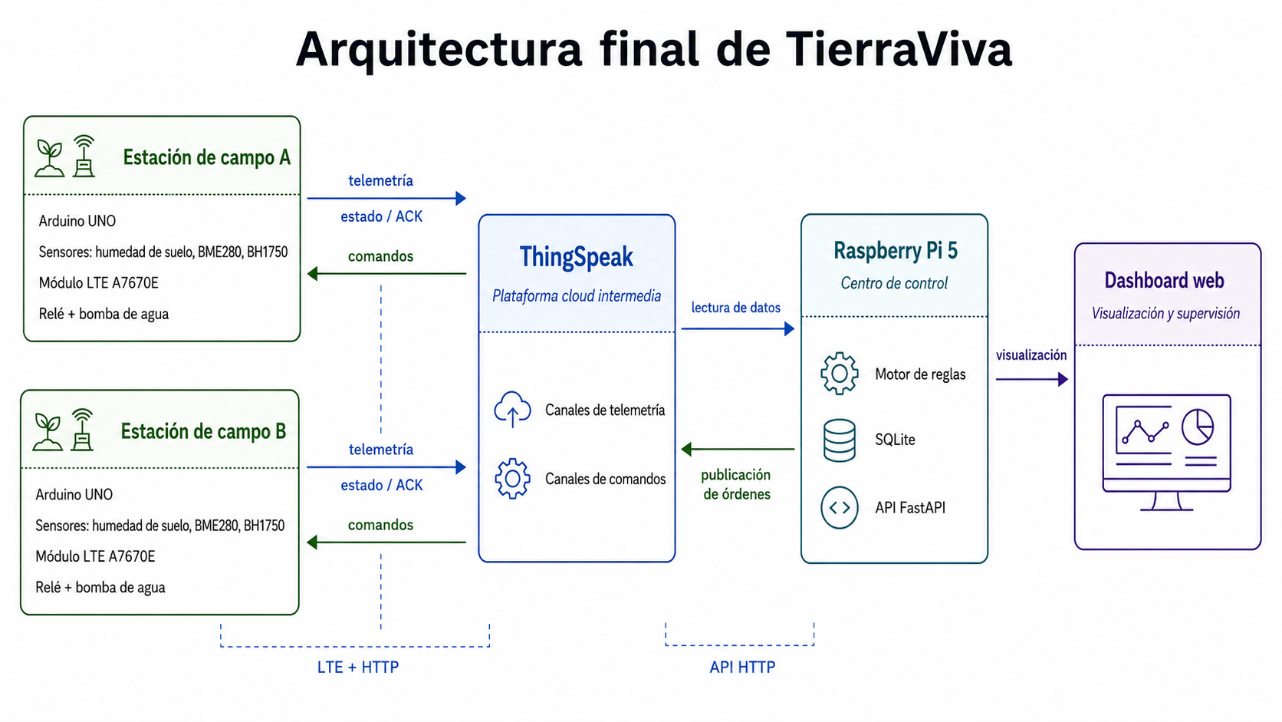
memoria/figs/arquitecturaFinalTierraViva_antigua.png
