ltejedorcruz/TierraViva/memoria/figs/arquitecturaTierraViva_anr.jpeg

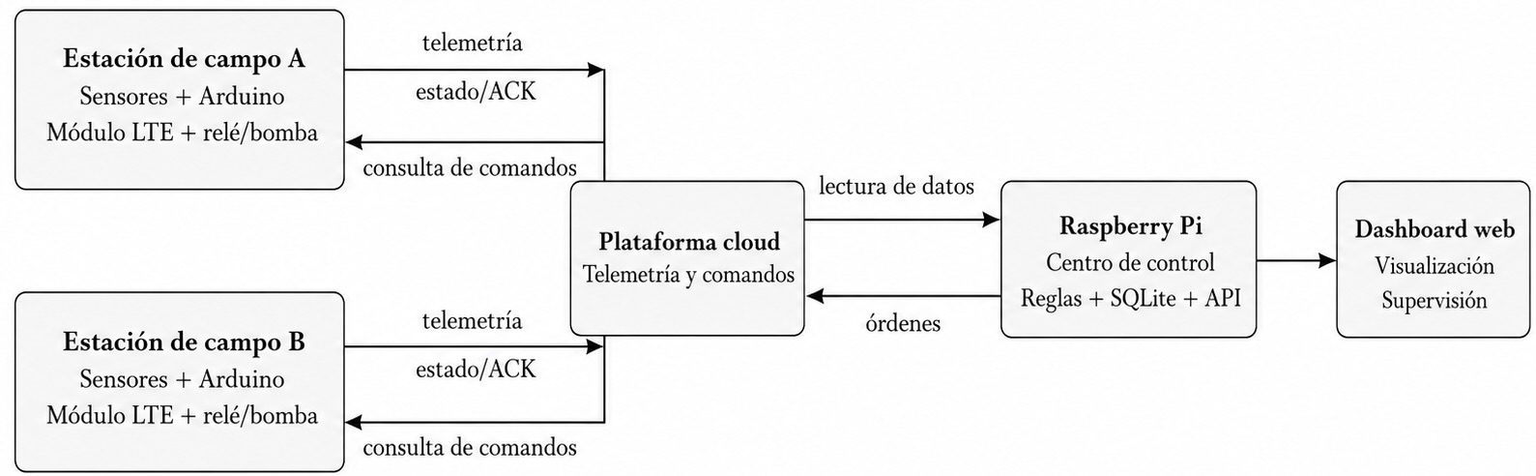
memoria/figs/arquitecturaTierraViva_anr.jpeg
