ltejedorcruz/TierraViva/memoria/figs/bh1750_gy302.jpg

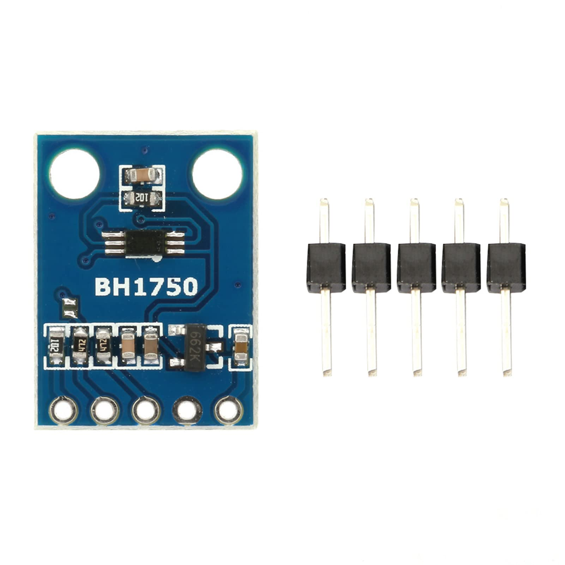
memoria/figs/bh1750_gy302.jpg
