ltejedorcruz/TierraViva/memoria/figs/bomba12v.jpg

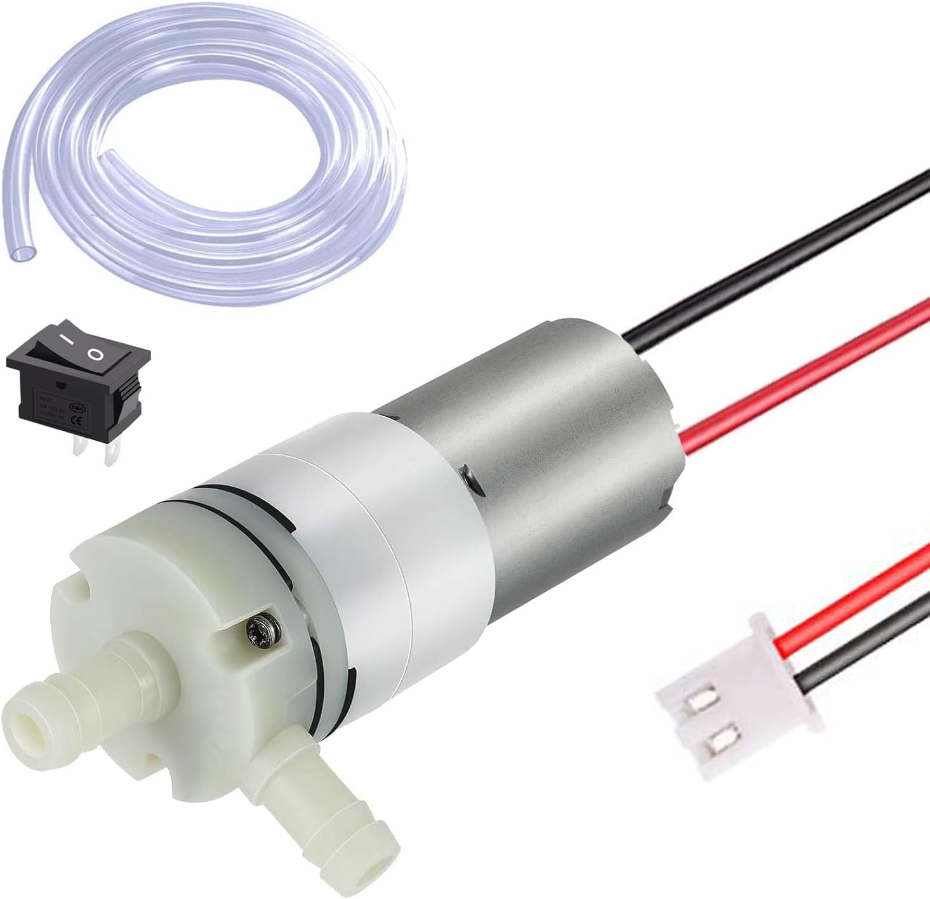
memoria/figs/bomba12v.jpg
