ltejedorcruz/TierraViva/memoria/figs/cables.jpg

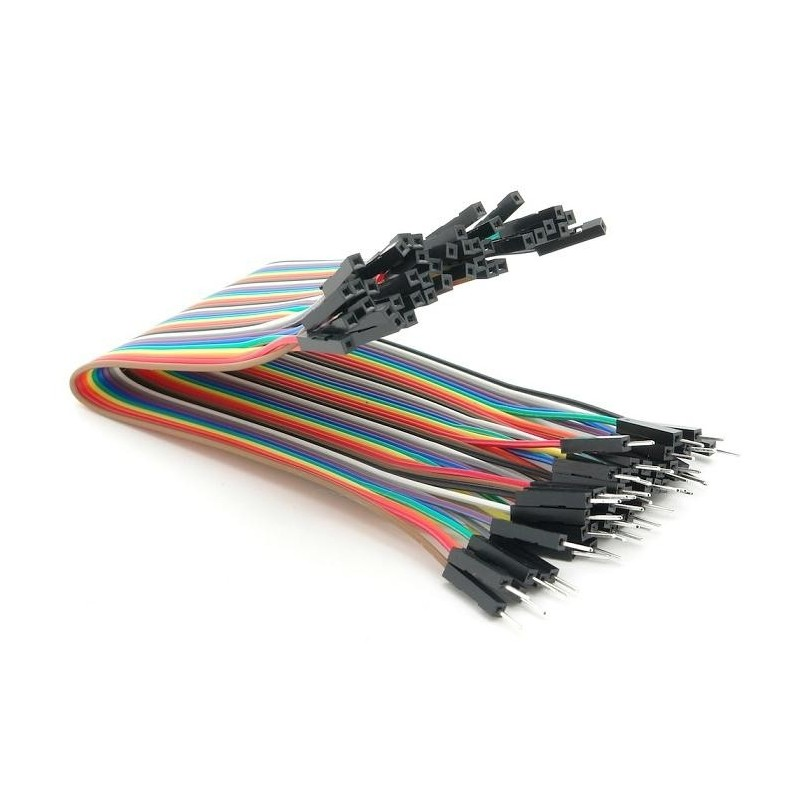
memoria/figs/cables.jpg
