ltejedorcruz/TierraViva/memoria/figs/esquema_estacion_TierraViva.png

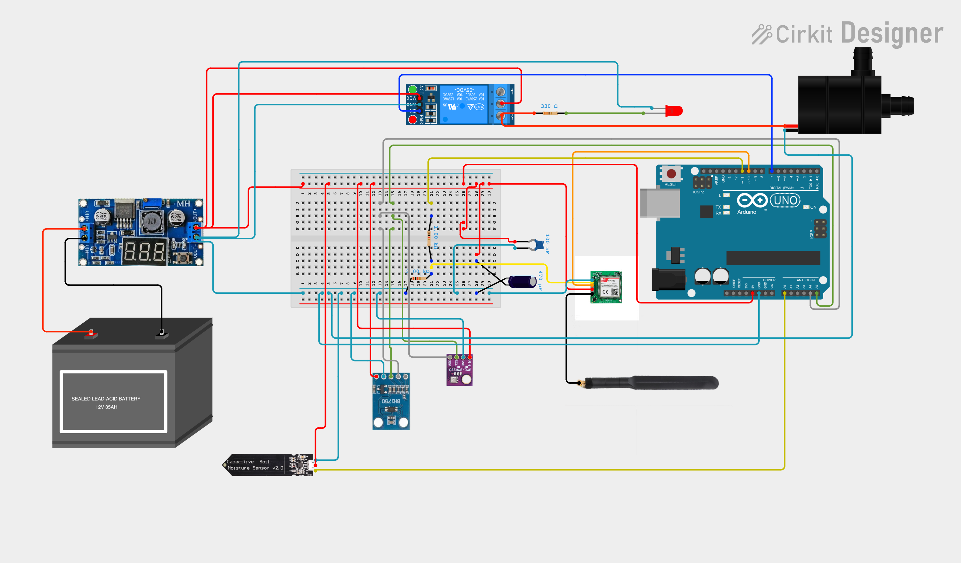
memoria/figs/esquema_estacion_TierraViva.png
