ltejedorcruz/TierraViva/memoria/figs/fig_cap1_01_riego_rutina_vs_datos.jpeg

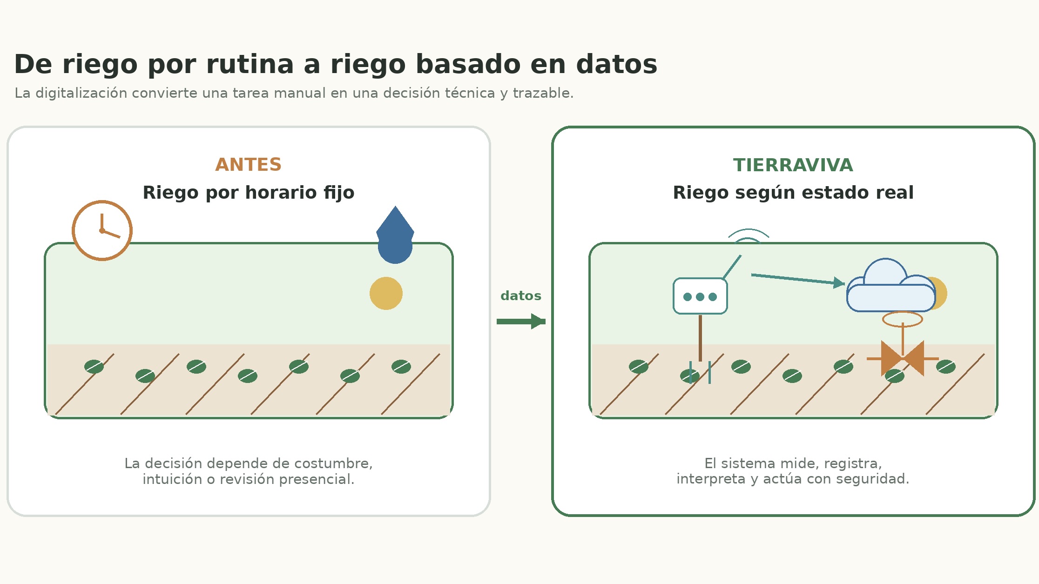
memoria/figs/fig_cap1_01_riego_rutina_vs_datos.jpeg
