ltejedorcruz/TierraViva/memoria/figs/fig_cap1_02_arquitectura_conceptual.jpeg

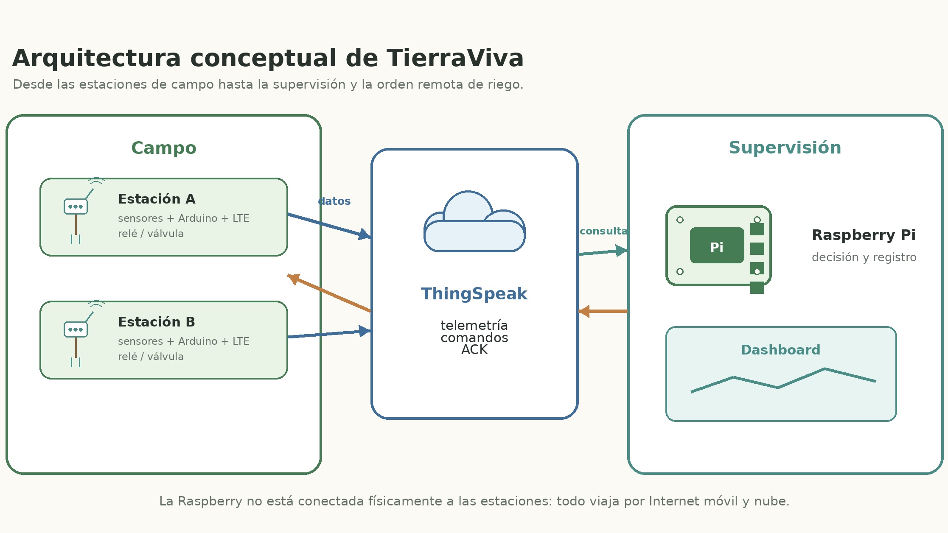
memoria/figs/fig_cap1_02_arquitectura_conceptual.jpeg
