ltejedorcruz/TierraViva/memoria/figs/fig_cap1_03_decision_riego_defendible.jpeg

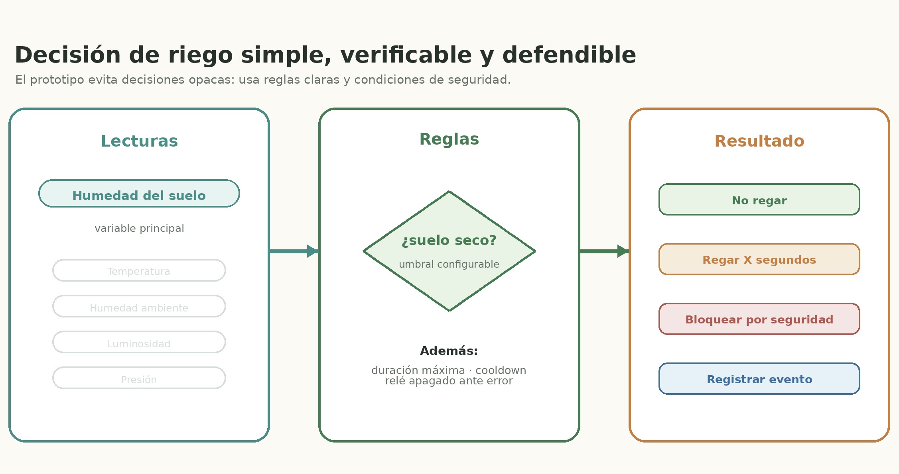
memoria/figs/fig_cap1_03_decision_riego_defendible.jpeg
