ltejedorcruz/TierraViva/memoria/figs/fig_cap1_04_reto_integracion.jpeg

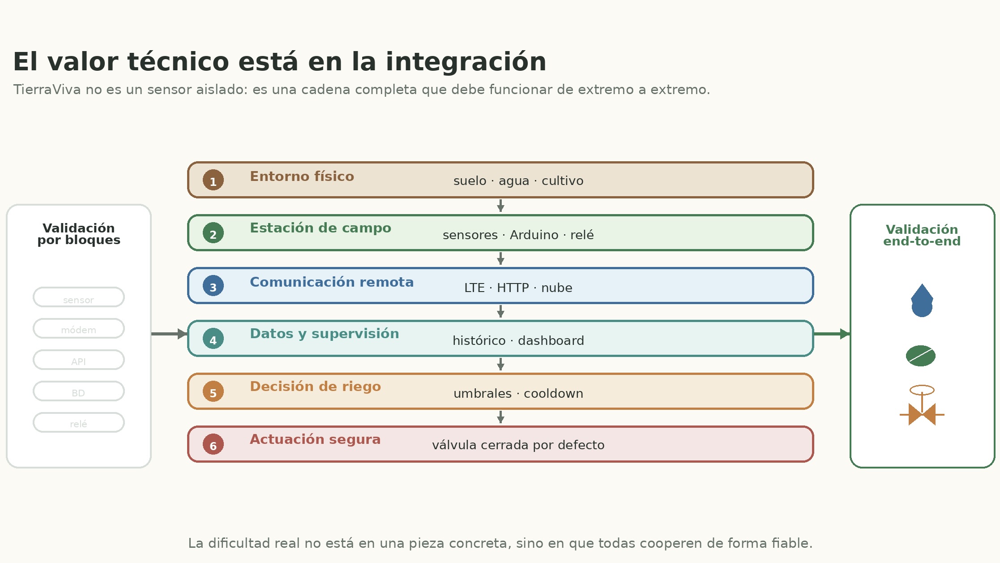
memoria/figs/fig_cap1_04_reto_integracion.jpeg
