ltejedorcruz/TierraViva/memoria/figs/fig_cap1_05_alcance_honesto.jpeg

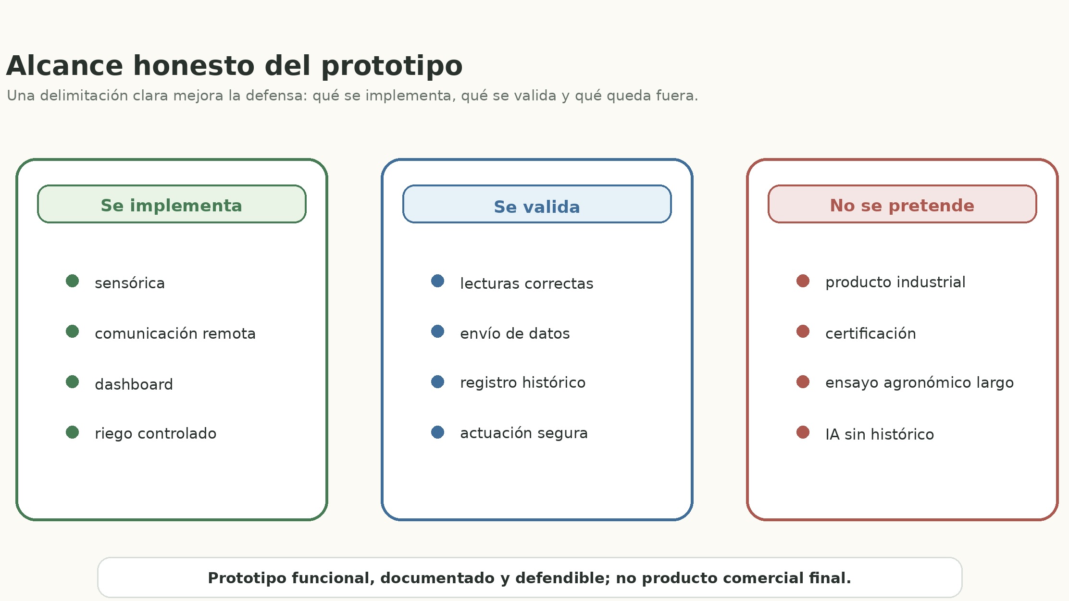
memoria/figs/fig_cap1_05_alcance_honesto.jpeg
