ltejedorcruz/TierraViva/memoria/figs/figura_2_4_sensores_actuadores.png

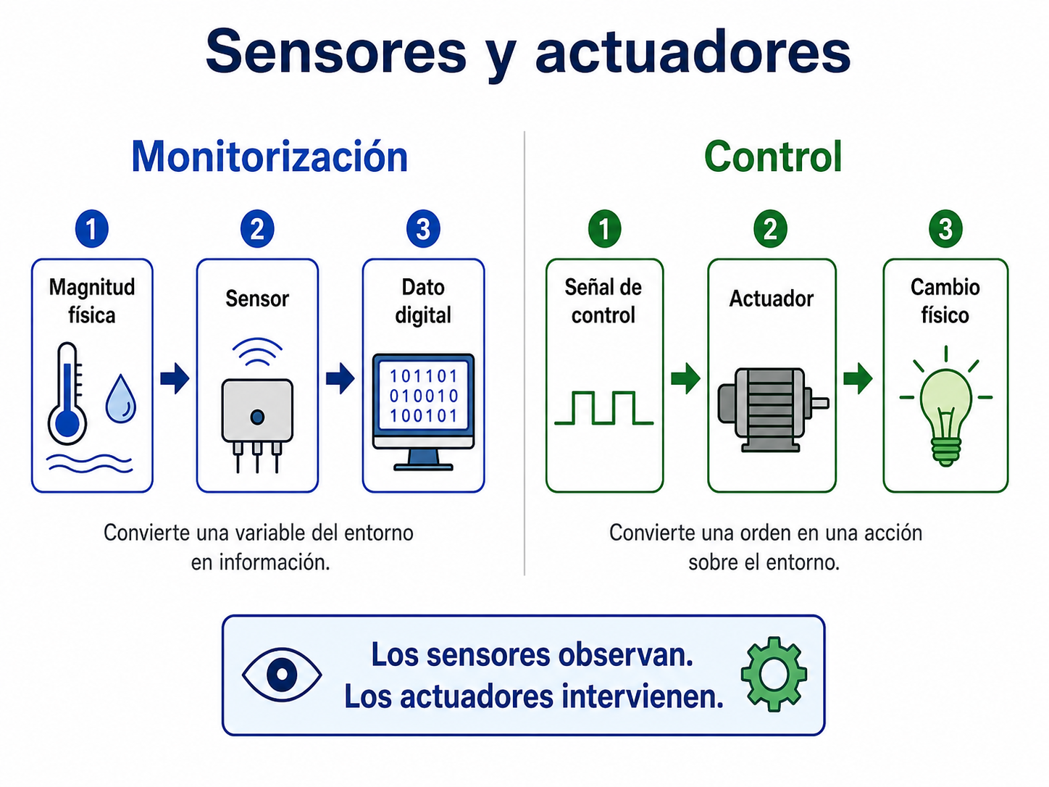
memoria/figs/figura_2_4_sensores_actuadores.png
