ltejedorcruz/TierraViva/memoria/figs/figura_2_5_criterios_comunicacion_iot.png

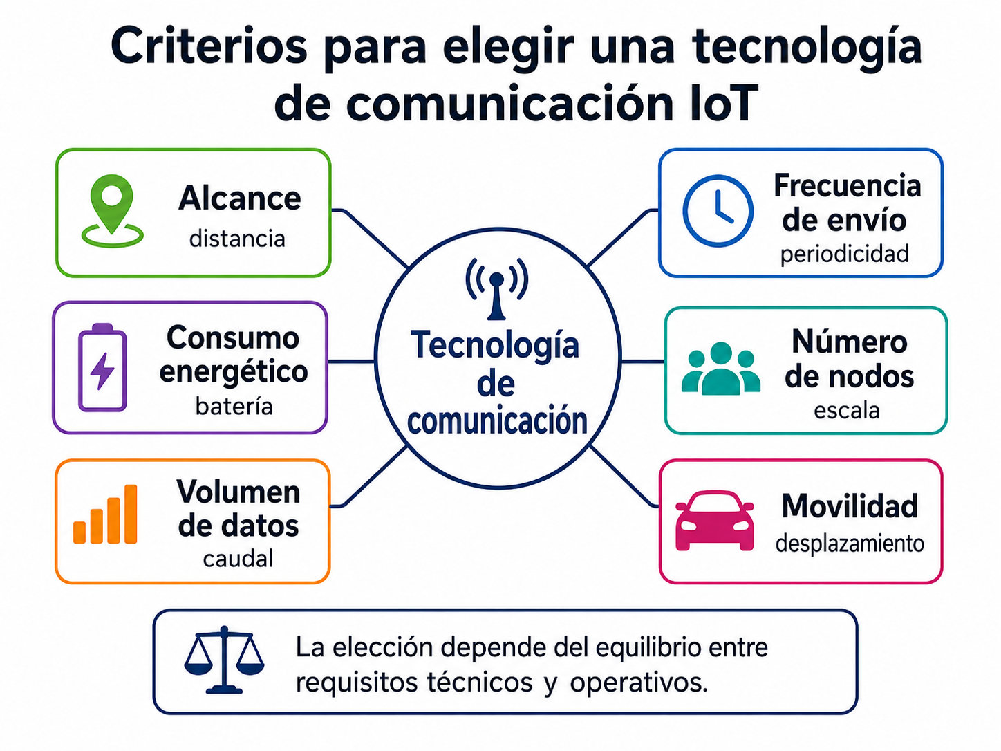
memoria/figs/figura_2_5_criterios_comunicacion_iot.png
