ltejedorcruz/TierraViva/memoria/figs/figura_2_6_edge_fog_cloud.png

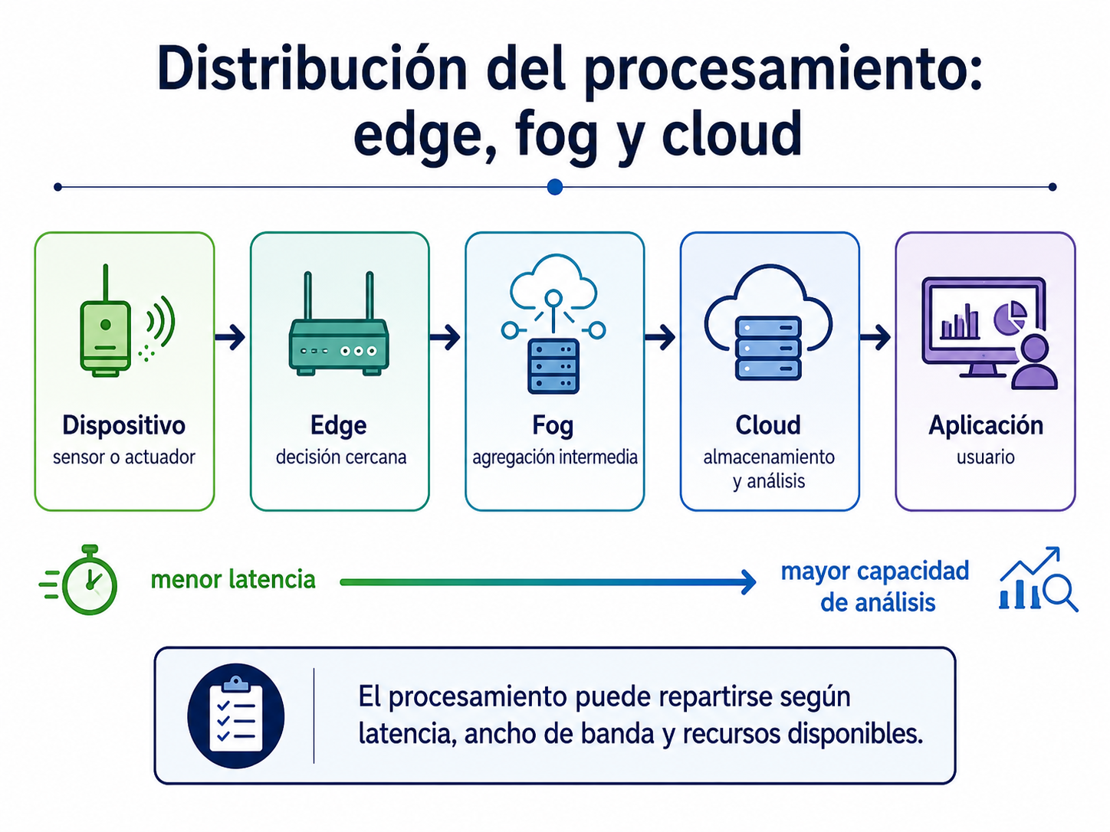
memoria/figs/figura_2_6_edge_fog_cloud.png
