ltejedorcruz/TierraViva/memoria/figs/figura_3_1_requisitos_funcionales.png

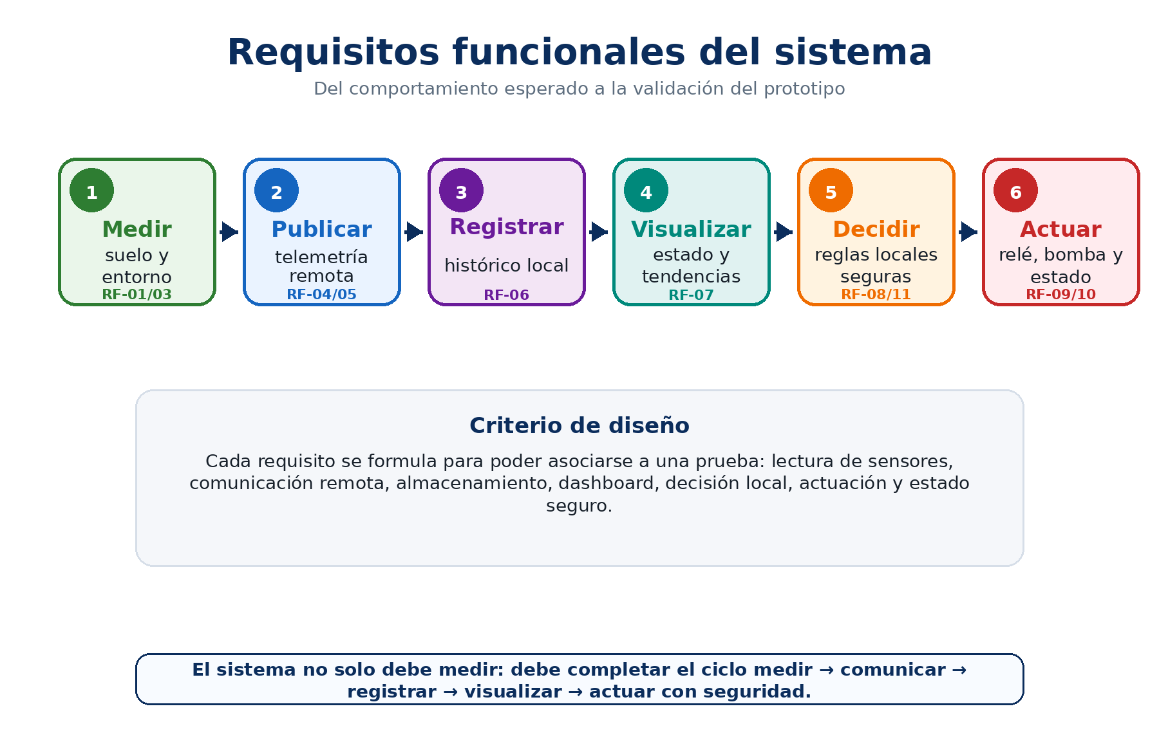
memoria/figs/figura_3_1_requisitos_funcionales.png
