ltejedorcruz/TierraViva/memoria/figs/figura_3_2_requisitos_no_funcionales.png

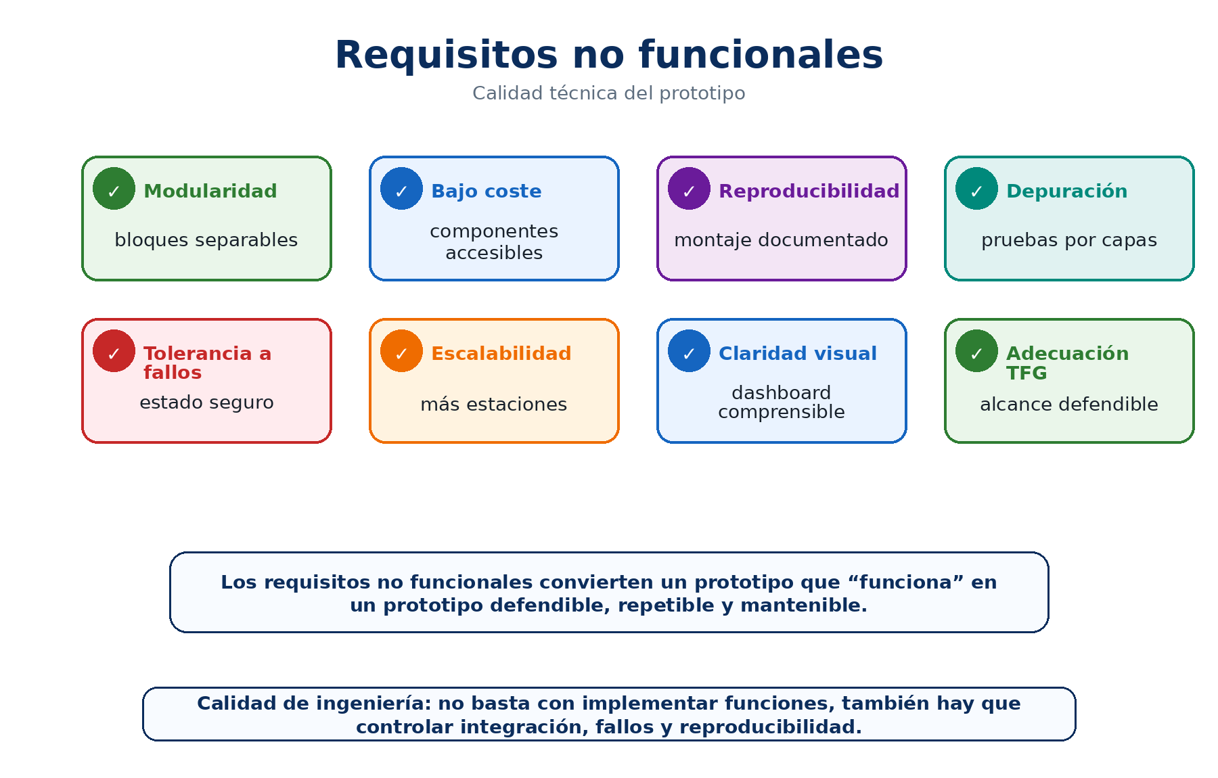
memoria/figs/figura_3_2_requisitos_no_funcionales.png
