ltejedorcruz/TierraViva/memoria/figs/figura_3_3_especificaciones_temporales.png

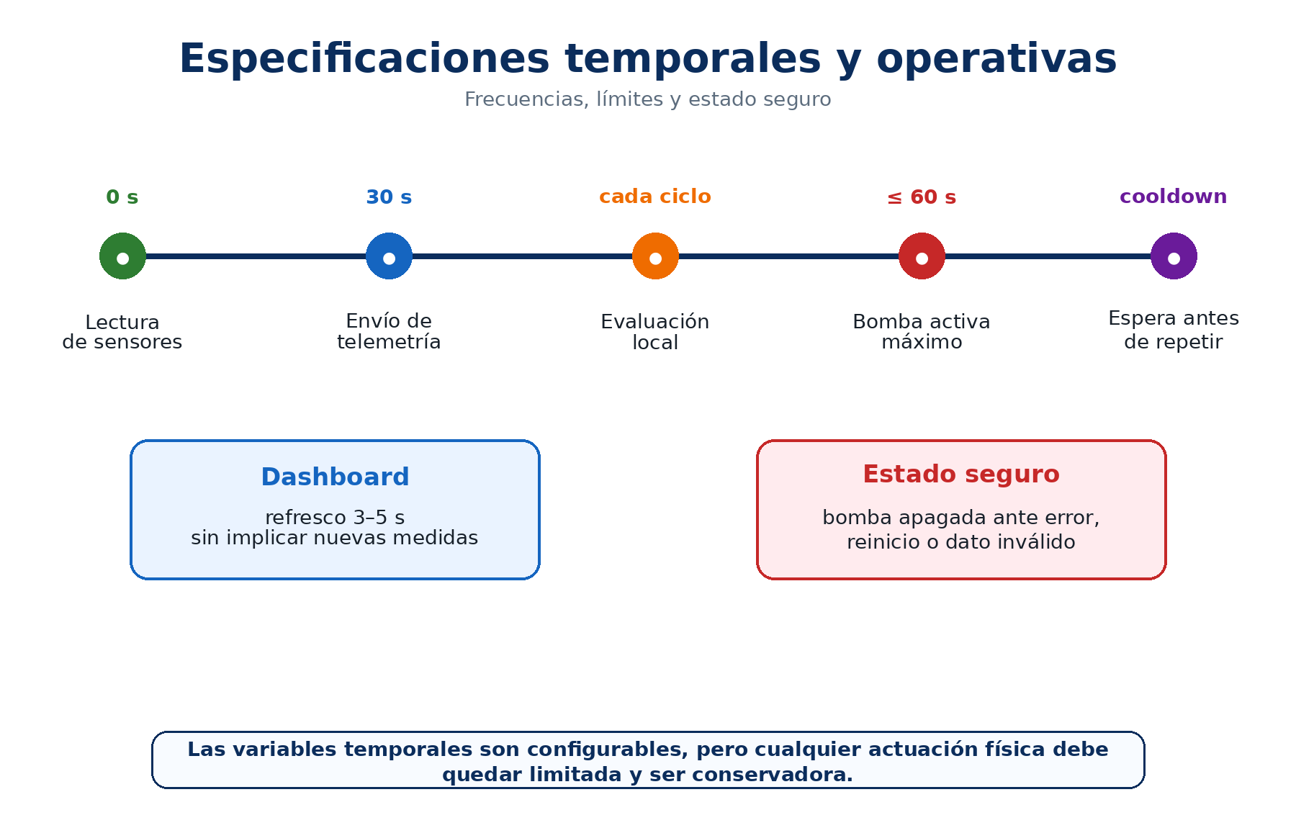
memoria/figs/figura_3_3_especificaciones_temporales.png
