ltejedorcruz/TierraViva/memoria/figs/figura_3_4_metodologia_incremental.png

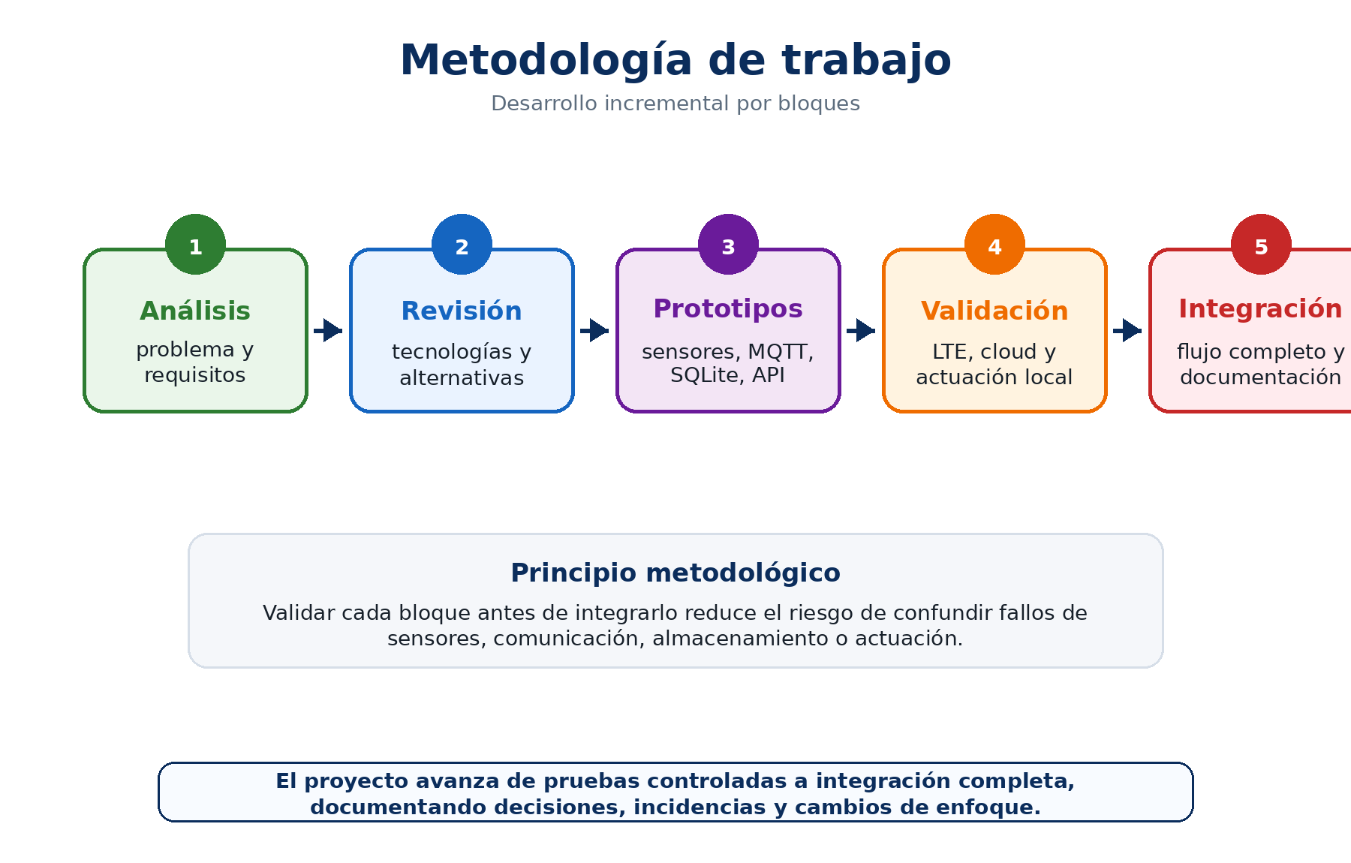
memoria/figs/figura_3_4_metodologia_incremental.png
