ltejedorcruz/TierraViva/memoria/figs/figura_3_6_variables_sensores.png

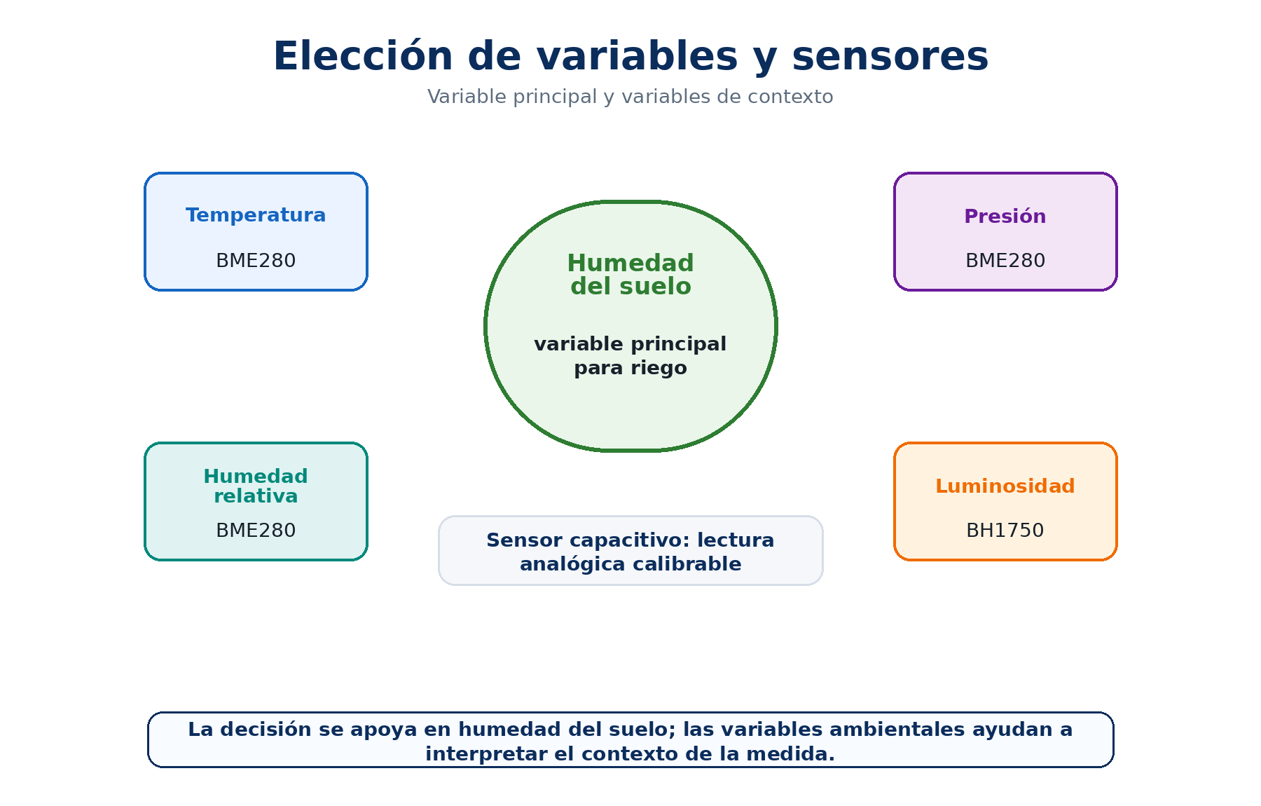
memoria/figs/figura_3_6_variables_sensores.png
