ltejedorcruz/TierraViva/memoria/figs/figura_3_7_plataformas_control_supervision.png

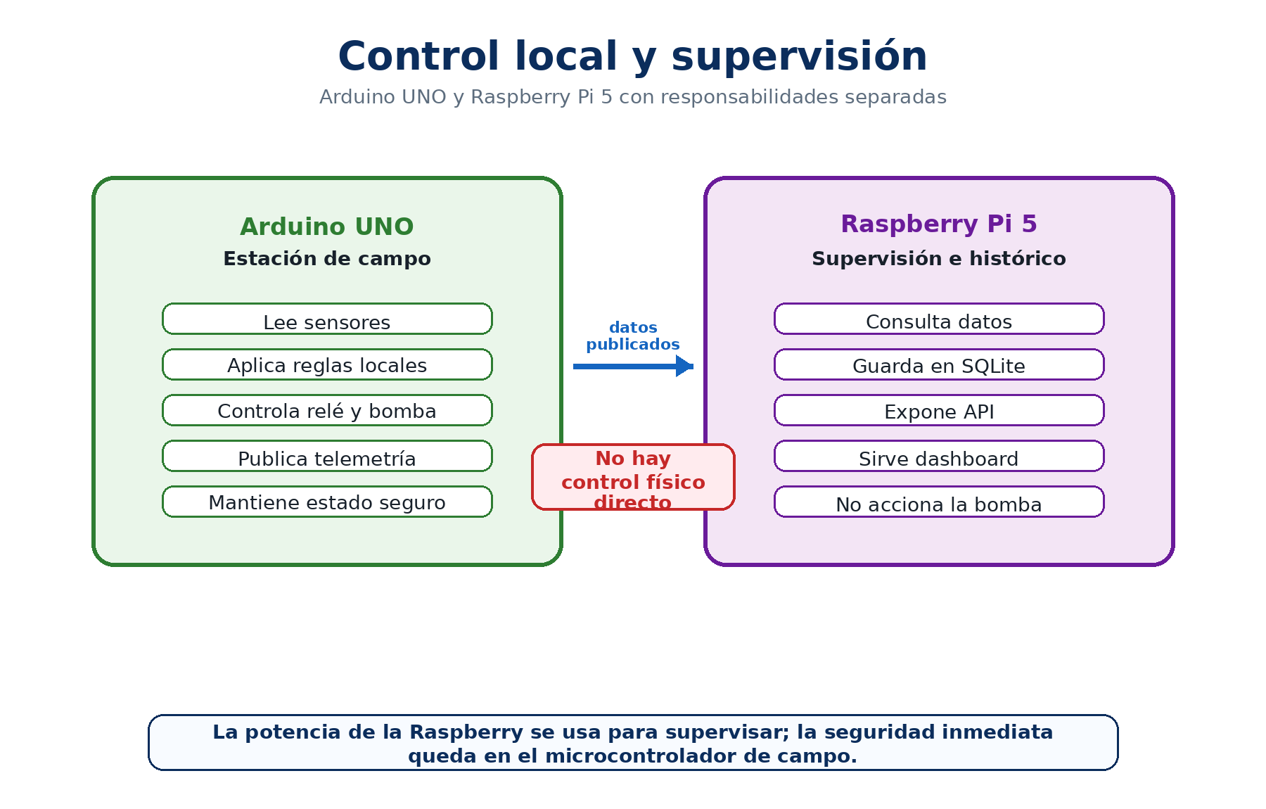
memoria/figs/figura_3_7_plataformas_control_supervision.png
