ltejedorcruz/TierraViva/memoria/figs/figura_3_8_decision_comunicaciones_lora_lte.png

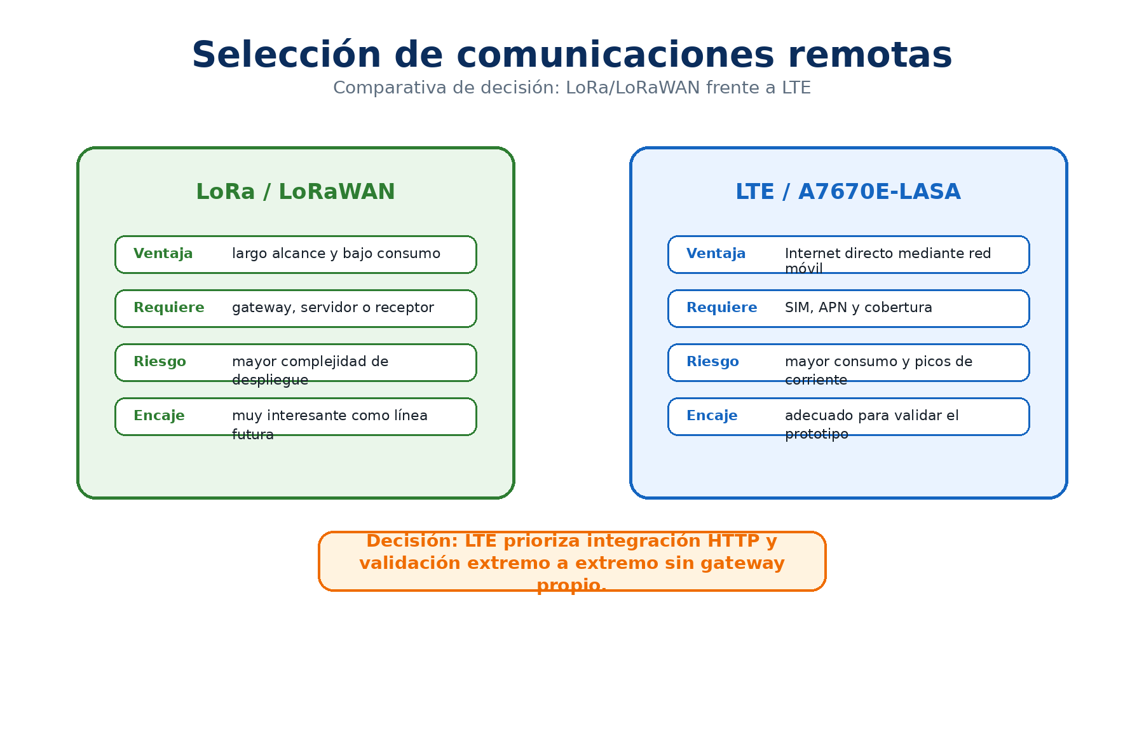
memoria/figs/figura_3_8_decision_comunicaciones_lora_lte.png
