ltejedorcruz/TierraViva/memoria/figs/figura_3_9_thingspeak_capa_intermedia.png

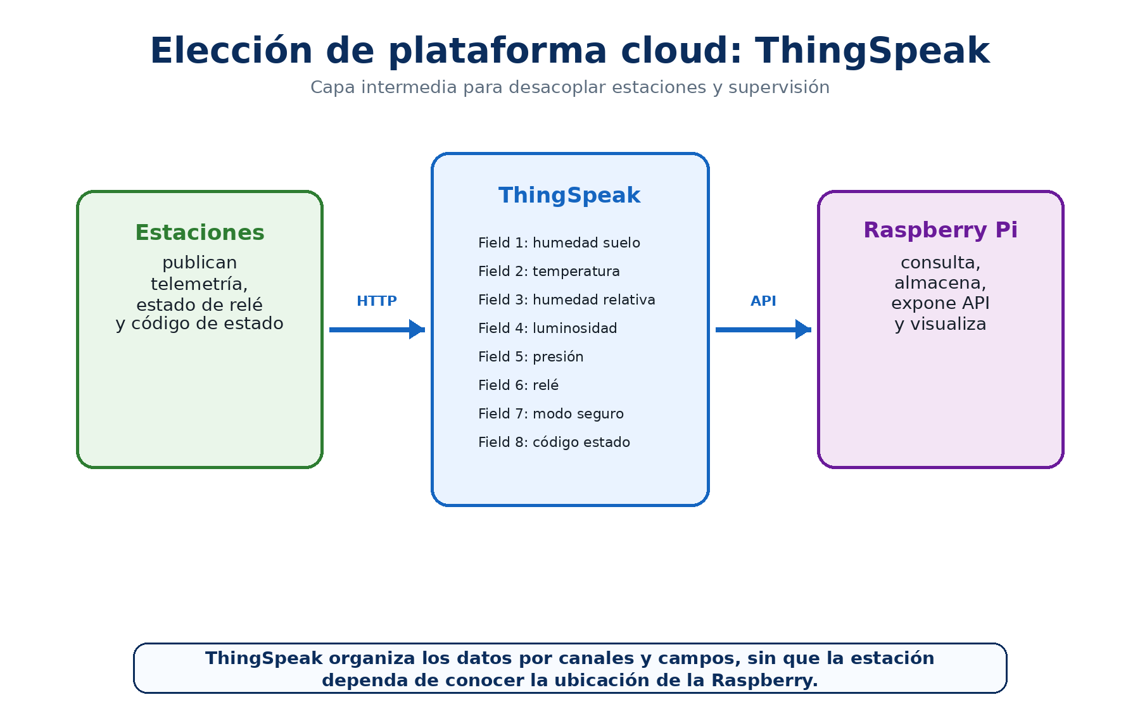
memoria/figs/figura_3_9_thingspeak_capa_intermedia.png
