ltejedorcruz/TierraViva/memoria/figs/figura_3_10_arquitectura_software_raspberry.png

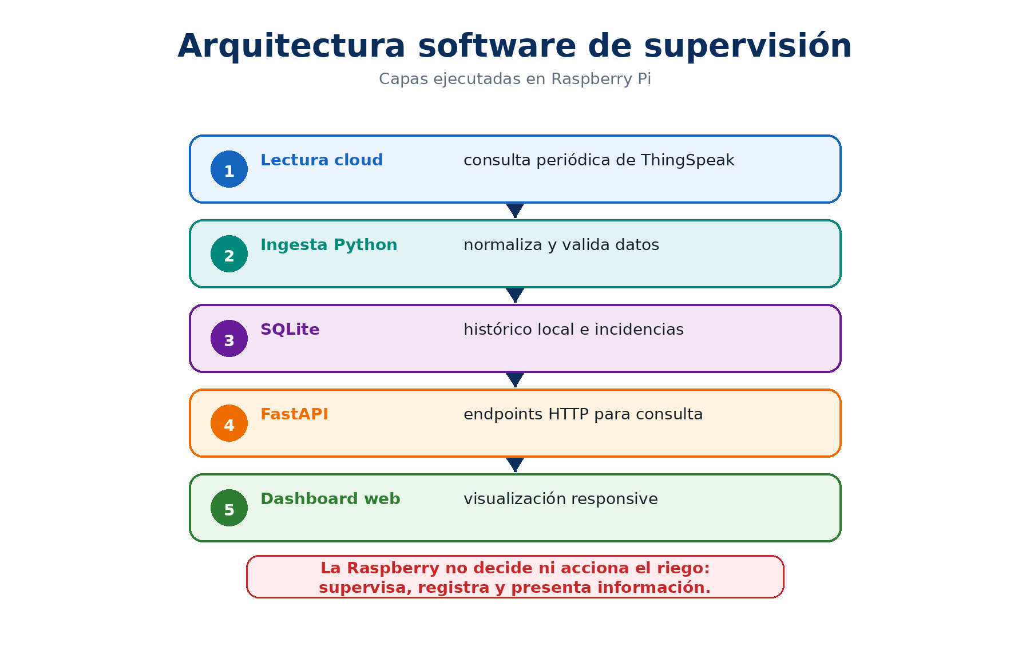
memoria/figs/figura_3_10_arquitectura_software_raspberry.png
