ltejedorcruz/TierraViva/memoria/figs/figura_3_12_riesgos_mitigacion.png

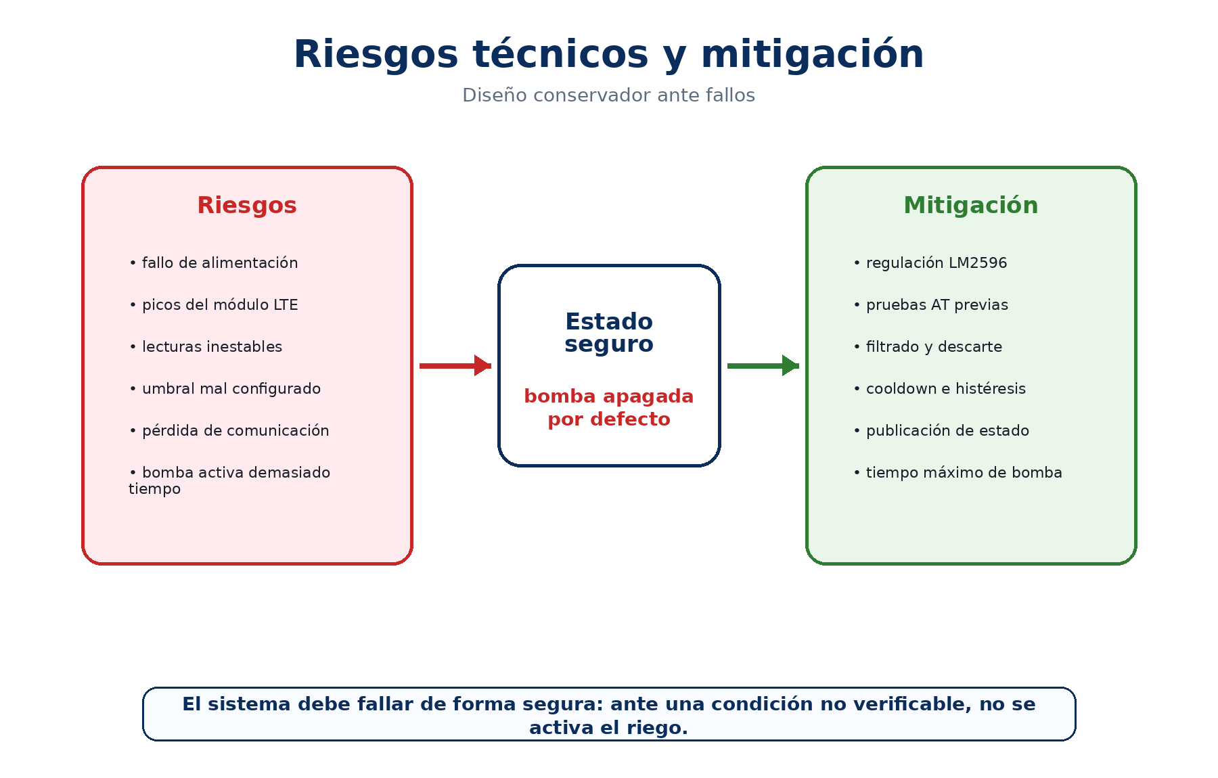
memoria/figs/figura_3_12_riesgos_mitigacion.png
