ltejedorcruz/TierraViva/memoria/figs/lm2596.jpg

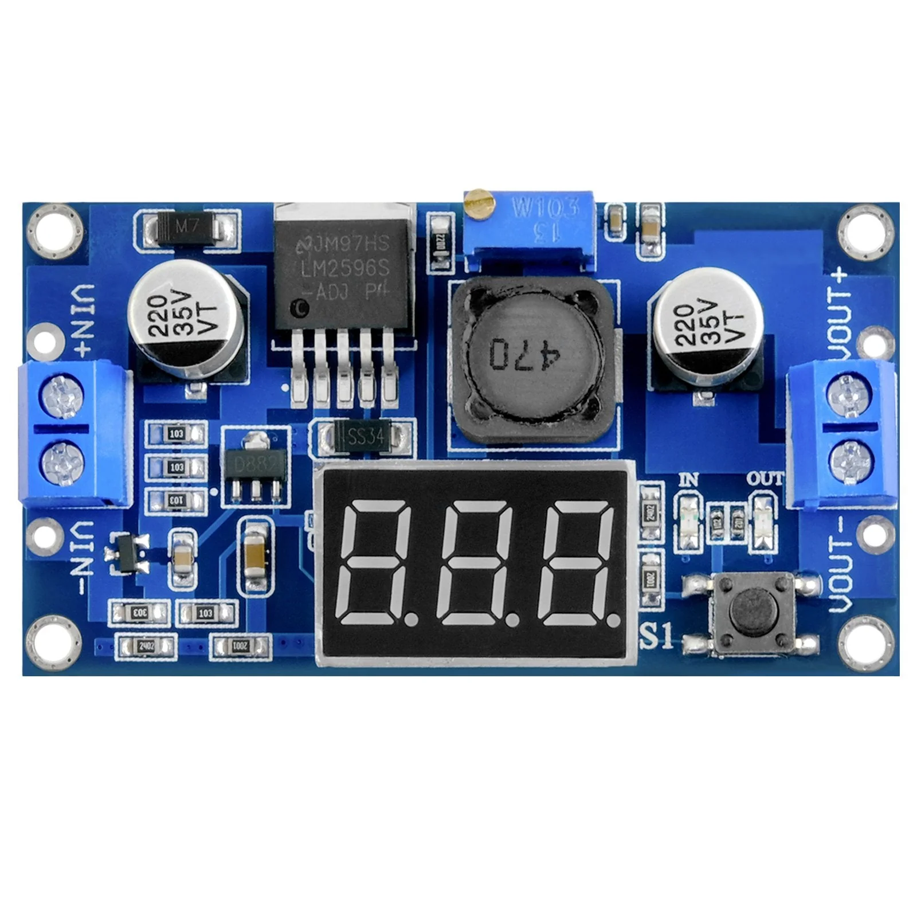
memoria/figs/lm2596.jpg
