ltejedorcruz/TierraViva/memoria/figs/protoboard.png

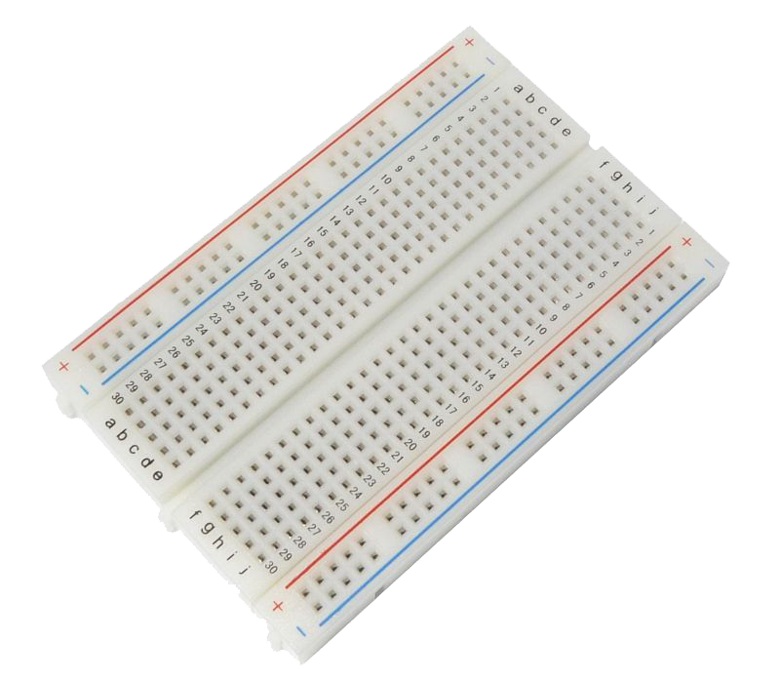
memoria/figs/protoboard.png
