ltejedorcruz/TierraViva/memoria/figs/rele.jpg

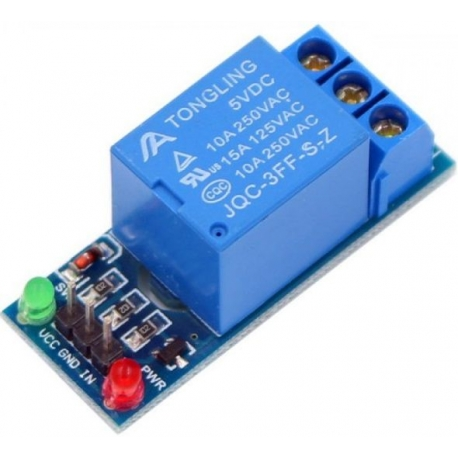
memoria/figs/rele.jpg
