ltejedorcruz/TierraViva/memoria/figs/resistencias_condensadores.jpg

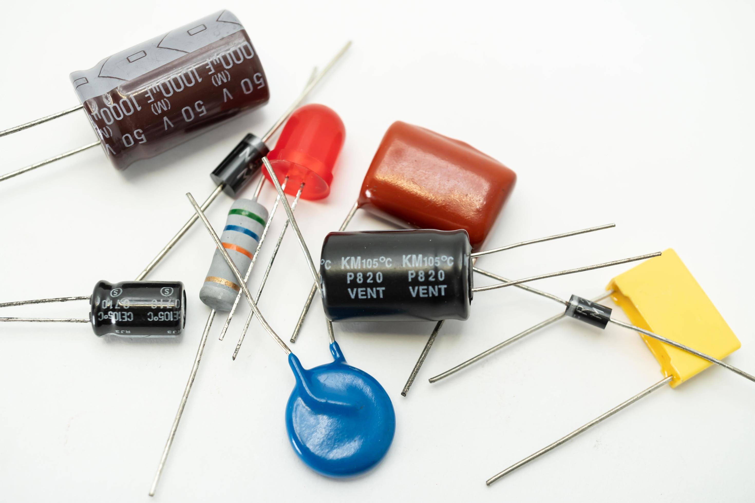
memoria/figs/resistencias_condensadores.jpg
