ltejedorcruz/TierraViva/memoria/figs/tarjeta_sim.jpg

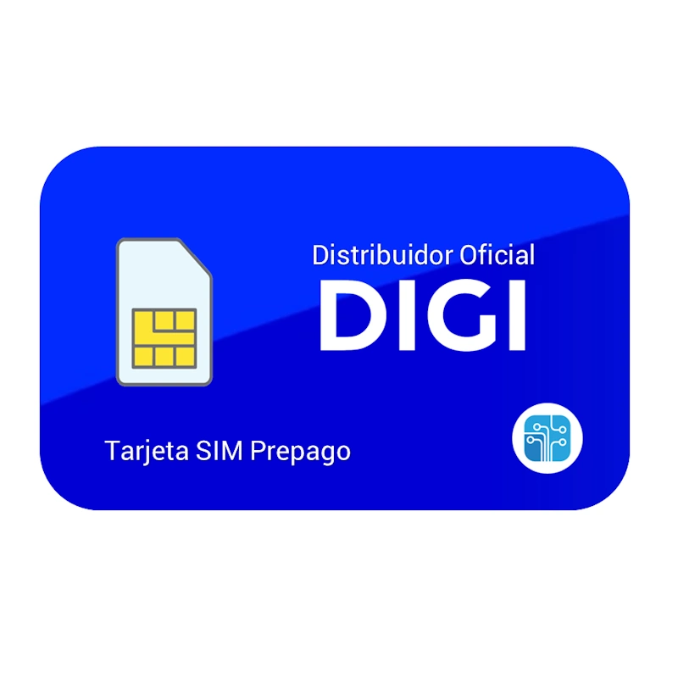
memoria/figs/tarjeta_sim.jpg
