ltejedorcruz/TierraViva/memoria/figs/thingspeak_canales_tierraviva.png

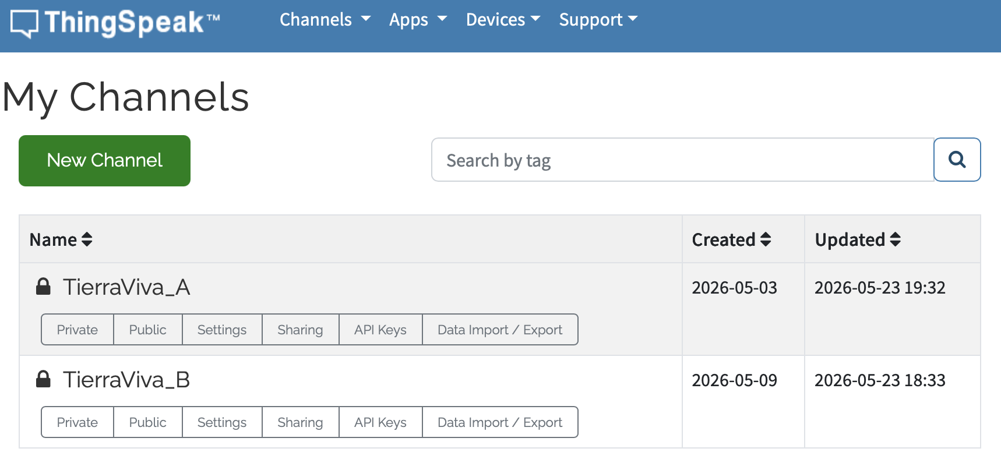
memoria/figs/thingspeak_canales_tierraviva.png
