ltejedorcruz/TierraViva/memoria/figs/Variables_Decision_Riego.png

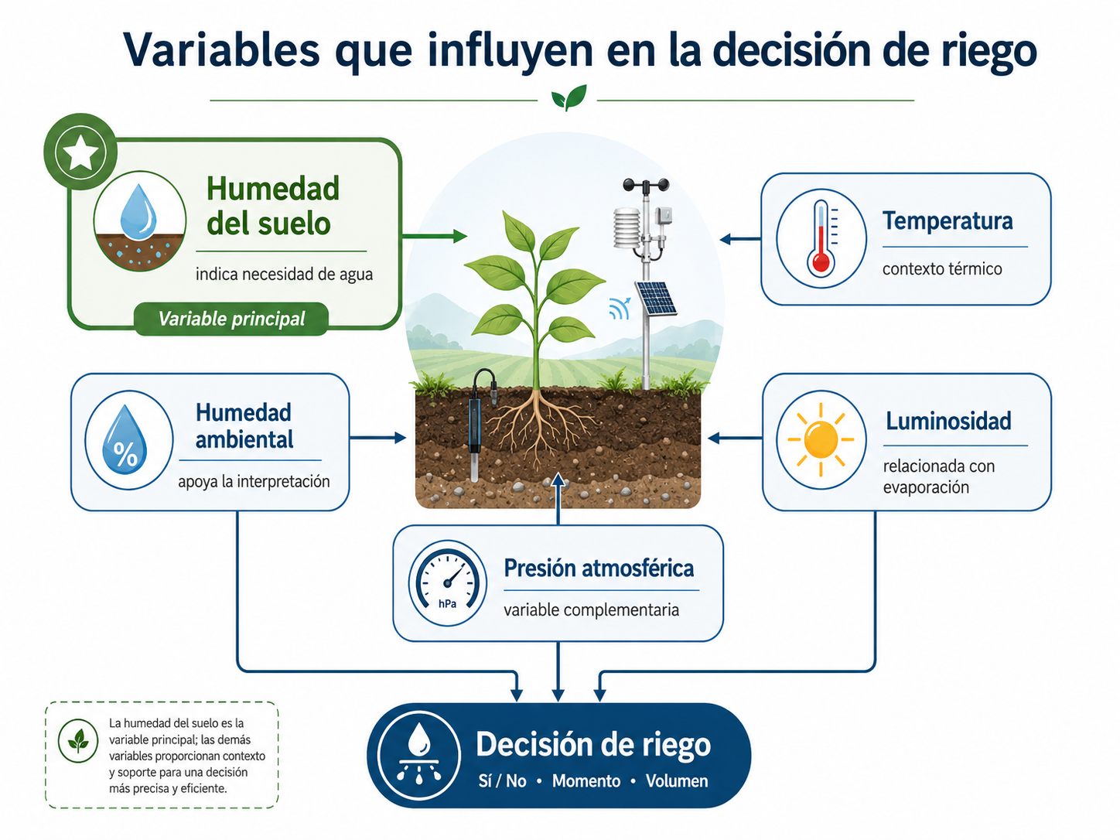
memoria/figs/Variables_Decision_Riego.png
