ltejedorcruz/TierraViva/memoria/figs_png/by-sa.png

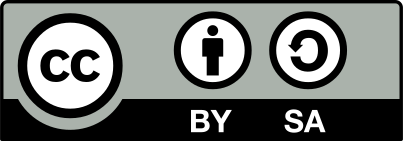
memoria/figs_png/by-sa.png
