ltejedorcruz/TierraViva/memoria/figs_png/cap6_confirmacion_humedad.png

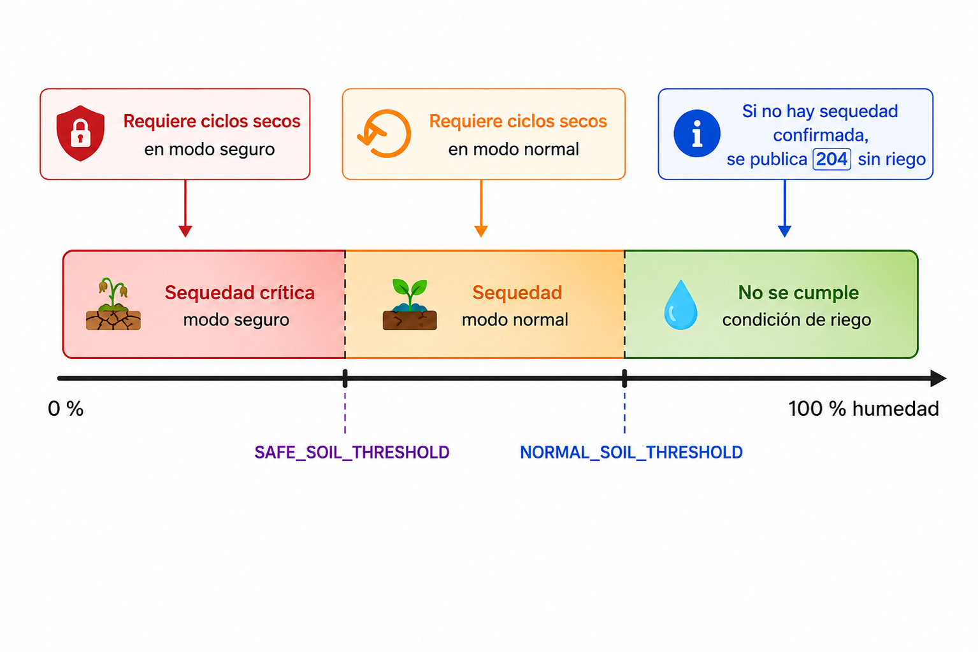
memoria/figs_png/cap6_confirmacion_humedad.png
