ltejedorcruz/TierraViva/memoria/figs_png/esquema_estacion_TierraViva.png

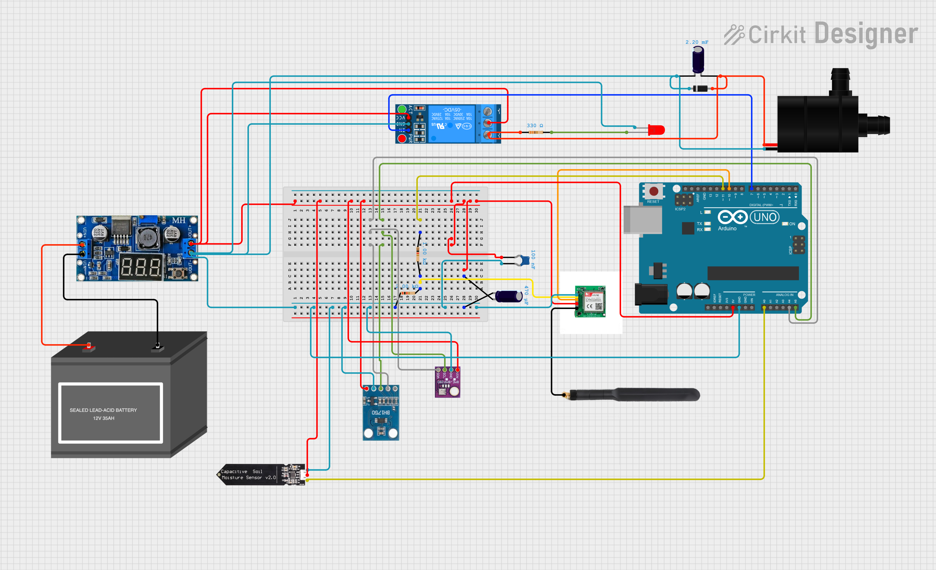
memoria/figs_png/esquema_estacion_TierraViva.png
