ltejedorcruz/TierraViva/memoria/figs_png/esquema_estacion_TierraViva_sinCondensador.png

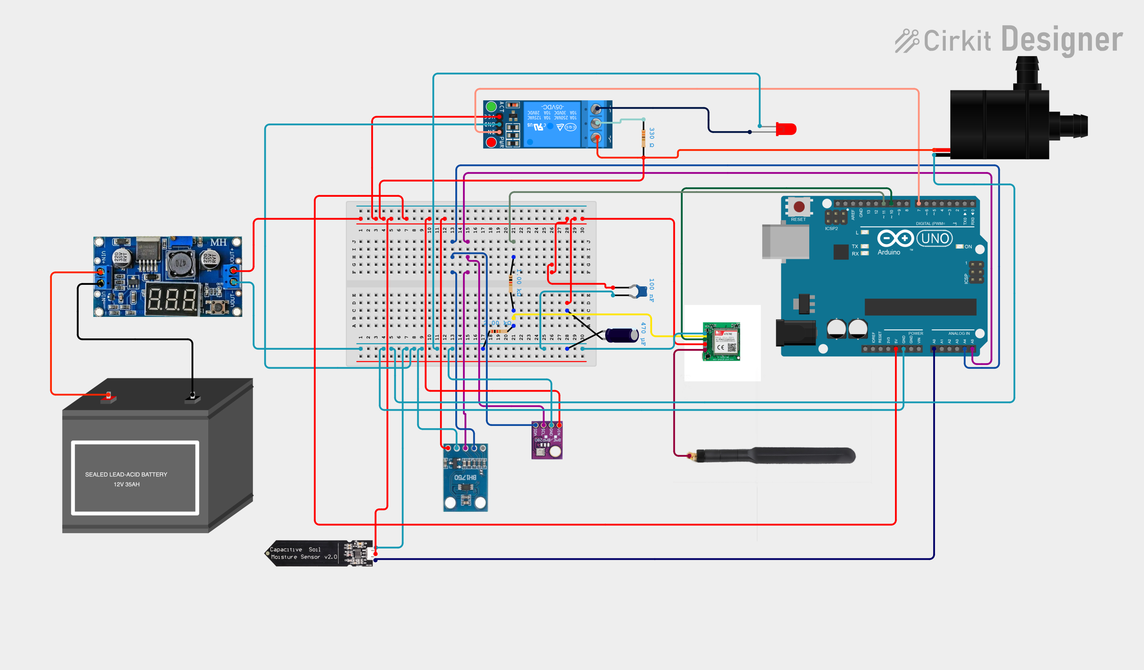
memoria/figs_png/esquema_estacion_TierraViva_sinCondensador.png
