ltejedorcruz/TierraViva/memoria/figs_png/figura_3_10_arquitectura_software_raspberry.png

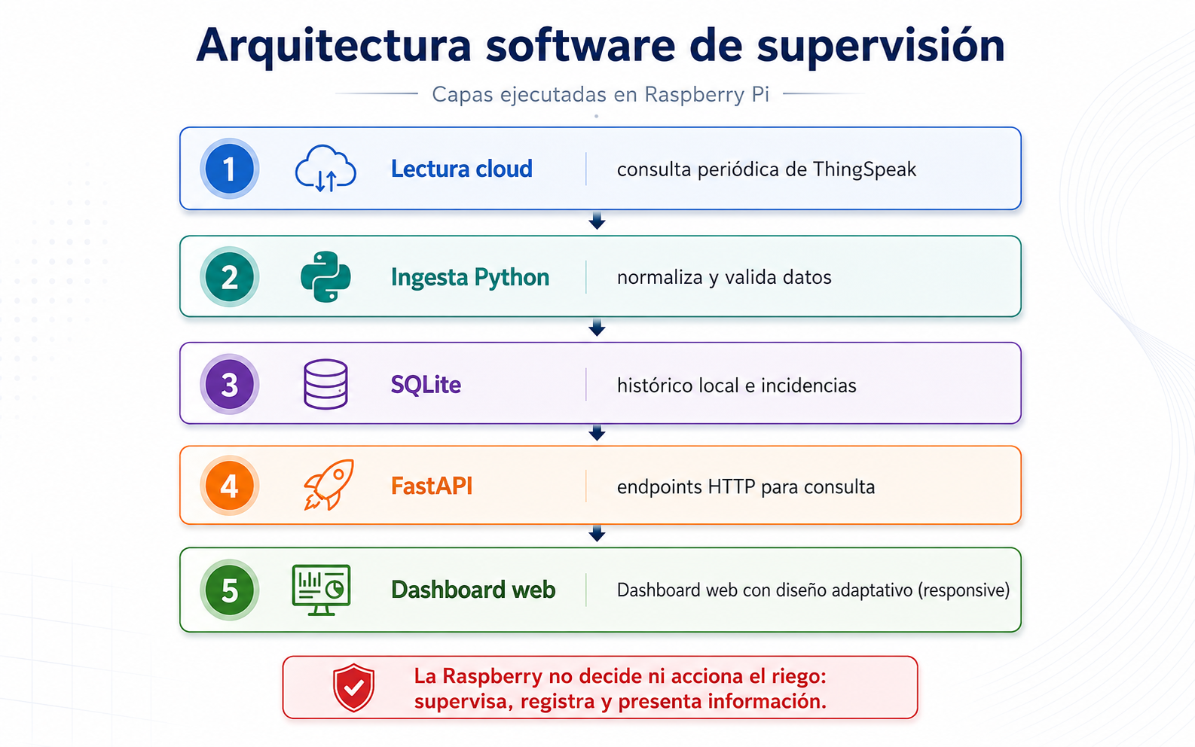
memoria/figs_png/figura_3_10_arquitectura_software_raspberry.png
