ltejedorcruz/TierraViva/memoria/figs_png/figura_4_3_secuencia_lte_http.png

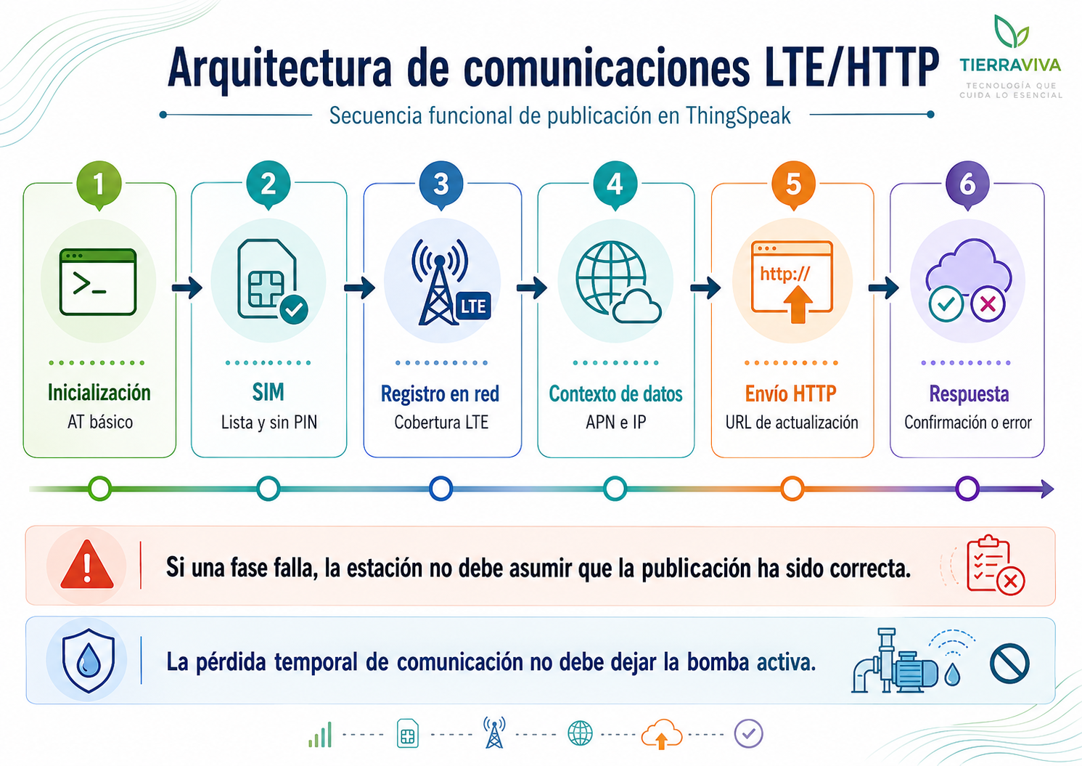
memoria/figs_png/figura_4_3_secuencia_lte_http.png
