ltejedorcruz/TierraViva/memoria/figs_png/motor_reglas_flujo.png

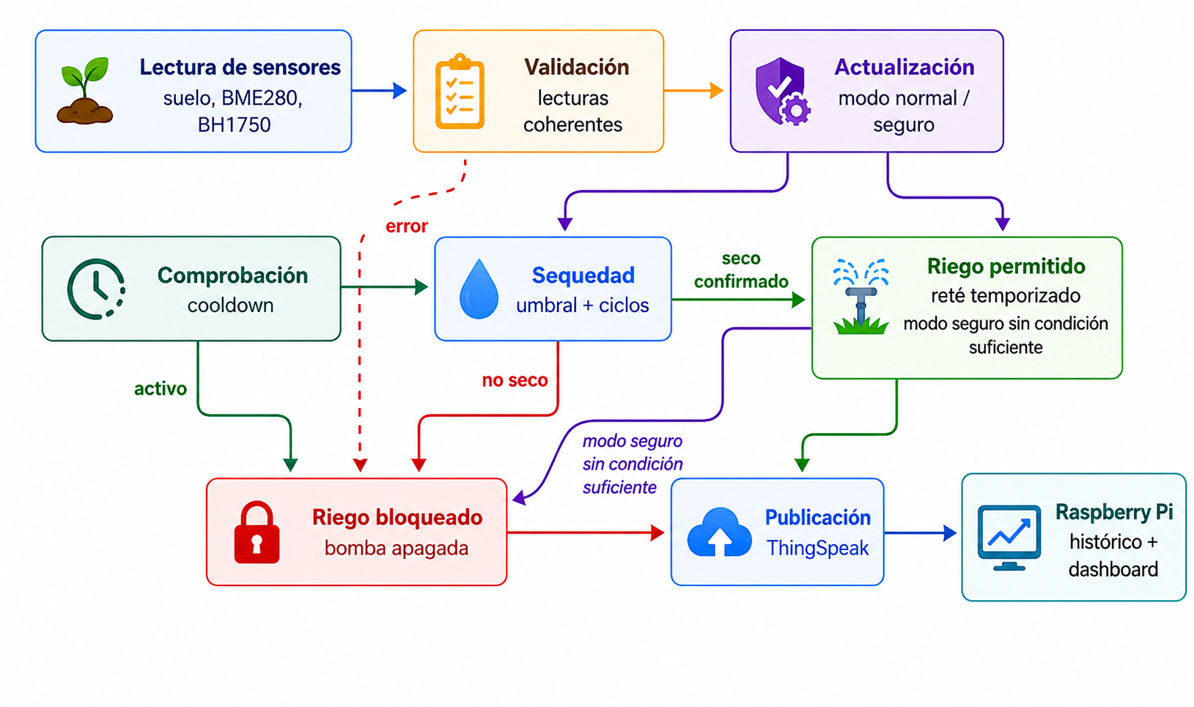
memoria/figs_png/motor_reglas_flujo.png
