ltejedorcruz/TierraViva/memoria/figs_png/riegoTrad_riegoInt.png

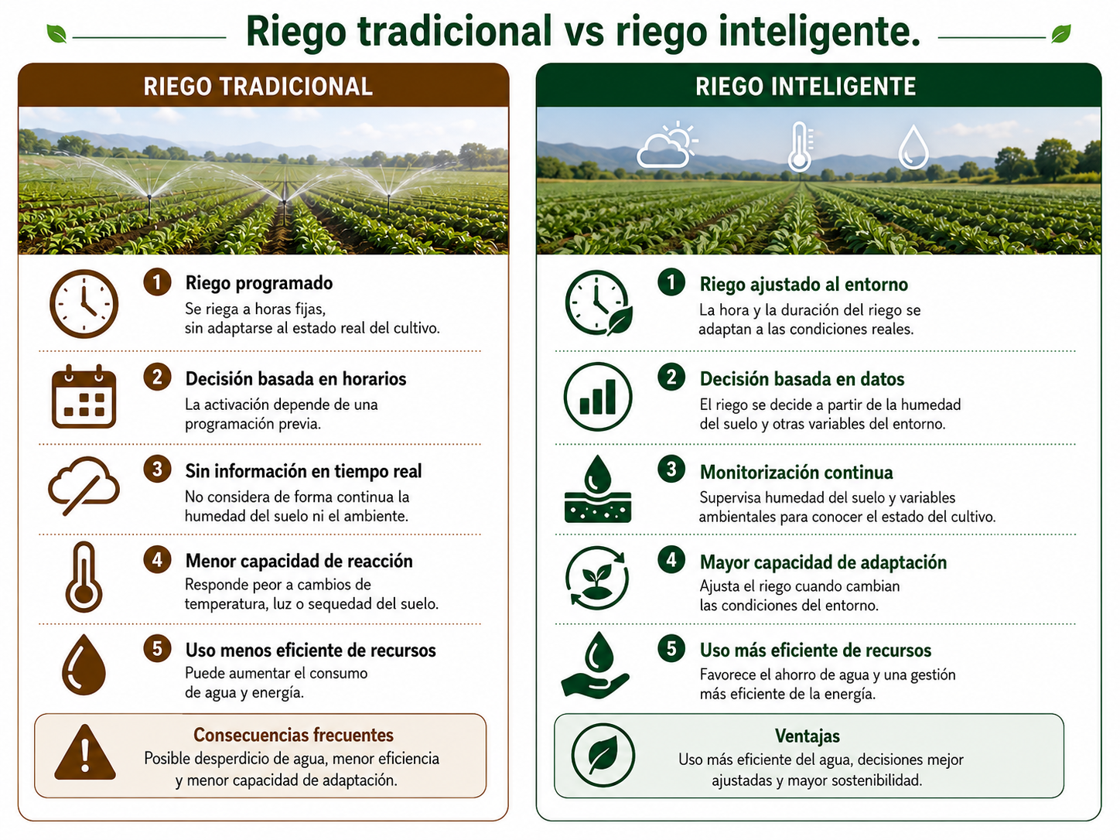
memoria/figs_png/riegoTrad_riegoInt.png
