ltejedorcruz/TierraViva/memoria/figs_png/TierraViva.png

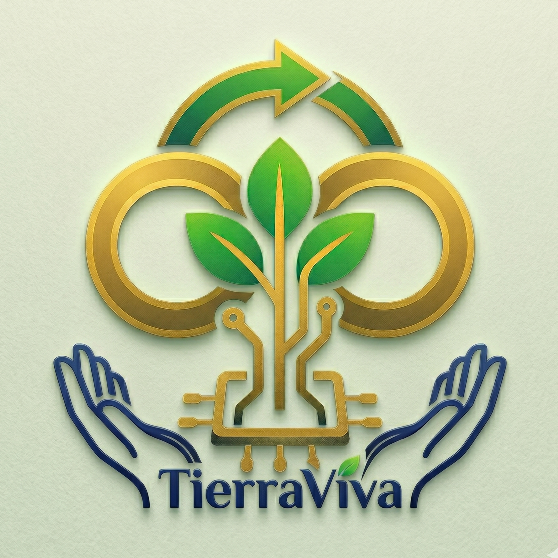
memoria/figs_png/TierraViva.png
