ltejedorcruz/TierraViva/memoria/figs/figura_2_3_nodo_iot_componentes.png

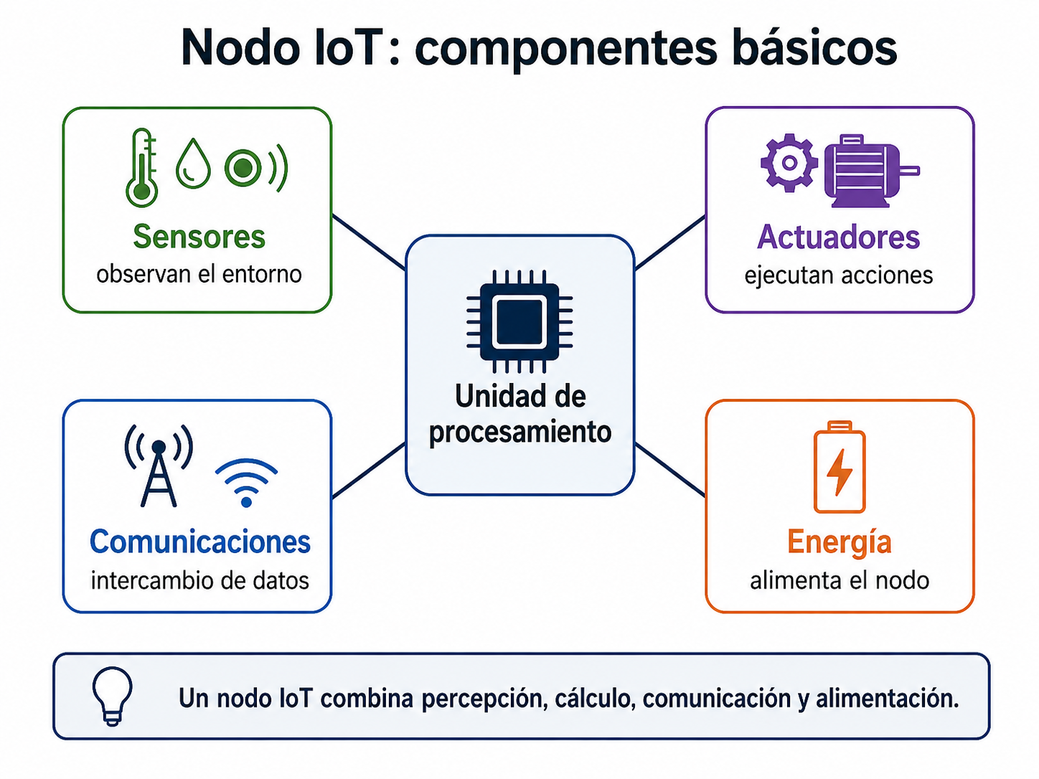
memoria/figs/figura_2_3_nodo_iot_componentes.png
