ltejedorcruz/TierraViva/memoria/figs/figura_3_11_materiales_por_bloques.png

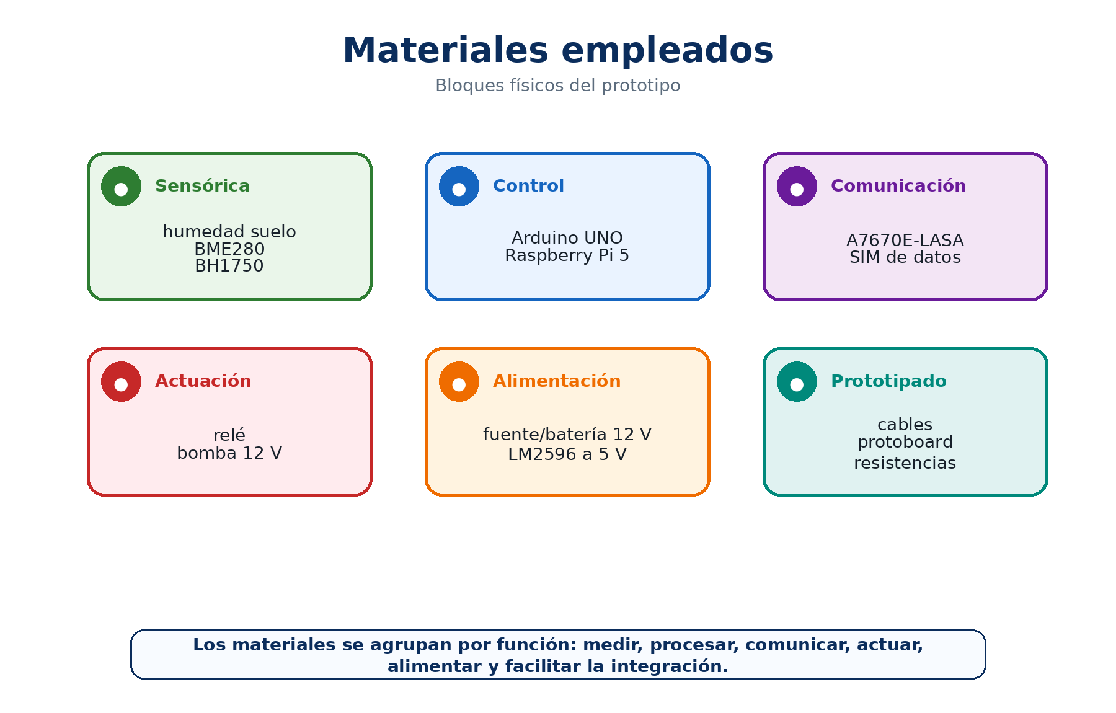
memoria/figs/figura_3_11_materiales_por_bloques.png
