ltejedorcruz/TierraViva/prototipos/estacion_pruebas/doc_a7670e/referencias_documentacion.md

# Documentación técnica consultada del módulo A7670E

Durante el desarrollo se consultó documentación técnica del módulo SIMCom A7670E/A76XX:

- A76XX Series AT Command Manual V2.00.
- A7670 Series Specification, 2024-03-27.
- A7670X Series Hardware Design V1.03.
- BK-A7670/BKP-A7670 Board User Manual V2.1.
- BKP-A7670 V3.1 SCH.

La documentación se mantiene como referencia local de desarrollo y no se incluye completa en el repositorio para evitar incorporar binarios, drivers o documentación de terceros sin necesidad.
