ltejedorcruz/TierraViva/memoria/anexos/plan_pruebas.tex

\chapter{Plan de pruebas}
\label{anexo:plan_pruebas}

Este anexo define el plan de pruebas seguido para validar el funcionamiento de TierraViva. El objetivo es comprobar de forma progresiva cada parte del sistema antes de realizar una integración completa: sensores, comunicaciones, almacenamiento, \textit{dashboard} y actuación sobre el riego.

Al tratarse de un prototipo que combina hardware, software y servicios externos, las pruebas se han organizado por fases. Esta estrategia reduce el riesgo de errores difíciles de aislar, ya que permite validar primero cada bloque por separado y después comprobar el comportamiento del sistema completo.

\section{Estrategia general de pruebas}

La validación de TierraViva se plantea como un proceso incremental. En primer lugar se prueban los componentes de forma aislada; después se comprueba la comunicación entre bloques; finalmente se valida el funcionamiento integrado del prototipo.

\begingroup
\small
\renewcommand{\arraystretch}{1.20}
\rowcolors{2}{TableRowSoft}{white}

\begin{longtable}{|
>{\centering\arraybackslash}p{0.10\textwidth}|
>{\raggedright\arraybackslash}p{0.30\textwidth}|
>{\raggedright\arraybackslash}p{0.48\textwidth}|}

\caption{Estrategia general de pruebas del proyecto TierraViva.}
\label{tab:estrategia_pruebas}\\

\hline
\rowcolor{URJCRed}
\TVHead{Fase} & \TVHead{Tipo de prueba} & \TVHead{Objetivo principal} \\
\hline
\endfirsthead

\hline
\rowcolor{URJCRed}
\TVHead{Fase} & \TVHead{Tipo de prueba} & \TVHead{Objetivo principal} \\
\hline
\endhead

\hline
\multicolumn{3}{r}{\small Continúa en la página siguiente} \\
\endfoot

\hline
\endlastfoot

F1 & Pruebas eléctricas básicas & Verificar alimentación, masas comunes, tensiones y conexiones antes de cargar el sistema completo. \\
\hline
F2 & Pruebas de sensores & Comprobar que los sensores entregan lecturas coherentes y estables. \\
\hline
F3 & Pruebas del módulo LTE & Validar comunicación AT, registro en red y envío de datos. \\
\hline
F4 & Pruebas de ThingSpeak & Confirmar publicación y lectura remota de telemetría. \\
\hline
F5 & Pruebas de Raspberry Pi & Verificar consulta de datos, almacenamiento SQLite, API y \textit{dashboard}. \\
\hline
F6 & Pruebas de actuación sin carga real & Validar la lógica de riego usando relé o indicador, sin bomba conectada. \\
\hline
F7 & Pruebas de actuación, sin bomba conectada & Comprobar activación temporizada y apagado seguro del sistema de riego. \\
\hline
F7 & Pruebas de actuación con bomba & Comprobar activación temporizada y apagado seguro del sistema de riego. \\
\hline
F8 & Pruebas de integración completa & Validar el flujo completo estación--ThingSpeak--Raspberry--dashboard--riego. \\
\hline
F9 & Prueba funcional en entorno real & Evaluar el comportamiento del prototipo en Agrolab Móstoles, comprobando el funcionamiento de la estación, la publicación de datos, la supervisión y la actuación controlada del riego. \\
\hline

\end{longtable}

\normalsize
\endgroup

\section{Entorno de pruebas}

El entorno de pruebas se compone de una estación remota, una Raspberry Pi como nodo de supervisión, una cuenta de ThingSpeak y un sistema de riego controlado mediante relé.

\begingroup
\small
\renewcommand{\arraystretch}{1.20}
\rowcolors{2}{TableRowSoft}{white}

\begin{longtable}{|
>{\raggedright\arraybackslash}p{0.30\textwidth}|
>{\raggedright\arraybackslash}p{0.62\textwidth}|}

\caption{Elementos empleados en el entorno de pruebas.}
\label{tab:entorno_pruebas}\\

\hline
\rowcolor{URJCRed}
\TVHead{Elemento} & \TVHead{Uso durante las pruebas} \\
\hline
\endfirsthead

\hline
\rowcolor{URJCRed}
\TVHead{Elemento} & \TVHead{Uso durante las pruebas} \\
\hline
\endhead

\hline
\multicolumn{2}{r}{\small Continúa en la página siguiente} \\
\endfoot

\hline
\endlastfoot

Arduino UNO & Ejecución del \textit{firmware} de estación, lectura de sensores y control del relé. \\
\hline
A7670E-LASA & Comunicación LTE/4G mediante comandos AT y envío de telemetría. \\
\hline
BME280 & Medición de temperatura, humedad relativa y presión atmosférica. \\
\hline
BH1750 & Medición de luminosidad ambiental. \\
\hline
Sensor capacitivo de humedad del suelo & Medición de humedad del sustrato para la decisión de riego. \\
\hline
Módulo relé & Conmutación de la bomba o carga de prueba. \\
\hline
Bomba de 12 V & Actuación física sobre el sistema de riego. \\
\hline
ThingSpeak & Recepción de telemetría y consulta remota desde Raspberry Pi. \\
\hline
Raspberry Pi & Ejecución de \textit{scripts} de consulta, almacenamiento SQLite, API y \textit{dashboard}. \\
\hline
SQLite & Registro histórico de lecturas, estados y eventos de riego. \\
\hline
\textit{Dashboard} web & Visualización del estado del sistema y de las últimas lecturas. \\
\hline
Agrolab Móstoles & Entorno real de agricultura urbana/periurbana utilizado para la prueba funcional final del prototipo. \\
\hline

\end{longtable}

\normalsize
\endgroup

\section{Criterios de aceptación}

Para considerar válida una prueba, se definen criterios de aceptación claros. Estos criterios permiten evitar una validación subjetiva basada únicamente en que el sistema ``parece funcionar''.

\begingroup
\small
\renewcommand{\arraystretch}{1.20}
\rowcolors{2}{TableRowSoft}{white}

\begin{longtable}{|
>{\raggedright\arraybackslash}p{0.30\textwidth}|
>{\raggedright\arraybackslash}p{0.62\textwidth}|}

\caption{Criterios generales de aceptación de pruebas.}
\label{tab:criterios_aceptacion}\\

\hline
\rowcolor{URJCRed}
\TVHead{Área} & \TVHead{Criterio de aceptación} \\
\hline
\endfirsthead

\hline
\rowcolor{URJCRed}
\TVHead{Área} & \TVHead{Criterio de aceptación} \\
\hline
\endhead

\hline
\multicolumn{2}{r}{\small Continúa en la página siguiente} \\
\endfoot

\hline
\endlastfoot

Alimentación & Las tensiones medidas se mantienen dentro de valores seguros antes y durante la prueba. \\
\hline
Sensores & Las lecturas son coherentes con el entorno y se mantienen dentro de rangos físicamente plausibles. \\
\hline
Comunicación LTE & El módulo responde a comandos AT, registra red y permite enviar datos. \\
\hline
ThingSpeak & Los datos enviados por la estación aparecen en el canal correspondiente. \\
\hline
Raspberry Pi & El sistema consulta lecturas, las almacena localmente y mantiene ejecución estable. \\
\hline
API & Los endpoints devuelven respuestas válidas y coherentes con la base de datos. \\
\hline
\textit{Dashboard} & La interfaz muestra datos actualizados y estados interpretables para el usuario. \\
\hline
Relé & El relé cambia de estado únicamente cuando corresponde y vuelve a estado seguro. \\
\hline
Bomba & La bomba se activa durante el tiempo previsto y se apaga al finalizar. \\
\hline
Seguridad & El sistema evita riegos repetidos, excesivos o provocados por datos no válidos. \\
\hline

\end{longtable}

\normalsize
\endgroup

\section{Casos de prueba}

La Tabla \ref{tab:casos_prueba} recoge los casos de prueba principales. Se han seleccionado pruebas representativas de cada bloque del sistema, priorizando aquellas que validan la funcionalidad esencial del prototipo.

\begingroup
\scriptsize
\renewcommand{\arraystretch}{1.15}
\rowcolors{2}{TableRowSoft}{white}

\begin{longtable}{|
>{\centering\arraybackslash}p{0.07\textwidth}|
>{\raggedright\arraybackslash}p{0.20\textwidth}|
>{\raggedright\arraybackslash}p{0.31\textwidth}|
>{\raggedright\arraybackslash}p{0.32\textwidth}|}

\caption{Casos de prueba principales definidos para TierraViva.}
\label{tab:casos_prueba}\\

\hline
\rowcolor{URJCRed}
\TVHead{ID} & \TVHead{Prueba} & \TVHead{Procedimiento} & \TVHead{Resultado esperado} \\
\hline
\endfirsthead

\hline
\rowcolor{URJCRed}
\TVHead{ID} & \TVHead{Prueba} & \TVHead{Procedimiento} & \TVHead{Resultado esperado} \\
\hline
\endhead

\hline
\multicolumn{4}{r}{\small Continúa en la página siguiente} \\
\endfoot

\hline
\endlastfoot

P01 & Verificación de alimentación & Medir la salida del LM2596 y comprobar masa común antes de conectar todos los módulos. & Tensiones correctas y ausencia de calentamiento o reinicios. \\
\hline
P02 & Lectura de BME280 & Ejecutar el \textit{firmware} con el sensor conectado al bus I2C. & Temperatura, humedad y presión con valores coherentes. \\
\hline
P03 & Lectura de BH1750 & Exponer el sensor a diferentes condiciones de luz. & Variación de lux coherente entre sombra y luz directa. \\
\hline
P04 & Lectura de humedad del suelo & Probar el sensor en seco, húmedo y condición intermedia. & Valores diferenciables que permitan definir umbrales. \\
\hline
P05 & Comunicación AT con A7670E-LASA & Enviar comandos básicos como \texttt{AT}, \texttt{AT+CPIN?}, \texttt{AT+CSQ} y \texttt{AT+CEREG?}. & Respuestas válidas, SIM lista y registro en red. \\
\hline
P06 & Publicación en ThingSpeak & Enviar una lectura de prueba desde la estación mediante LTE/HTTP. & La estación recibe una respuesta \texttt{+HTTPACTION: 0,200,...} y la lectura aparece en el canal ThingSpeak correspondiente. \\
\hline
P07 & Consulta desde Raspberry Pi & Ejecutar el \textit{script} de lectura de ThingSpeak. & La Raspberry recupera la última lectura disponible. \\
\hline
P08 & Almacenamiento en SQLite & Insertar lecturas obtenidas desde ThingSpeak en la base de datos local. & Las lecturas quedan registradas con estación, fecha y valores. \\
\hline
P09 & API local & Consultar endpoints como \texttt{/api/latest}, \texttt{/api/readings} y \texttt{/api/health}. & La API responde correctamente y devuelve datos coherentes. \\
\hline
P10 & \textit{Dashboard} web & Abrir la interfaz desde navegador y comprobar actualización de datos. & El \textit{dashboard} muestra lecturas, estado y frescura de datos. \\
\hline
P11 & Relé sin bomba & Activar el pin de control y observar el cambio de estado del relé sin carga hidráulica. & El relé conmuta y vuelve a apagado al finalizar. \\
\hline
P12 & Bomba con activación temporizada & Conectar bomba o carga real y ejecutar una actuación de riego limitada por \textit{firmware}. & El monitor serie registra \texttt{Riego completado. Segundos: 10} y la bomba se apaga al finalizar el intervalo configurado. \\
\hline
P13 & \textit{Cooldown} entre riegos & Forzar decisiones de riego consecutivas en ciclos próximos. & El monitor serie registra \texttt{Cooldown activo: SI} y \texttt{Decision local: COOLDOWN}, bloqueando la nueva actuación. \\
\hline
P14 & Lectura inválida de humedad & Simular valor fuera de rango o desconexión del sensor. & El sistema mantiene la bomba apagada y registra estado de error. \\
\hline
P15 & Pérdida temporal de comunicación & Interrumpir temporalmente la publicación o consulta de datos. & El sistema registra el fallo y mantiene estado seguro. \\
\hline
P16 & Integración completa & Ejecutar estación, ThingSpeak, Raspberry, API, \textit{dashboard} y actuación. & El flujo completo funciona de extremo a extremo y queda documentado mediante capturas del monitor serie, ThingSpeak, API y \textit{dashboard}. \\
\hline
P17 & Prueba funcional en Agrolab Móstoles & Instalar el prototipo en Agrolab, ejecutar la estación, comprobar telemetría, \textit{dashboard} y actuación controlada, y registrar foto/vídeo como evidencia. & El sistema funciona en entorno real de cultivo y mantiene actuación segura. \\
\hline

\end{longtable}

\normalsize
\endgroup

\subsection{P17. Prueba funcional en entorno real en Agrolab Móstoles}
\label{subsec:p17_agrolab_mostoles}

\textbf{Objetivo.} Validar el comportamiento del prototipo TierraViva en un entorno real de cultivo, comprobando adquisición de datos, publicación de telemetría, supervisión desde Raspberry Pi, visualización en \textit{dashboard} y actuación controlada del riego.

\textbf{Entorno de prueba.} La prueba se realiza en Agrolab Móstoles, espacio de agricultura urbana/periurbana situado en Móstoles, Madrid. Este entorno permite comprobar el funcionamiento del sistema en condiciones más próximas al uso previsto que las pruebas realizadas sobre mesa o en montaje controlado.

\textbf{Procedimiento.}
\begin{enumerate}
    \item instalar la estación en la zona de prueba autorizada;
    \item verificar alimentación, sensores, relé, bomba y conectividad LTE;
    \item iniciar el \textit{firmware} de estación y comprobar la lectura de sensores;
    \item publicar telemetría en el canal ThingSpeak correspondiente;
    \item comprobar la ingesta desde Raspberry Pi, el almacenamiento local y la visualización en \textit{dashboard};
    \item ejecutar una actuación de riego controlada;
    \item registrar fotografía del montaje y vídeo de funcionamiento como evidencia.
\end{enumerate}

\textbf{Criterios de aceptación.}
\begin{itemize}
    \item la estación obtiene lecturas coherentes de sensores;
    \item la telemetría aparece en ThingSpeak;
    \item la Raspberry Pi ingiere y almacena los datos;
    \item el dashboard muestra el estado actualizado;
    \item la bomba se activa únicamente durante el tiempo configurado;
    \item ante cualquier condición no verificable, la bomba permanece apagada.
\end{itemize}

\textbf{Evidencias.} La prueba se documenta mediante fotografía del montaje, vídeo de funcionamiento, capturas de ThingSpeak, capturas del \textit{dashboard} y registros de monitor serie. Las evidencias de monitor serie asociadas a la estación se recogen de forma específica en la Subsección~\ref{subsec:evidencias_monitor_serie_pruebas}.

\subsection{Evidencias de monitor serie de la estación remota}
\label{subsec:evidencias_monitor_serie_pruebas}

Durante las pruebas de integración de la estación se registraron salidas del monitor serie del Arduino IDE. Estas evidencias permiten comprobar el comportamiento real del \textit{firmware} durante el arranque, la lectura de sensores, la inicialización del módem LTE, la publicación en ThingSpeak y la decisión local de riego.

La Figura~\ref{fig:anexo_monitor_serie_inicio_lte} muestra la fase de arranque e integración. En ella se observa la detección de sensores I2C, la inicialización del BME280 y del BH1750, la detección de baudios del módem, el registro en red LTE, la disponibilidad de datos móviles, la decisión local de riego y la publicación correcta en ThingSpeak.

\begin{figure}[H]
    \centering
    
    \caption{Evidencia de monitor serie durante inicialización, registro LTE y publicación correcta en ThingSpeak.}
    \label{fig:anexo_monitor_serie_inicio_lte}
\end{figure}

La Figura~\ref{fig:anexo_monitor_serie_decision_riego} recoge varios ciclos consecutivos de funcionamiento. En esta captura se observa que la estación adapta su comportamiento a la humedad medida y a las condiciones internas del \textit{firmware}, alternando entre \texttt{NO RIEGO}, \texttt{RIEGO} y estados bloqueados por \textit{cooldown}.

\begin{figure}[H]
    \centering
    
    \caption{Evidencia de monitor serie durante ciclos de decisión local, actuación temporizada y publicación en ThingSpeak.}
    \label{fig:anexo_monitor_serie_decision_riego}
\end{figure}

Además de las capturas, se conserva el registro textual de ejecución. A continuación se incluyen fragmentos representativos del log, seleccionados para documentar los estados principales sin incorporar todo el fichero completo en el cuerpo del anexo.

\textbf{Inicialización de sensores, módem y conectividad LTE:}

\begin{verbatim}
=== TierraViva Estacion Remota ===
Sensores I2C listos.
BME280 OK
BH1750 OK
Detectando baudios del modem...
Probando baudios: 9600
Probando baudios: 115200
RESPONDE EN 115200
Cambiando modem a 9600...
Modem cambiado a 9600.
Modem OK
Esperando registro LTE...
LTE listo.
Datos moviles OK
Sistema listo
\end{verbatim}

\textbf{Ciclo con decisión local de riego y publicación correcta:}

\begin{verbatim}
--- Lecturas ---
Suelo bruto: 557
Suelo %: 0
Temp C: 28.8
Humedad %: 29.1
Lux: 2
Presion hPa: 946
Modo seguro: ACTIVO
Cooldown activo: NO
Decision local: RIEGO
Riego completado. Segundos: 10
HTTPACTION: AT+HTTPACTION=0

OK

+HTTPACTION: 0,200,3

ThingSpeak OK
\end{verbatim}

\textbf{Ciclo con bloqueo por \textit{cooldown}:}

\begin{verbatim}
--- Lecturas ---
Suelo bruto: 557
Suelo %: 0
Temp C: 28.8
Humedad %: 29.0
Lux: 3
Presion hPa: 946
Modo seguro: ACTIVO
Cooldown activo: SI
Decision local: COOLDOWN
HTTPACTION: AT+HTTPACTION=0

OK

+HTTPACTION: 0,200,3

ThingSpeak OK
\end{verbatim}

\textbf{Ciclo sin actuación de riego:}

\begin{verbatim}
--- Lecturas ---
Suelo bruto: 245
Suelo %: 90
Temp C: 28.8
Humedad %: 29.0
Lux: 3
Presion hPa: 946
Modo seguro: NORMAL
Cooldown activo: NO
Decision local: NO RIEGO
HTTPACTION: AT+HTTPACTION=0

OK

+HTTPACTION: 0,200,3

ThingSpeak OK
\end{verbatim}

Estos fragmentos muestran tres comportamientos relevantes para la validación: actuación de riego cuando se cumplen las condiciones de sequedad, bloqueo de una nueva actuación durante el periodo de \textit{cooldown} y ausencia de riego cuando la humedad medida no requiere actuación. También se observa que la publicación en ThingSpeak se valida mediante la respuesta \texttt{+HTTPACTION: 0,200,3}.

En ejecuciones prolongadas se observaron fallos temporales de publicación HTTP, como errores en \texttt{HTTPINIT} o respuestas no interpretables del módem. Ante estas situaciones, la estación mantuvo la decisión crítica de riego dentro del \textit{firmware} local y conservó un comportamiento seguro de actuación. La consecuencia principal fue la pérdida temporal de publicación en la plataforma, aspecto contemplado en las pruebas de tolerancia a fallos y en el análisis de riesgos.

\section{Secuencia de validación}

Para reducir riesgos durante las pruebas, la validación se realiza de forma gradual. La bomba real se conecta únicamente después de comprobar la lógica de control y el comportamiento del relé.

\begingroup
\small
\renewcommand{\arraystretch}{1.20}
\rowcolors{2}{TableRowSoft}{white}

\begin{longtable}{|
>{\centering\arraybackslash}p{0.08\textwidth}|
>{\raggedright\arraybackslash}p{0.40\textwidth}|
>{\raggedright\arraybackslash}p{0.44\textwidth}|}

\caption{Secuencia de validación del prototipo.}
\label{tab:secuencia_validacion}\\

\hline
\rowcolor{URJCRed}
\TVHead{Paso} & \TVHead{Acción} & \TVHead{Motivo} \\
\hline
\endfirsthead

\hline
\rowcolor{URJCRed}
\TVHead{Paso} & \TVHead{Acción} & \TVHead{Motivo} \\
\hline
\endhead

\hline
\multicolumn{3}{r}{\small Continúa en la página siguiente} \\
\endfoot

\hline
\endlastfoot

1 & Probar sensores y alimentación por separado. & Evitar que un error de cableado afecte al sistema completo. \\
\hline
2 & Probar el módulo LTE con comandos AT básicos. & Confirmar que la comunicación funciona antes de integrarla en el \textit{firmware}. \\
\hline
3 & Publicar datos de prueba en ThingSpeak. & Validar el canal de telemetría antes de automatizar el envío. \\
\hline
4 & Consultar datos desde Raspberry Pi. & Comprobar que la supervisión remota recibe la información esperada. \\
\hline
5 & Validar base de datos, API y \textit{dashboard}. & Confirmar que el \textit{backend} local interpreta y muestra correctamente los datos. \\
\hline
6 & Activar relé sin bomba conectada. & Probar la lógica de actuación sin riesgo hidráulico. \\
\hline
7 & Activar bomba durante tiempos cortos y controlados. & Validar la actuación real con riesgo limitado. \\
\hline
8 & Ejecutar prueba completa con sensores, comunicación, \textit{backend} y riego. & Confirmar el funcionamiento integrado del prototipo. \\
\hline
9 & Realizar la prueba funcional en Agrolab Móstoles. & Comprobar el comportamiento del prototipo en un entorno real de cultivo y registrar evidencias fotográficas y audiovisuales. \\
\hline

\end{longtable}

\normalsize
\endgroup

\section{Pruebas de seguridad funcional}

La seguridad funcional en TierraViva se centra en mantener una actuación segura sobre el sistema de riego. En el alcance de este prototipo, se aplican medidas básicas necesarias para controlar una bomba: arranque con relé apagado, temporización de la actuación, bloqueo por \textit{cooldown} y respuesta conservadora ante lecturas inválidas o errores.

\begingroup
\small
\renewcommand{\arraystretch}{1.20}
\rowcolors{2}{TableRowSoft}{white}

\begin{longtable}{|
>{\raggedright\arraybackslash}p{0.36\textwidth}|
>{\raggedright\arraybackslash}p{0.44\textwidth}|
>{\centering\arraybackslash}p{0.12\textwidth}|}

\caption{Pruebas de seguridad funcional del sistema de riego.}
\label{tab:pruebas_seguridad_funcional}\\

\hline
\rowcolor{URJCRed}
\TVHead{Condición comprobada} & \TVHead{Comportamiento esperado} & \TVHead{Prioridad} \\
\hline
\endfirsthead

\hline
\rowcolor{URJCRed}
\TVHead{Condición comprobada} & \TVHead{Comportamiento esperado} & \TVHead{Prioridad} \\
\hline
\endhead

\hline
\multicolumn{3}{r}{\small Continúa en la página siguiente} \\
\endfoot

\hline
\endlastfoot

Arranque o reinicio de la estación & El relé debe comenzar apagado. & Alta \\
\hline
Orden o decisión de riego con duración excesiva & La duración debe limitarse al máximo permitido. & Alta \\
\hline
Lectura de humedad inválida & El sistema debe mantener la bomba apagada. & Alta \\
\hline
Riegos consecutivos en poco tiempo & El sistema debe aplicar periodo de seguridad. & Alta \\
\hline
Error durante la ejecución & El relé debe apagarse de forma explícita. & Alta \\
\hline
Pérdida temporal de comunicación & La estación debe mantener un estado seguro. & Media \\
\hline
Duplicidad de evento o ciclo de actuación & La estación debe bloquear la repetición de una actuación ya ejecutada. & Media \\
\hline

\end{longtable}

\normalsize
\endgroup

\section{Relación entre riesgos y pruebas}

El plan de pruebas se ha definido teniendo en cuenta los riesgos principales del proyecto. La Tabla \ref{tab:trazabilidad_riesgos_pruebas} muestra la relación entre algunos riesgos identificados y las pruebas previstas.

\begingroup
\small
\renewcommand{\arraystretch}{1.20}
\rowcolors{2}{TableRowSoft}{white}

\begin{longtable}{|
>{\centering\arraybackslash}p{0.10\textwidth}|
>{\raggedright\arraybackslash}p{0.50\textwidth}|
>{\raggedright\arraybackslash}p{0.32\textwidth}|}

\caption{Trazabilidad entre riesgos y pruebas.}
\label{tab:trazabilidad_riesgos_pruebas}\\

\hline
\rowcolor{URJCRed}
\TVHead{Riesgo} & \TVHead{Descripción} & \TVHead{Pruebas asociadas} \\
\hline
\endfirsthead

\hline
\rowcolor{URJCRed}
\TVHead{Riesgo} & \TVHead{Descripción} & \TVHead{Pruebas asociadas} \\
\hline
\endhead

\hline
\multicolumn{3}{r}{\small Continúa en la página siguiente} \\
\endfoot

\hline
\endlastfoot

R01 & Alimentación insuficiente o inestable del módulo LTE. & P01, P05, P06 \\
\hline
R02 & Lecturas incorrectas del sensor de humedad del suelo. & P04, P13, P14 \\
\hline
R03 & Degradación puntual de la comunicación LTE. & P05, P06, P15 \\
\hline
R04 & Indisponibilidad temporal de ThingSpeak. & P06, P07, P15 \\
\hline
R05 & Activación incorrecta o excesiva de la bomba. & P11, P12, P13 \\
\hline
R06 & Daño eléctrico por cableado o integración incorrecta. & P01, P11, P16 \\
\hline
R07 & Exposición ambiental del montaje. & P16, P17 \\
\hline
R08 & Exposición accidental de claves o credenciales. & Revisión de repositorio y ficheros de configuración \\
\hline
R09 & Inconsistencias entre \textit{firmware}, \textit{backend}, API y \textit{dashboard}. & P07, P08, P09, P10, P16 \\
\hline

\end{longtable}

\normalsize
\endgroup

\section{Estados de una prueba}

Para homogeneizar el registro de resultados se utilizarán los siguientes estados:

\begingroup
\small
\renewcommand{\arraystretch}{1.20}
\rowcolors{2}{TableRowSoft}{white}

\begin{longtable}{|
>{\raggedright\arraybackslash}p{0.24\textwidth}|
>{\raggedright\arraybackslash}p{0.68\textwidth}|}

\caption{Estados definidos para el seguimiento de pruebas.}
\label{tab:estados_prueba}\\

\hline
\rowcolor{URJCRed}
\TVHead{Estado} & \TVHead{Significado} \\
\hline
\endfirsthead

\hline
\rowcolor{URJCRed}
\TVHead{Estado} & \TVHead{Significado} \\
\hline
\endhead

\hline
\multicolumn{2}{r}{\small Continúa en la página siguiente} \\
\endfoot

\hline
\endlastfoot

No ejecutada & La prueba está definida pero aún no se ha realizado. \\
\hline
Superada & La prueba cumple todos los criterios de aceptación. \\
\hline
Superada con observaciones & La funcionalidad principal funciona, pero se han detectado aspectos a mejorar o documentar. \\
\hline
Fallida & La prueba no cumple el resultado esperado y requiere corrección. \\
\hline
Bloqueada & La prueba no puede ejecutarse por falta de componente, entorno, configuración o dependencia previa. \\
\hline

\end{longtable}

\normalsize
\endgroup

\section{Conclusión}

El plan de pruebas de TierraViva permite validar el sistema de forma progresiva y controlada. La estrategia planteada comprueba por separado alimentación, sensores, comunicación, almacenamiento, API, \textit{dashboard} y actuación antes de ejecutar la integración completa.

Además, la relación entre riesgos y pruebas refuerza la calidad del proyecto, ya que cada punto crítico identificado dispone de una comprobación asociada. De este modo, la validación del prototipo contempla tanto el funcionamiento en condiciones normales como errores previsibles, situaciones de fallo y medidas de seguridad funcional.
