ltejedorcruz/TierraViva/memoria/anexos/trazabilidad_requisitos_pruebas.tex

\chapter{Matriz de trazabilidad entre requisitos y pruebas}
\label{anexo:trazabilidad_requisitos_pruebas}

Este anexo recoge la trazabilidad entre los requisitos definidos para TierraViva y las pruebas empleadas para validar el prototipo. Su finalidad es demostrar que los requisitos funcionales, no funcionales y operativos quedan vinculados con bloques concretos del sistema y con evidencias de comprobación.

La matriz de trazabilidad conecta tres niveles del proyecto: los requisitos definidos en el Capítulo~\ref{cap:capitulo3}, los bloques técnicos implementados en los Capítulos~\ref{cap:capitulo4}, \ref{cap:implementacion_hardware_firmware} y \ref{cap:implementacion_software_raspberry_nube}, y las pruebas resumidas en el Capítulo~\ref{cap:validacion_pruebas}. El detalle procedimental de cada prueba se recoge en el Anexo~\ref{anexo:plan_pruebas}.

\section{Criterio de trazabilidad}

Para cada requisito se indican los siguientes elementos:

\begin{itemize}
    \item \textbf{Código}: identificador del requisito.
    \item \textbf{Requisito}: descripción resumida del requisito validado.
    \item \textbf{Bloque responsable}: componente o parte del sistema que implementa el requisito.
    \item \textbf{Pruebas asociadas}: casos de prueba definidos en el Anexo~\ref{anexo:plan_pruebas}.
    \item \textbf{Evidencia de validación}: resultado, captura, log, fotografía, registro o comportamiento observado que permite justificar el cumplimiento.
    \item \textbf{Estado}: grado de cobertura alcanzado en el prototipo.
\end{itemize}

El estado \textit{Validado} se utiliza cuando el requisito se ha comprobado mediante pruebas del prototipo. El estado \textit{Cubierto por diseño y documentación} se utiliza para requisitos no funcionales cuya cobertura procede de la arquitectura, los manuales, los anexos técnicos y la reproducibilidad del montaje. El estado \textit{Validado con limitación} se reserva para requisitos cumplidos dentro del alcance del TFG, pero que podrían requerir ensayos más prolongados o mediciones adicionales en una versión industrial.

\section{Trazabilidad de requisitos funcionales}

La Tabla~\ref{tab:trazabilidad_rf} relaciona los requisitos funcionales del sistema con los bloques técnicos responsables, las pruebas realizadas y las evidencias utilizadas para validar su cumplimiento.

\begin{table}[H]
\centering
\scriptsize
\renewcommand{\arraystretch}{1.15}
\rowcolors{2}{TableRowSoft}{white}
\makebox[\textwidth][c]{%
\begin{tabular}{|
>{\raggedright\arraybackslash}p{0.08\textwidth}|
>{\raggedright\arraybackslash}p{0.18\textwidth}|
>{\raggedright\arraybackslash}p{0.22\textwidth}|
>{\raggedright\arraybackslash}p{0.13\textwidth}|
>{\raggedright\arraybackslash}p{0.27\textwidth}|
>{\raggedright\arraybackslash}p{0.10\textwidth}|}
\hline
\rowcolor{URJCRed}
\TVHead{Código} & \TVHead{Requisito} & \TVHead{Bloque responsable} & \TVHead{Pruebas} & \TVHead{Evidencia de validación} & \TVHead{Estado} \\
\hline
RF-01 & Medición de humedad del suelo & Sensor capacitivo de humedad, entrada \texttt{A0} y \textit{firmware} de estación. & P04, P14, P16 & Lectura analógica variable, conversión a porcentaje y publicación de humedad de suelo en telemetría. & Validado \\
\hline
RF-02 & Medición ambiental & Sensor BME280, bus I2C y \textit{firmware} de adquisición. & P02, P16 & Detección I2C del BME280 y lectura de temperatura, humedad relativa y presión. & Validado \\
\hline
RF-03 & Medición de luminosidad & Sensor BH1750/GY-302, bus I2C y \textit{firmware} de adquisición. & P03, P16 & Detección I2C del BH1750 y lectura de luminosidad en lux. & Validado \\
\hline
RF-04 & Envío remoto de telemetría & A7670E-LASA, LTE, comandos AT, HTTP y ThingSpeak. & P05, P06, P16, P17 & Registro LTE, petición HTTP y entrada visible en el canal ThingSpeak correspondiente. & Validado \\
\hline
RF-05 & Identificación de estación & Configuración de estación, canales ThingSpeak, ingesta Raspberry y SQLite. & P07, P08, P10, P16 & Lecturas diferenciadas por estación y canal, con registros asociados a identificador de estación. & Validado \\
\hline
RF-06 & Almacenamiento histórico & Raspberry Pi, proceso de ingesta, \texttt{database.py} y SQLite. & P07, P08, P16 & Inserción de lecturas en la tabla local y conservación de histórico consultable. & Validado \\
\hline
RF-07 & Visualización del estado & FastAPI y \textit{dashboard} web. & P09, P10, P16, P17 & \textit{Dashboard} con última lectura, estado de conexión, gráficas, histórico y selección de estación. & Validado \\
\hline
RF-08 & Decisión local de riego & \textit{Firmware} Arduino, regla de humedad, confirmación de sequedad, \textit{cooldown} y modo seguro. & P13, P14, P16 & Comportamiento de decisión local comprobado ante suelo seco, \textit{cooldown} y lectura inválida. & Validado \\
\hline
RF-09 & Actuación local sobre el riego & Pin \texttt{D7}, módulo relé, bomba de 12 V y función temporizada de actuación. & P11, P12, P13, P16, P17 & Relé conmutado, bomba activada durante el tiempo configurado y apagado explícito al finalizar. & Validado \\
\hline
RF-10 & Publicación de estado de actuación & \textit{Firmware} de estación, campos \texttt{field6}, \texttt{field7}, \texttt{field8}, ThingSpeak e ingesta. & P06, P07, P08, P10, P16 & Publicación de estado del relé, evento de sistema y código auxiliar de diagnóstico. & Validado \\
\hline
RF-11 & Seguridad de funcionamiento & \textit{Firmware}, relé apagado por defecto, límite temporal, \textit{cooldown}, modo seguro y control local. & P11, P12, P13, P14, P15, P16, P17 & Bomba apagada ante arranque, lectura inválida, \textit{cooldown}, pérdida de comunicación o finalización del riego. & Validado \\
\hline
\end{tabular}%
}
\caption{Matriz de trazabilidad de requisitos funcionales.}
\label{tab:trazabilidad_rf}
\end{table}

\section{Trazabilidad de requisitos no funcionales}

Los requisitos no funcionales se validan mediante una combinación de arquitectura adoptada, documentación generada, separación de bloques, facilidad de repetición del montaje y pruebas de integración.

\begin{table}[H]
\centering
\scriptsize
\renewcommand{\arraystretch}{1.15}
\rowcolors{2}{TableRowSoft}{white}
\makebox[\textwidth][c]{%
\begin{tabular}{|
>{\raggedright\arraybackslash}p{0.09\textwidth}|
>{\raggedright\arraybackslash}p{0.20\textwidth}|
>{\raggedright\arraybackslash}p{0.33\textwidth}|
>{\raggedright\arraybackslash}p{0.19\textwidth}|
>{\raggedright\arraybackslash}p{0.13\textwidth}|}
\hline
\rowcolor{URJCRed}
\TVHead{Código} & \TVHead{Requisito} & \TVHead{Criterio de cumplimiento} & \TVHead{Pruebas / anexos} & \TVHead{Estado} \\
\hline
RNF-01 & Modularidad & El sistema está separado en estación, ThingSpeak, Raspberry Pi, SQLite, API y \textit{dashboard}. & P16, arquitectura, diagramas de flujo & Validado \\
\hline
RNF-02 & Bajo coste & Se emplean módulos comerciales accesibles y se documenta el coste del prototipo. & Anexos~\ref{anexo:materiales} y~\ref{anexo:plan_recursos} & Cubierto por documentación \\
\hline
RNF-03 & Reproducibilidad & El montaje, instalación, configuración, librerías, esquemas y pruebas están documentados. & Manual de instalación, esquemas eléctricos, plan de pruebas & Validado \\
\hline
RNF-04 & Facilidad de depuración & El sistema permite probar por separado sensores, LTE, ThingSpeak, Raspberry, API, \textit{dashboard} y actuación. & P01--P10, P16 & Validado \\
\hline
RNF-05 & Consumo razonable & El sistema emplea ciclos configurables y actuación temporizada; la optimización energética completa queda planteada como línea futura. & ET-01, ET-02, ET-05, trabajos futuros & Validado con limitación \\
\hline
RNF-06 & Tolerancia a fallos & Ante fallos de lectura, comunicación o actuación se mantiene un comportamiento seguro. & P13, P14, P15, riesgos & Validado \\
\hline
RNF-07 & Escalabilidad & La arquitectura admite estaciones diferenciadas mediante identificadores y canales separados. & P07, P08, P10, P16 & Validado \\
\hline
RNF-08 & Claridad de visualización & El \textit{dashboard} diferencia lecturas, estados, frescura del dato, gráficas e histórico. & P10, manual de usuario & Validado \\
\hline
RNF-09 & Adecuación académica & El alcance prioriza funciones verificables y diferencia con claridad la versión implementada de las funcionalidades planteadas como trabajo futuro. & Plan de pruebas, conclusiones, trabajos futuros & Cubierto por diseño y documentación \\
\hline
\end{tabular}%
}
\caption{Matriz de trazabilidad de requisitos no funcionales.}
\label{tab:trazabilidad_rnf}
\end{table}

\section{Trazabilidad de especificaciones temporales y operativas}

Las especificaciones temporales y operativas definen el comportamiento esperado del sistema durante su ejecución. Algunas se comprueban directamente mediante pruebas de \textit{firmware} o \textit{dashboard}; otras se documentan como parámetros configurables del prototipo.

\begin{table}[H]
\centering
\scriptsize
\renewcommand{\arraystretch}{1.15}
\rowcolors{2}{TableRowSoft}{white}
\makebox[\textwidth][c]{%
\begin{tabular}{|
>{\raggedright\arraybackslash}p{0.08\textwidth}|
>{\raggedright\arraybackslash}p{0.25\textwidth}|
>{\raggedright\arraybackslash}p{0.18\textwidth}|
>{\raggedright\arraybackslash}p{0.14\textwidth}|
>{\raggedright\arraybackslash}p{0.27\textwidth}|}
\hline
\rowcolor{URJCRed}
\TVHead{Código} & \TVHead{Parámetro} & \TVHead{Valor / criterio} & \TVHead{Pruebas} & \TVHead{Evidencia de validación} \\
\hline
ET-01 & Periodo de lectura de sensores & Configurable & P02, P03, P04, P16 & Ciclos de adquisición observables en monitor serie o \textit{firmware}. \\
\hline
ET-02 & Frecuencia de envío de telemetría & Configurable & P06, P16 & Publicaciones sucesivas en ThingSpeak. \\
\hline
ET-03 & Frecuencia de actualización del \textit{dashboard} & 3--5 s & P10 & \textit{Dashboard} actualizando lecturas y estado sin recarga manual. \\
\hline
ET-04 & Intervalo de evaluación local & Configurable & P13, P14 & Evaluación periódica de sensores, humedad y condiciones de riego. \\
\hline
ET-05 & Tiempo máximo de bomba activa & Configurable & P12, P13, P17 & Bomba apagada tras el intervalo definido por \textit{firmware}. \\
\hline
ET-06 & Tiempo mínimo entre riegos & Configurable & P13 & Segundo riego bloqueado durante \textit{cooldown}. \\
\hline
ET-07 & Tiempo máximo sin dato reciente en supervisión & Configurable & P10, P15 & \textit{Dashboard}/API identifican datos obsoletos u \textit{offline}. \\
\hline
ET-08 & Estado seguro por defecto & Bomba apagada & P11, P14, P15, P17 & Relé apagado al arrancar o ante condición no verificable. \\
\hline
ET-09 & Comportamiento ante dato inválido & Ignorar y registrar & P14 & Bomba apagada y publicación de código de error. \\
\hline
ET-10 & Comportamiento ante pérdida de comunicación & Bomba apagada o actuación bloqueada & P15, P17 & La estación conserva un comportamiento seguro ante pérdida de comunicación. \\
\hline
\end{tabular}%
}
\caption{Matriz de trazabilidad de especificaciones temporales y operativas.}
\label{tab:trazabilidad_et}
\end{table}

\section{Cobertura de pruebas sobre requisitos}

La Tabla~\ref{tab:cobertura_pruebas_requisitos} muestra la relación inversa: qué requisitos cubre cada prueba principal. Esta vista permite comprobar que las pruebas responden a requisitos concretos y mantienen una relación directa con la validación del prototipo.

\begin{table}[H]
\centering
\scriptsize
\renewcommand{\arraystretch}{1.15}
\rowcolors{2}{TableRowSoft}{white}
\begin{tabular}{|p{0.12\textwidth}|p{0.31\textwidth}|p{0.38\textwidth}|p{0.13\textwidth}|}
\hline
\rowcolor{URJCRed}
\TVHead{Prueba} & \TVHead{Descripción resumida} & \TVHead{Requisitos cubiertos} & \TVHead{Tipo} \\
\hline
P01 & Verificación de alimentación y masa común. & RNF-03, RNF-04, RNF-06, ET-08 & Técnica \\
\hline
P02 & Lectura de BME280. & RF-02, RNF-04, ET-01 & Unitaria \\
\hline
P03 & Lectura de BH1750. & RF-03, RNF-04, ET-01 & Unitaria \\
\hline
P04 & Lectura de humedad del suelo. & RF-01, RF-08, RNF-04, ET-01 & Unitaria \\
\hline
P05 & Comunicación AT con A7670E-LASA. & RF-04, RNF-04 & Integración \\
\hline
P06 & Publicación en ThingSpeak. & RF-04, RF-10, ET-02 & Integración \\
\hline
P07 & Consulta desde Raspberry Pi. & RF-05, RF-06, RF-10, RNF-07 & Integración \\
\hline
P08 & Almacenamiento en SQLite. & RF-05, RF-06, RNF-07 & Integración \\
\hline
P09 & API local FastAPI. & RF-07, RNF-04, RNF-08 & Integración \\
\hline
P10 & \textit{Dashboard} web. & RF-07, RF-10, RNF-08, ET-03, ET-07 & Aceptación \\
\hline
P11 & Relé sin bomba. & RF-09, RF-11, ET-08 & Seguridad \\
\hline
P12 & Bomba con activación temporizada. & RF-09, RF-11, ET-05 & Seguridad \\
\hline
P13 & \textit{Cooldown} entre riegos. & RF-08, RF-09, RF-11, ET-06 & Seguridad \\
\hline
P14 & Lectura inválida de humedad. & RF-01, RF-08, RF-11, ET-09 & Seguridad \\
\hline
P15 & Pérdida temporal de comunicación. & RF-04, RF-11, RNF-06, ET-07, ET-10 & Resiliencia \\
\hline
P16 & Integración completa del sistema. & RF-01--RF-11, RNF-01, RNF-04, RNF-06, RNF-07, ET-01, ET-02, ET-04 & Integración \\
\hline
P17 & Prueba funcional en entorno real en Agrolab Móstoles. & RF-04, RF-07, RF-09, RF-11, RNF-06, RNF-08, ET-05, ET-08, ET-10 & Entorno real \\
\hline
\end{tabular}
\caption{Cobertura de requisitos por cada caso de prueba.}
\label{tab:cobertura_pruebas_requisitos}
\end{table}

\section{Requisitos críticos}

Los requisitos con mayor impacto sobre la validez del prototipo son aquellos que afectan directamente a la medición principal, la comunicación remota, el almacenamiento, la actuación física o la seguridad del riego.

\begin{table}[H]
\centering
\small
\renewcommand{\arraystretch}{1.15}
\rowcolors{2}{TableRowSoft}{white}
\begin{tabular}{|p{0.16\textwidth}|p{0.36\textwidth}|p{0.34\textwidth}|}
\hline
\rowcolor{URJCRed}
\TVHead{Requisito} & \TVHead{Motivo de criticidad} & \TVHead{Validación mínima exigible} \\
\hline
RF-01 & La humedad del suelo condiciona la decisión local de riego. & Lectura variable y publicación de humedad de suelo. \\
\hline
RF-04 & La telemetría remota permite supervisar el sistema desde la capa software. & Publicación visible en ThingSpeak mediante LTE/HTTP. \\
\hline
RF-06 & El histórico local permite analizar la evolución del prototipo. & Inserción comprobada en SQLite. \\
\hline
RF-08 & La decisión local define cuándo se actúa sobre el riego. & Prueba de umbral, confirmación, \textit{cooldown} y dato inválido. \\
\hline
RF-09 & La actuación física introduce riesgo hidráulico y eléctrico. & Prueba con relé y bomba temporizada. \\
\hline
RF-11 & Evita activaciones indefinidas o peligrosas. & Relé apagado ante arranque, fallo, \textit{cooldown} o error. \\
\hline
RNF-06 & La tolerancia a fallos sostiene la robustez del prototipo. & Prueba ante fallo de comunicación y lectura inválida. \\
\hline
ET-05 & Limita el tiempo máximo de bomba activa. & Apagado tras tiempo configurado. \\
\hline
ET-08 & Define el estado seguro por defecto. & Relé apagado al arrancar y ante condición no verificable. \\
\hline
\end{tabular}
\caption{Requisitos considerados críticos para la validación del prototipo.}
\label{tab:requisitos_criticos}
\end{table}

\section{Limitaciones de cobertura}

La matriz anterior muestra que los requisitos principales están cubiertos por pruebas del prototipo. Algunos aspectos quedan validados dentro del alcance académico del TFG y delimitan líneas futuras de ampliación, especialmente en certificación industrial, caracterización energética y campañas prolongadas en campo.

\begin{table}[H]
\centering
\small
\renewcommand{\arraystretch}{1.15}
\rowcolors{2}{TableRowSoft}{white}
\begin{tabular}{|p{0.20\textwidth}|p{0.36\textwidth}|p{0.34\textwidth}|}
\hline
\rowcolor{URJCRed}
\TVHead{Aspecto} & \TVHead{Cobertura alcanzada} & \TVHead{Limitación reconocida} \\
\hline
Consumo energético & El sistema funciona con alimentación de 12 V y regulación a 5 V. & La caracterización energética completa y el dimensionamiento solar definitivo quedan como líneas futuras. \\
\hline
Humedad del suelo & El sensor responde y permite una decisión local básica. & La calibración agronómica completa con diferentes sustratos queda como mejora futura. \\
\hline
Conectividad LTE & El módulo publica datos mediante red móvil. & El funcionamiento depende de cobertura, SIM y alimentación estable del módem. \\
\hline
ThingSpeak & La plataforma permite publicar, consultar y visualizar telemetría. & Su uso se orienta a telemetría y supervisión periódica, con latencias compatibles con el alcance del prototipo. \\
\hline
Ensayo en Agrolab Móstoles & El prototipo se valida funcionalmente en un entorno real de cultivo mediante fotografía, capturas y vídeo de funcionamiento. & La prueba permite comprobar funcionamiento integrado en entorno real; el comportamiento estacional, la degradación ambiental y la autonomía energética completa quedan reservados para campañas prolongadas futuras. \\
\hline
\end{tabular}
\caption{Limitaciones de cobertura reconocidas tras la validación.}
\label{tab:limitaciones_cobertura}
\end{table}

\section{Conclusión}

La matriz de trazabilidad muestra que los requisitos definidos para TierraViva están cubiertos por pruebas concretas, bloques técnicos identificables y evidencias de validación. Esta relación refuerza la defensa técnica del proyecto, porque permite seguir el recorrido completo desde la definición del requisito hasta su comprobación experimental.

Los requisitos funcionales quedan cubiertos mediante pruebas de sensórica, comunicación LTE, ThingSpeak, Raspberry Pi, SQLite, API, \textit{dashboard} y actuación local. Los requisitos no funcionales se justifican mediante la arquitectura modular, la documentación de montaje, la estrategia de pruebas y el comportamiento seguro ante fallos. Las especificaciones temporales y operativas quedan relacionadas con pruebas de ciclos, publicación, \textit{dashboard}, \textit{cooldown}, actuación temporizada y estado seguro.

En conjunto, la trazabilidad confirma que TierraViva se valida mediante una relación explícita entre requisitos, implementación, pruebas y evidencias.
