ltejedorcruz/TierraViva/docs/Circuit_Documentation_TierraViva.pdf

Circuit | Documentation
| SUMMARY

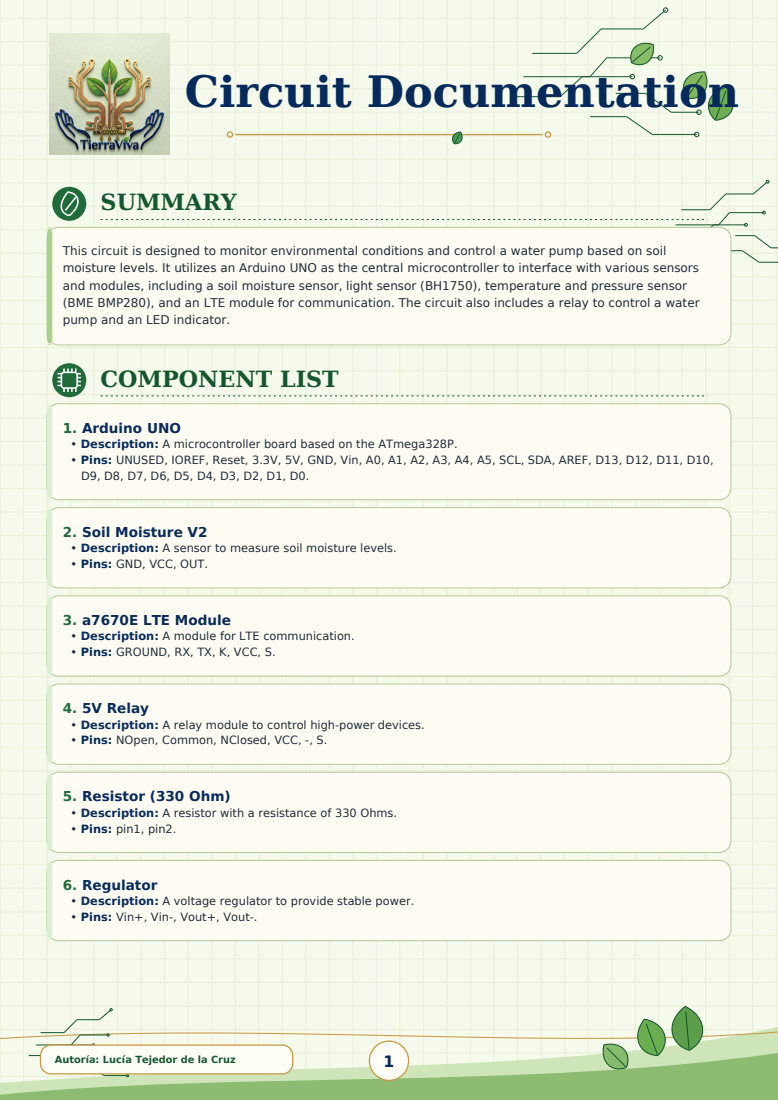
[picture p103: page 1]
Autoría: Lucía Tejedor de la; Cruz; COMPONENT LIST

This circuit is | | designed to monitor environmental conditions | and control a water pump | based on soil
moisture | | levels. It utilizes an | Arduino UNO as the central microcontroller to | | | | | interface with various sensors
and modules, including a soil moisture sensor, light | | | | sensor (BH1750), temperature | | | | | and | pressure sensor
(BME pump and an LED indicator. | BMP280), and an LTE module for communication. | | | | The | circuit also | includes a relay | | | to control a water

1. Arduino | | UNO
• Description: A microcontroller board based on • Pins: UNUSED, IOREF, | | Reset, 3.3V, | 5V, | GND, Vin, A0, A1, A2, A3, A4, A5, SCL, SDA, AREF, D13, D12, D11, | the | ATmega328P. | D10,

2. Soil Moisture | | V2
• Description: A sensor | | to measure | soil | moisture levels.
• Pins: GND, VCC, OUT.

3. a7670E | | LTE Module
• Description: A module for • Pins: GROUND, RX, TX, K, | | LTE VCC, S. | communication.

4. 5V Relay | • Description: A relay module to control | high-power | devices.

• Pins: NOpen, Common, NClosed, VCC, | -, S.

5. Resistor (330 | • Description: A resistor with a | Ohm) | resistance of 330 Ohms.

• Pins: pin1, pin2.

6. Regulator
• Description: A voltage regulator to provide stable | power.
• Pins: Vin+, Vin-, Vout+, Vout-.

# Circuit Documentation

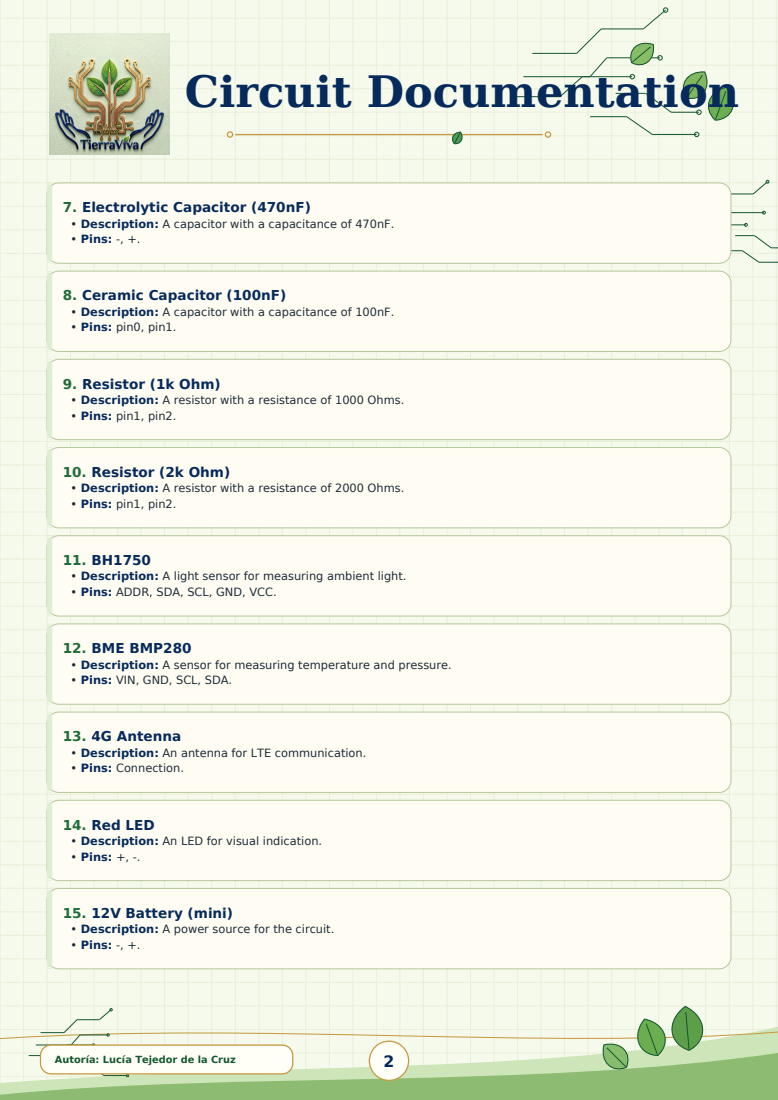
[picture p104: page 2]
Autoría: Lucía Tejedor de la; Cruz

7. Electrolytic Capacitor (470nF)
• Description: A capacitor with | a capacitance of 470nF.
• Pins: -, +.

8. Ceramic Capacitor (100nF)
• Description: A capacitor with | a capacitance of 100nF.
• Pins: pin0, pin1.

9. Resistor (1k Ohm)
• Description: A resistor with a • Pins: pin1, pin2. | resistance of 1000 Ohms.

10. Resistor (2k | • Description: A resistor with a | Ohm) | resistance of 2000 Ohms.

• Pins: pin1, pin2.

11. BH1750
• Description: A light sensor for | | | measuring ambient | light.
• Pins: ADDR, SDA, | SCL, | GND, VCC.

12. BME BMP280
• Description: A sensor | | for | measuring temperature and pressure.
• Pins: VIN, | GND, SCL, SDA.

13. 4G | | Antenna
• Description: An antenna for LTE communication. • Pins: Connection.

14. Red LED | • Description: An LED for visual | indication.

• Pins: +, -.

15. 12V Battery | (mini)
• Description: A power | source for the circuit.

# Circuit Documentation

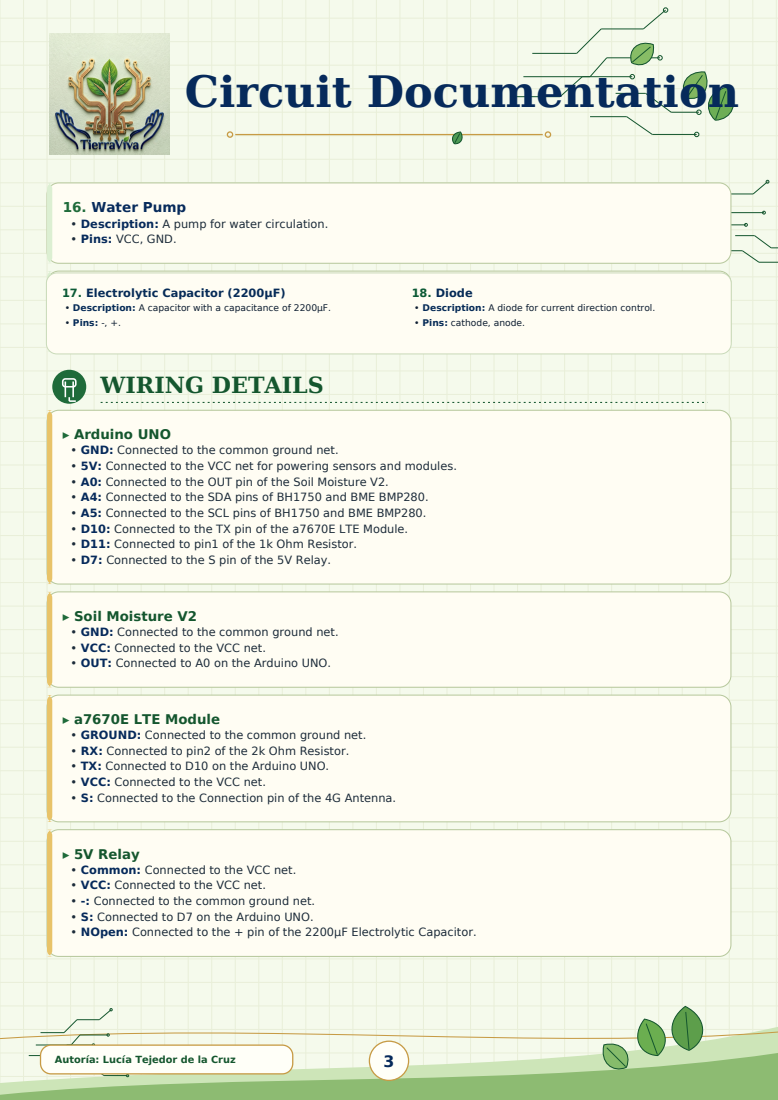
[picture p105: page 3]
Autoría: Lucía Tejedor de la; Cruz; WIRING; DETAILS

16. Water | Pump
• Description: A pump for water circulation.
• Pins: VCC, GND.

17. Electrolytic Capacitor (2200µF) | | | | 18. Diode
• • Pins: -, +. | Description: A capacitor with | a capacitance | of 2200µF. | • • | Description: A Pins: | cathode, | diode for anode. | current direction control.

▸ | Arduino UNO
• GND: • 5V: Connected to the VCC | Connected to the common ground net. | | net for powering | | | sensors | and modules.

• A0: Connected to the OUT | | | pin of the Soil Moisture V2.
• A4: Connected to the SDA • A5: Connected to the SCL pins | | | pins | of BH1750 and BME | | | BMP280.

• D10: Connected to the | | TX | pin of the a7670E LTE Module.
• D11: Connected to pin1 of the • D7: Connected to the S pin of the 5V Relay. | | | | 1k Ohm | Resistor.

▸ | Soil Moisture V2
• GND: • VCC: Connected to the | Connected to the common ground net. | VCC net.

• OUT: Connected to A0 | | on the Arduino UNO.

▸ | a7670E LTE | | | Module
• GROUND: | | Connected to the common ground net.
• RX: Connected to pin2 • TX: Connected to D10 | | | | of the 2k Ohm Resistor. on the Arduino UNO.

• VCC: Connected to the | | | | VCC net.
• S: | Connected to the Connection pin of the 4G Antenna.

▸ | 5V | Relay
• Common: • VCC: Connected to the | | Connected to the VCC net. | VCC net.

• -: | Connected to the common ground net.
• S: • NOpen: Connected to | Connected to D7 on | | the | Arduino + pin of the | UNO. | 2200µF Electrolytic Capacitor.

# Circuit Documentation

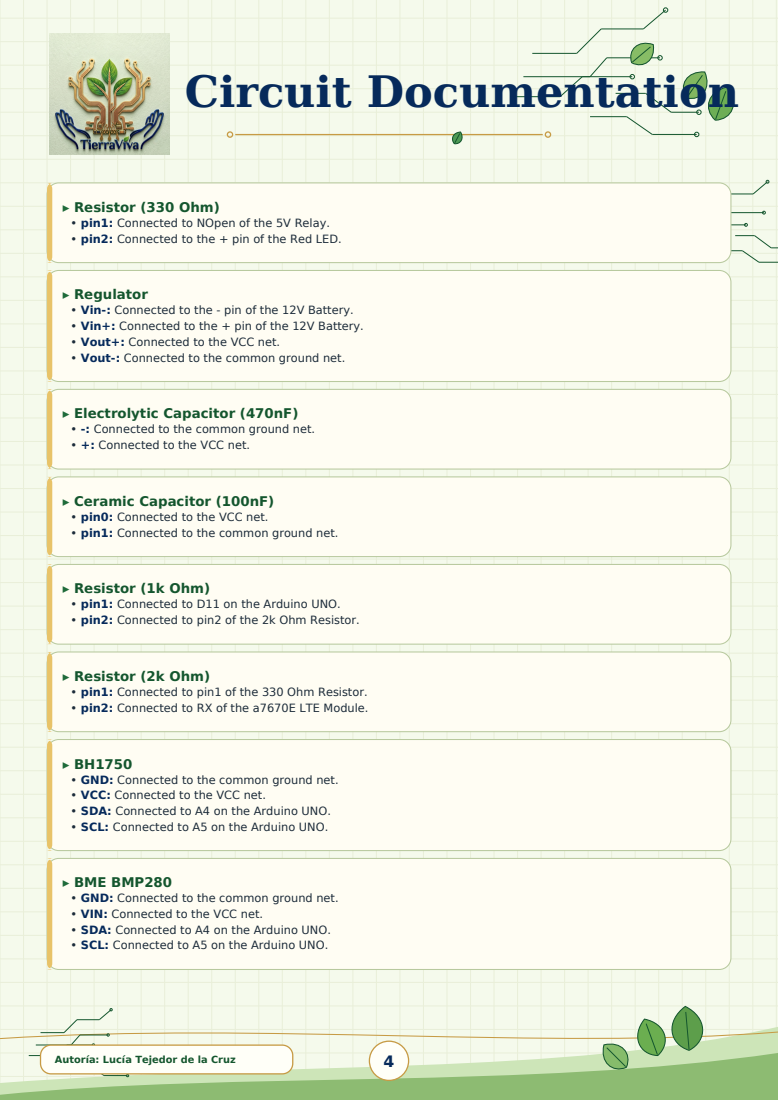
[picture p106: page 4]
Autoría: Lucía Tejedor de la; Cruz

▸ | Resistor | (330 Ohm)
• pin1: | Connected to NOpen | of the 5V Relay.
• pin2: | Connected to the + pin of the Red LED.

▸ | Regulator
• Vin-: Connected to the | | | - pin of the | | | 12V | Battery.
• Vin+: • Vout+: Connected to the VCC | Connected to the + | | | pin of the 12V Battery. | net.

• Vout-: Connected | | to the common ground net.

▸ | Electrolytic | | Capacitor | (470nF)
• -: | Connected to the common ground net.
• +: | Connected to the VCC net.

▸ | Ceramic Capacitor | | (100nF)
• pin0: • pin1: | Connected to the VCC net. Connected to the common ground net.

▸ | Resistor • pin1: | Connected to D11 on the | (1k | Ohm) | Arduino UNO.

• pin2: | Connected to pin2 of the | | | 2k Ohm | Resistor.

▸ | Resistor | (2k | Ohm)
• pin1: | Connected to pin1 of the | | 330 Ohm Resistor.
• pin2: | Connected to RX | of the a7670E LTE Module.

▸ | BH1750
• GND: • VCC: Connected to the | Connected to the common ground net. | | VCC net.

• SDA: Connected to A4 | | | on the Arduino UNO.
• SCL: Connected to | | A5 | on the Arduino UNO.

▸ | BME BMP280
• GND: | Connected to the common ground net.
• VIN: Connected to • SDA: Connected to A4 | | the | VCC net. on the Arduino UNO.

# Circuit Documentation

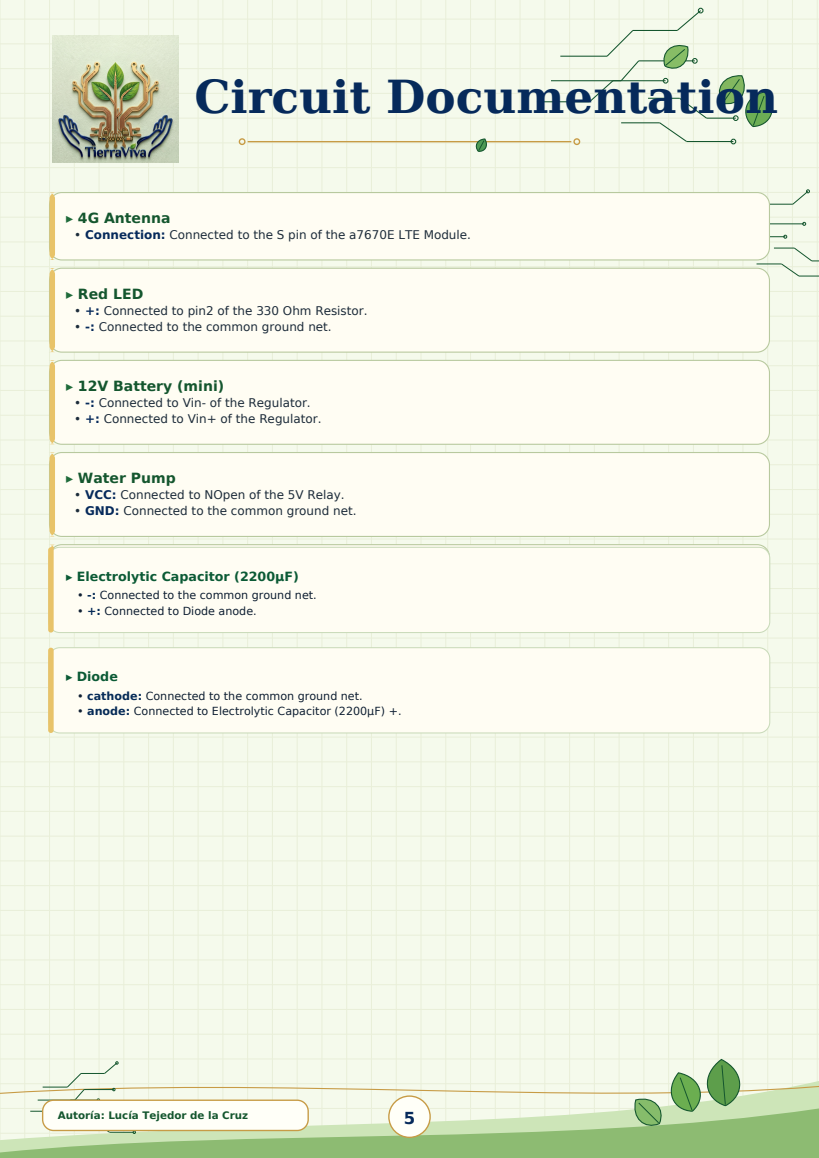
[picture p107: page 5]
Autoría: Lucía Tejedor de la; Cruz

▸ | 4G | Antenna
• Connection: Connected to the | S pin of the | a7670E | LTE | Module.

▸ | Red LED • +: | Connected to pin2 of the 330 Ohm Resistor.

• -: | Connected to the common ground net.

▸ | 12V Battery | | (mini)
• -: | Connected to Vin- of the | | Regulator.
• +: | Connected to Vin+ of the Regulator.

▸ | Water Pump
• VCC: Connected to NOpen • GND: | Connected to the common ground net. | of the 5V Relay.

▸ | Electrolytic Capacitor (2200µF)
• -: • +: Connected to Diode anode. | Connected to | the | common | ground net.

▸ | Diode
• cathode: Connected to • anode: Connected | to Electrolytic Capacitor (2200µF) +. | the common | ground net.
