ltejedorcruz/TierraViva/(commit log)

2026-05-22 Codigo arduino de prototipo MQTT
2026-05-23 Añadidos scketches de prueba Arduino y documentacion A7670E
2026-05-25 Segunda version de la Memoria, rellenado hasta capitulo 5
2026-05-26 Mejora de capitulos 1 al 5, creadas imagenes para cap1
2026-06-01 Mejorados caps 1-5, terminado en cuanto a contenido el cap6, falta reducir
2026-06-01 Añadidos logos de software o herramientas utilizadas
2026-06-06 reduccion del cap 3 por limite de pags
2026-06-06 añadida documentacion del circuito de las estaciones
2026-06-06 añadido enlace correcto para doc del circuito de las estaciones
2026-06-06 recortado cap4 y corregidos errores minimos de bibliografia y algunos anexos
2026-06-06 añadidos estilos de tablas y codigos a capitulos 1-4
2026-06-06 recortado cap5 y añadido explicacion de librerias arduino al anexo
2026-06-07 añadido cap 7, calidacion de pruebas con sus correspondientes anexos
2026-06-07 corregidas frases de cap 3 y 4, corregida referencia de compra de Bomba 12V
2026-06-08 Correcciones de limpieza
2026-06-08 Añadido .ino de la Estacion B del prototipo
2026-06-08 Corregida cabecera de logs para Estaciones A y B
2026-06-10 Corregidos valores para visualizacion en dashboard
2026-06-14 Corregidos cambios del profesor a falta de corregir tema acronimos
2026-06-19 Corregidos acronimos anexo de UNESCO
2026-06-19 Corregidos acronimos anexo Diagramas de flujo
2026-06-19 Corregidos acronimos anexo Gestion de riesgos
2026-06-19 Corregidas referencias a tblas/imagenes del anexo de manual de api
2026-06-19 Corregidos acronimos anexo Materiales
2026-06-20 Corregidos acronimos anexo Plan de Pruebas
2026-06-20 Corregidos acronimos anexo Plan de Recursos
2026-06-20 Corregidos acronimos anexo Seguimiento de Decisiones
2026-06-21 Actualizado diagrama de circuito con condensador para motor bomba de agua y su documentacion correspondiente
2026-06-21 Añadido condensador en memoria y corregido color de tablas
2026-06-21 Alineado memoria con estructura actual de dashboard
2026-06-21 Añadidas evidencias y logs de arduino
2026-06-22 Añadido último capitulo de la memoria
2026-06-23 Añadidas capturs finales del dashboard a la memoria
2026-06-23 Ajustadas horas de trabajo
2026-06-23 Recortada memoria para cumplir longitud de 100 paginas
2026-06-23 Mejorados estilos de anexos y agradecimientos
2026-06-24 Movidas figuras de logo de Mosquitto y SQLite, se habian descolocado
2026-06-24 Mejorados estilos de redacción y añadidos retoques de estilo
2026-06-24 Añadidos .env de ejemplo y requieremts.txt
2026-06-25 Cambiado estructura de frases no es/no depende/no hace por lo que sí es/sí depende/sí hace
2026-06-25 Cambiado estructura de frases no es/no depende/no hace por lo que sí es/sí depende/sí hace en cap8
2026-06-25 Mejorada la explicación de Dashboard Web
2026-06-26 Cambiado estructura de frases no es/no depende/no hace por lo que sí es/sí depende/sí hace en anexos
2026-06-26 Añadida seccion uso de IA generativa, referencias las imagenes y ajustes de tablas para mejor visualizacion
2026-06-26 Más ajustes de tamaños de tablas
2026-07-05 Añadida fotografía de las estaciones remotas en cap7
2026-07-06 Añadida licencia de software
