ltejedorcruz/TierraViva/(notices)

Notices in the files:
memoria/memoria.pdf:
Este trabajo se distribuye bajo los t´erminos de la licencia internacional CC BY-SA
Atribuci´on. Usted debe dar cr´edito de manera adecuada, (https://creativecommons.org/licenses/by-sa/4.0/deed.es#ref-appropriate-credit) brindar un enlace a la
distribuir su contribuci´on bajo la misma licencia (https://creativecommons.org/licenses/by-sa/4.0/deed.es#ref-same-license) del original.
tecnol´ogicas (https://creativecommons.org/licenses/by-sa/4.0/deed.es#ref-technological-measures) que restrinjan legalmente a otras a hacer cualquier uso permitido
